hoanganhidi0822/Self-Blancing-Robot/HardwareDesign/65mm-wheel-1.snapshot.1/蓝色轮胎/图片/1660324081173.jpg

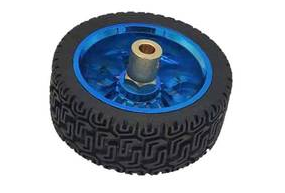
HardwareDesign/65mm-wheel-1.snapshot.1/蓝色轮胎/图片/1660324081173.jpg
