hoanganhidi0822/Self-Blancing-Robot/HardwareDesign/l298-module-1.snapshot.14/L298.PNG

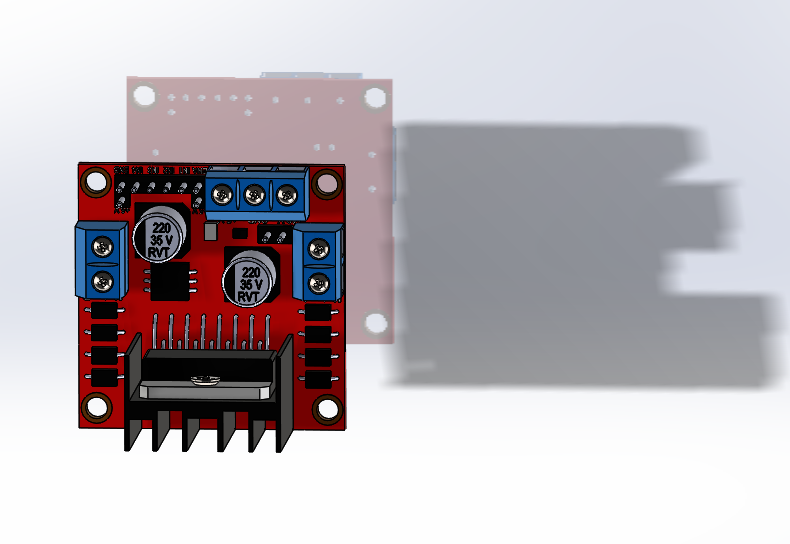
HardwareDesign/l298-module-1.snapshot.14/L298.PNG
