hoanganhidi0822/Self-Blancing-Robot/ThamKhao/Nhom9_SangT4/Nhom9_SangT4/Xe2BanhTuCanBan_PID.docx

BỘ GIÁO DỤC VÀ ĐÀO TẠO

TRƯỜNG ĐẠI HỌC SƯ PHẠM KỸ THUẬT TP.HCM

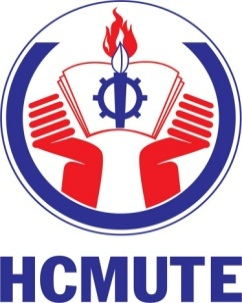
[picture p27: figure]

BÀI BÁO CÁO CUỐI KỲ

THIẾT KẾ, MÔ PHỎNG XE HAI BÁNH TỰ CÂN BẰNG SỬ DỤNG BỘ ĐIỀU KHIỂN PID

TIẾT HỌC: Thứ tư, Tiết 1 - 5

NHÓM THỰC HIỆN : Nhóm 9

GIẢNG VIÊN HƯỚNG DẪN: GV. Nguyễn Văn Đông Hải

Thành viên: Mã số sinh viên:

Bùi Lê Anh 19151099

Nguyễn Ngọc Sơn 19151002

Đào Anh Vũ 19151199

TP.HỒ CHÍ MINH – 11/2021

TRƯỜNG ĐH SƯ PHẠM KỸ THUẬT TPHCM | CỘNG HÒA - XÃ HỘI - CHỦ NGHĨA - VIỆT NAM Độc Lập - Tự Do - Hạnh Phúc
*** | Tp. Hồ Chí Minh, Ngày 21 tháng 11 năm 2021

BÁO CÁO CUỐI KỲ MÔN

THỰC TẬP HỆ THỐNG ĐIỀU KHIỂN TỰ ĐỘNG

Giảng viên hướng dẫn: Thầy Nguyễn Văn Đông Hải

Sinh viên thực hiện: Bùi Lê Anh – 19151099

Nguyễn Ngọc Sơn – 19151002

Đào Anh Vũ – 19151199

Tên đề tài: Thiết kế, mô phỏng xe hai bánh tự cân bằng sử dụng bộ điều khiển PID

Nhận xét của giảng viên:

………………………………………………………………………………………

………………………………………………………………………………………

………………………………………………………………………………………

………………………………………………………………………………………

………………………………………………………………………………………

………………………………………………………………………………………

………………………………………………………………………………………

………………………………………………………………………………………

………………………………………………………………………………………

………………………………………………………………………………………

………………………………………………………………………………………

………………………………………………………………………………………

Ngày 21 tháng 11 năm 2021

Giảng viên chấm điểm

# Chương 1: GIỚI THIỆU

## 1.1 Đặt vấn đề

Tự động hóa đang là xu hướng phát triển của thế giới, dần thay thế nhân công bằng các thiết bị máy móc tự động trong dây chuyển sản xuất. Nghiên cứu về robot đặc biệt là robot di động là một phần quan trọng trong ngành tự động hóa. Xe hai bánh tự cần bằng là một đề tài rất quen thuộc và được rất nhiều kỹ sư trên thế giới chú ý. Ta phải thiết kế bộ điều khiển sao cho xe có thể cân bằng trong mọi địa hình, trong bất cứ thời tiết nào và trong bất kỳ tình huống nào. Từ đó ta có thể ứng dụng vào đời sống giúp giảm thiểu tai nạn khi xe mất tự chủ hay áp dụng vào các nhà máy vận chuyển hàng giảm thiểu tối đa về kinh tế,…. Chúng em nhận thấy được tầm quan trọng trong nghiên cứu về xe hai bánh tự cân bằng nên chúng em đã chọn đề tài: “Thiết kế mô hình xe hai bánh tự cân bằng với bộ điều khiển PID”. Do kiến thức và kinh nghiệm vẫn chưa nhiều nên sẽ có những sai sót trong bài báo cáo, mong thầy và các bạn đọc thông cảm.

## 1.2 Mục tiêu nghiên cứu

+ Nắm cơ bản các khái niệm về robot di động

+ Ứng dụng lý thuyết đã học để thiết kế thành công bộ điều khiển cho xe hai bánh tự cân bằng.

+ Rèn luyện kỹ năng mô phỏng dung MATLAB và SIMULINK

+ Hiểu các quy trình nghiên cứu và thiết kế một hệ thống.

## 1.3 Phương pháp nghiên cứu

+ Đọc sách và tham khảo các nguồn trên mạng mô phỏng xe hai bánh tự cân bằng

+ Tìm kiếm các báo về giải thuật PID cho xe tự cân bằng

+ Tham khảo giảng viên hướng dẫn và bạn bè

+ Thực hiện chứng minh lý thuyết và mô phỏng song song.

## 1.4 Bố cục của đề tài

Chương 1 : Giới thiệu đề tài

Chương 2: Cơ sở lý thuyết về bộ điều khiển PID

Chương 3: Mô phỏng

Chương 4: Kết luận

# Chương 2: CƠ SỞ LÝ THUYẾT

## 2.1 Bộ điều khiển PID

Một hệ thống làm việc tốt là một hệ thống hoạt động tối ưu theo một tiêu chuẩn đạt ra nhất định (đạt cực trị). Trạng thái tối ưu có đạt được và duy trì hay không tùy thuộc vào vào yêu cầu chất lượng đặt ra, các tác động lên đối tượng và điều kiện làm việc của đối tượng. Một trong những bộ điều khiển giúp đối tượng có thể hoạt động tối ưu theo ý muốn của người sử dụng là bộ điều khiển PID

Ta có sơ đồ bộ điều khiển PID như sau:

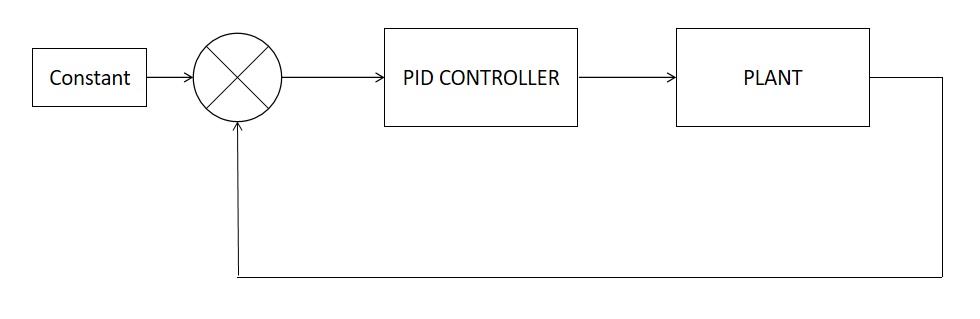
[picture p28: figure]

Hinh 1: Sơ đồ bộ điều khiển PID

Để thiết kế bộ điều khiển PID ta phải thiết bộ điều khiển hồi tiếp âm để được giá trị sai số giữa ngõ ra với giá trị đặt sau đó đưa vào bộ điều khiển PID. Từ bộ PID sẽ cấp điện áp để điều khiển 2 động cơ sao cho hệ thống đạt vị trí cân bằng

## 2.2 Mô hình và các ký hiệu

Ta có mô hình xe hai bánh tự cân bằng như sau:

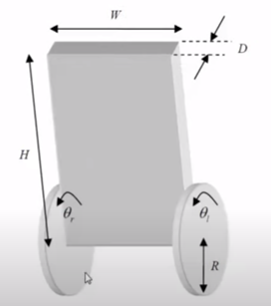
[picture p29: figure]

Mô hình xe hai bánh tự cân bằng

Một số ký hiệu đặc trưng cho xe 2 bánh tự cân bằng:

Kí hiệu | Đơn vị | Ý nghĩa
Mp | Kg | Khối lượng robot
Mw | Kg | Khối lượng bánh xe
R | m | Bán kính bánh xe
θ_P | rad | Góc nghiêng của thân robot
θ_w | rad | Góc xoay của bánh xe
θ_W | Rad/s | Vận tốc góc của bánh xe
r | Ohms | Điện trở của động cơ
L | H | Cuộn cảm của động co
kf | Nms/rad | Hệ số ma sát
km | Nm/A | Hệ số moment
Ke | Vs/rad | Hệ số Back emf của động cơ
α | rad/s^2 | Gia tốc góc của động cơ
Va | V | Điện áp cấp cho động cơ
Ve | V | Điện áp phần ứng
i | A | Dòng điện phần ứng
IR | Kgm2 | Moment quán tính của động cơ
τ_m | Nm | Moment của động cơ
Iw | | Moment quán tính của bánh xe
Ip | | Moment quán tính của thân xe
HL,HRPL,PR | | Lực tác động giữa bánh xe và thân robot
l | | Khoảng cách từ tâm bánh xe đến tâm trọng trường của thân xe
CL,CR | | Moment động cơ tác động lên bánh xe
HfL,HfR | | Lực ma sát giữa bánh xe và mặt phẳng
β | | Hệ số hiệu chỉnh

## 2.3 Mô hình động học của xe động cơ DC

[θω]=[0, 10, (−k_m k_e)/(I_R R)][θω]+[0, 0(k_m)/(I_R R), (−1)/(I_R)][V_a τ_a ] (1)

## 2.4 Mô hình động học cho hệ xe 2 bánh tự cân bằng

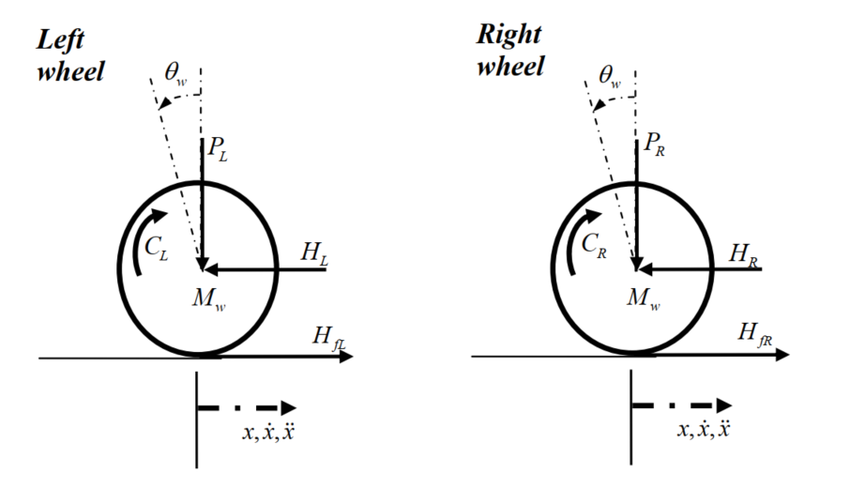
[picture p30: figure]

Phân tích lực tác động lên 2 bánh xe

- Áp dụng định luật Newton tính được tổng lực tác động lên bánh xe theo phương ngang

∑ F_x =Ma (2)

M_w x=H_(fR) −H_R (3)

- Tổng lực tác động vào trục bánh xe

∑ M_o =Iα (4)

I_w θ_w =C_R −H_(fR) r (5)

- Từ phương trình động học của động cơ DC, ta có moment của động cơ

τ_m =I_R (dω)/(dt)+τ_a (6)

- Từ phương trình động học và phương trình vi phân của động cơ DC, ta có moment ngõ ra của động cơ

C=I_R (dω)/(dt)=(−k_m k_e)/Rθ_w +(k_m)/RV_a (7)

- Thay phương trình (7) vào phương trình (5) ta được:

I_w θ_w =(−k_m k_e)/Rθ_w +(k_m)/RV_a −H_(fR) r (8)

- Suy ra:

H_(fR) =(−k_m k_e)/(Rr)θ_w +(k_m)/(Rr)V_a −(I_w)/rθ_w (9)

- Phương trình cho bánh trái

M_w x=(−k_m k_e)/(Rr)θ_w +(k_m)/(Rr)V_a −(I_w)/rθ_w −H_L (10)

- Phương trình cho bánh phải

M_w x=(−k_m k_e)/(Rr)θ_w +(k_m)/(Rr)V_a −(I_w)/rθ_w −H_R (11)

- Vì chuyển động tuyến tính tác dụng lực lên trục động cơ, vận tốc góc có thể chuyển thành vận tốc tuyến tính theo phương trình sau:

θ_w r=x ⟹θ_w =x/r

θ_w r=x ⟹θ_w =x/r

- Từ 2 phương trình trên ta có thể có phương trình của bánh trái và phải như sau:

M_w x=(−k_m k_e)/(Rr)x/r+(k_m)/(Rr)V_a −(I_w)/rx/r−H_L

M_w x=(−k_m k_e)/(Rr)x/r+(k_m)/(Rr)V_a −(I_w)/rx/r−H_R

- Tính tổng 2 phương trình 2 bánh:

2(M_w +(I_w)/(r^2))x=(−2k_m k_e)/(Rr^2)x+(2k_m)/(Rr^2)V_a −(H_L +H_R ) (12)

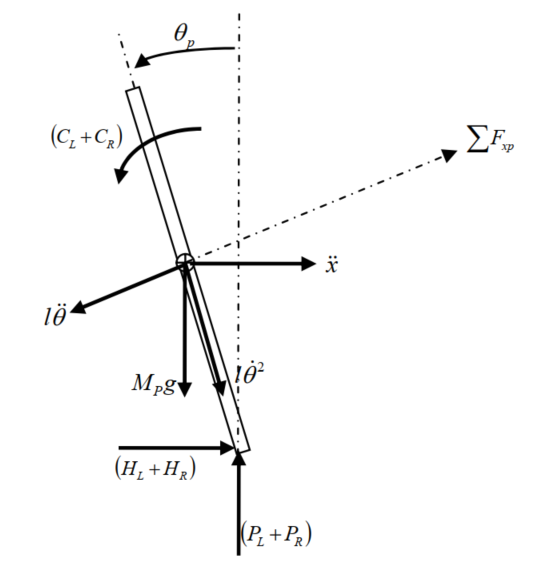
[picture p31: figure]

Phân tích lực tác động lên thân bánh xe

- Áp dụng định luật Newton tính được tổng lực tác động lên bánh xe theo phương ngang

∑ F_x =M_p x

(H_L +H_R )−M_p lθ_p cosθ_p +M_p lθ^2 _p sinθ_p =M_p x

- Ta được:

(H_L +H_R )=M_p x+M_p lθ_p cosθ_p +M_p lθ^2 _p sinθ_p (13)

- Lực vuông góc tác động lên thân xe:

∑ F_(xp) =M_p xcosθ_p

(H_L +H_R )cosθ_p +(P_L +P_R )sinθ_p −M_p gsinθ_p −M_p lθ_p =M_p xcosθ_p (14)

- Tổng moment tác động lên trọng tâm của thân xe:

∑ M_o =Iα

−(H_L +H_R )lcosθ_p −(P_L +P_R )lsinθ_p −(C_L +C_R )=I_p θ_p (15)

- Ta có:

C_L +C_R =(−2k_m k_e)/Rx/r+(2k_m)/RV_a

- Thay vào phương trình 15 ta có:

−(H_L +H_R )lcosθ_p −(P_L +P_R )lsinθ_p −((−2k_m k_e)/Rx/r+(2k_m)/RV_a )=I_p θ_p (16 )

- Nhân -l vào phương trình (14) và thế phương trình 16 vào đó ta có:

I_p θ_p −(2k_m k_e)/(Rr)x+(2k_m)/RV_a +M_p glsinθ_p +M_p l^2 θ_p =−M_p lxcosθ_p (18)

- Thế phương trình 13 vào 12 ta có:

2(M_w +(I_w)/(r^2))x=(−2k_m k_e)/(Rr^2)x+(2k_m)/(Rr^2)V_a −M_p x−M_p lθ_p cosθ_p +M_p lθ^2 _p sinθ_p (19)

- Hai phương trình (18) (19) là hệ phương trình phi tuyến của hệ thống. Để tuyến tính hóa mô hình trên ta cho θ_p =π+ϕ với ϕ là 1 góc nhỏ theo phương thẳng đứng lên trên. Từ đó ta có:

cosθ_p =−1

sinθ_p =−ϕ

((dθ_p)/(dt))^2 =0

- Từ đó ta có mô hình tuyến tính hóa của hệ thống:

(I_p +M_p l^2 )ϕ−(2k_m k_e)/(Rr)x+(2k_m)/RV_a −M_p glϕ=M_p lx (20)

(2k_m)/(Rr)V_a =(2M_w +(2I_w)/(r^2)+M_p )x+(2k_m k_e)/(Rr^2)x−M_p lϕ (21)

- Để có được mô hình biến trạng thái của hệ thống ta rút các biến trạng thái từ phương trình (20) và (21), ta có:

ϕ=(M_p l)/(I_p +M_p l^2)x+(2k_m k_e)/(Rr(I_p +M_p l^2 ))x−(2k_m)/(R(I_p +M_p l^2 ))V_a +(M_p gl)/(R(I_p +M_p l^2 ))ϕ

x=(2k_m)/(Rr(2M_w +(2I_w)/(r^2)+M_p ))V_a −(2k_m k_e)/(Rr^2 (2M_w +(2I_w)/(r^2)+M_p ))x+(M_p l)/((2M_w +(2I_w)/(r^2)+M_p ))ϕ

- Bằng cách thay 2 phương trình trên vào lần lượt các phương trình (20) và (21) ta được hệ không gian trạng thái như sau:

[xϕ]=[0, 1, 0, 0, (2k_m k_e (M_p lr−I_p −M_p l^2 ))/(Rr^2 α), (M_p ^2 gl^2)/α, 000, 0(2k_m k_e (rβ−M_p l))/(Rr^2 α), 0(M_p glβ)/α, 10][xϕ]+[0(2k_m (I_p +M_p l^2 −M_p lr))/(Rr^2 α)0(2k_m (M_p l−rβ))/(Rrα)]V_a

- Với:

β=(2M_w +(2I_w)/(r^2)+M_p )

α=[I_p β+2M_p l^2 (M_w +(I_w)/(r^2))]

Với mô hình trên, chỉ đúng khi xe luôn nằm trên mặt phẳng và bỏ qua ma sát của bánh xe với mặt phẳng, và lực tác động là không đáng kể

# Chương 3: MÔ PHỎNG

## 3.1 Khai báo, khảo sát hệ thống và xây dựng bộ điều khiển

- Đầu tiên để tiến hành xây dựng bộ điều khiển ta cần khai báo giá trị của các biến trong hệ thống cũng như khảo sát hệ thống có điều khiển được hay không và có thể quan sát được các biến trạng thái hay không cũng như tính ổn định của hệ thống.

### 3.1.1 Khai báo thông số hệ thống

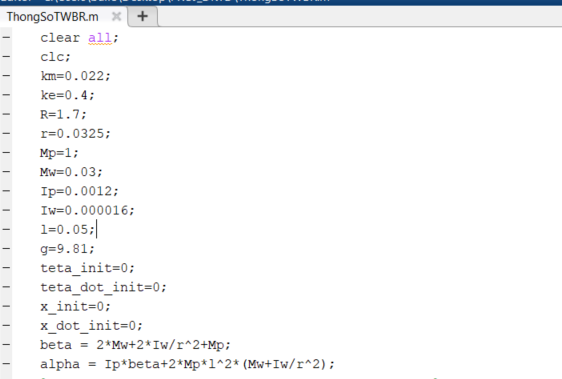
[picture p32: figure]

### 3.1.2 Khảo sát tính ổn định của hệ thống

- Sử dụng MATLAB để tính hàm truyền và nghiệm của hệ thống

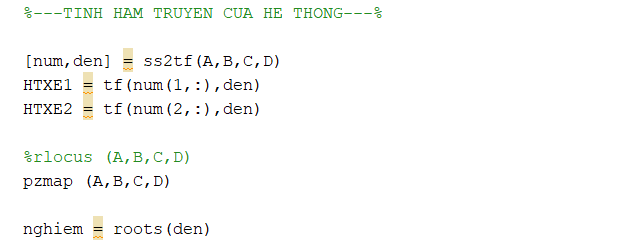
[picture p33: figure]
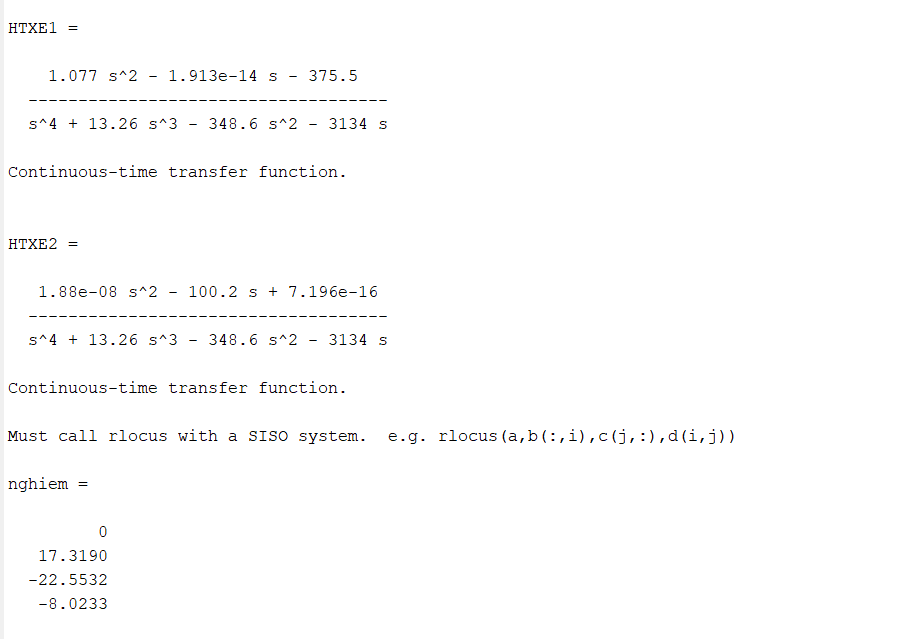
[picture p34: figure]
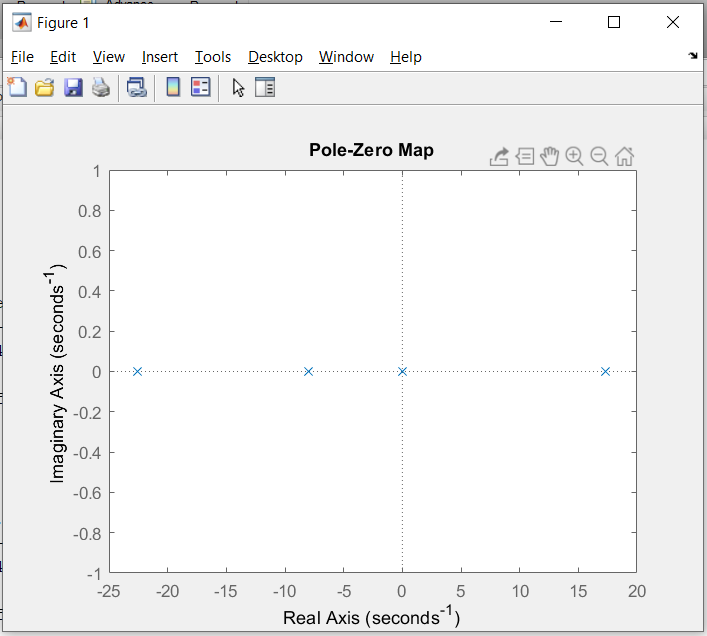
[picture p35: figure]

- Dựa vào nghiệm của hàm truyền và các cực, zero của hệ thống ta có thể kết luận hệ thống không ổn định theo tiêu chuẩn Routh Hurwitz.

### 3.1.3 Khảo sát tính điều khiển được của hệ thống

- Dựa vào lí thuyết điều khiển tự động với 1 hệ tuyến tính có phương trình không gian trạng thái dạng như sau:

x=Ax+Bu

y=Cx+Du

- Với A∈ℝ^(nxn) , B∈ℝ^(nxu) , C∈ℝ^(rxn) , D∈ℝ^(rxm)
- Xây dựng ma trận điều khiển:

P=[B, AB, A^2 B,...,A^(n−1) B]

- Điều kiện cần và đủ để một hệ thống mô tả toán học dưới dạng phương trình trạng thái điều khiển được là rank(P)=n. Với n là số biến trạng thái của hệ thống.
- Ta sử dụng matlab để kiểm chứng hệ thống

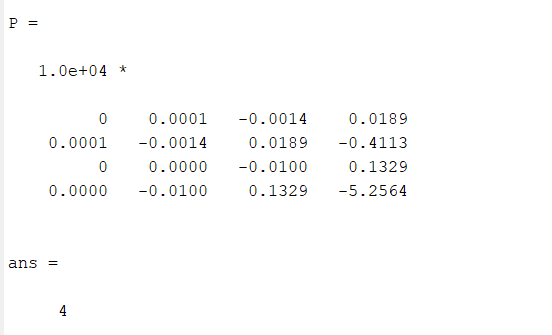
[picture p36: figure]

Bậc của ma trận P bằng với số biến trạng thái của hệ thống

### 3.1.4 Khảo sát tính quan sát được của hệ thống

- Ta lựa chọn ma trận C=[1, 0, 0, 00, 0, 1, 0]
- Ta có C.x(t) = [1, 0, 0, 00, 0, 1, 0][xxϕϕ]=[x, ϕ]
- Xây dựng ma trận quan sát:

L=[C, AC, A^2 C, ..., A^(n−1) C]

- Ta sử dụng matlab để kiểm chứng hệ thống

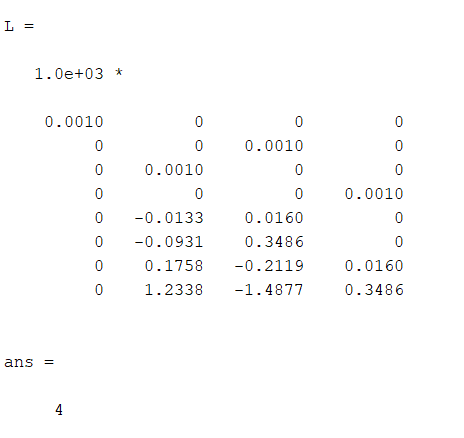
[picture p37: figure]

Bậc của ma trận P bằng với số biến trạng thái của hệ thống

- Nhận xét: Từ 2 kiểm chứng trên ta có thể kết luận hệ thống có thể điều khiển được và ta có thể quan sát được cả 4 biến trạng thái của hệ thống. Và thông qua việc ta đặt ma trận C để có thể quan sát được 2 biến trạng thái là vị trí xe và góc nghiêng của xe thì nếu như 2 biến này ổn định thì có cả hệ thống sẽ ổn định.

### 3.1.5 Xây dựng bộ điều khiển

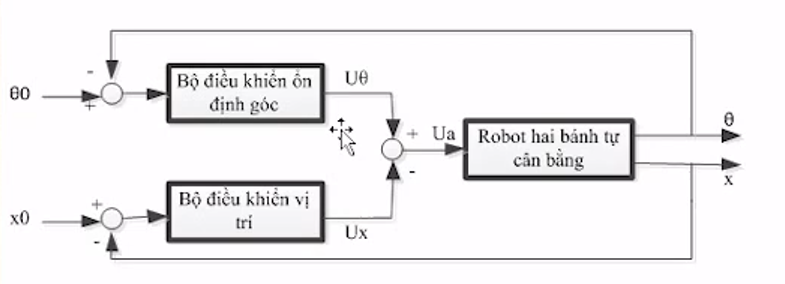
[picture p38: figure]

Mô tả hệ thống với bộ điều khiển

- Ở hệ thống điều khiển xe 2 bánh tự cân bằng, ta phải điều khiển ổn định 2 tham số là góc nghiêng và vị trí của hệ thống nên ta tách ra thành 2 bộ điều khiển song song hoặc lồng nhau và hiệu chỉnh các thông số Kp Ki Kd để điều khiển được điện áp cấp cho động cơ để có được đáp ứng mong muốn.
- Để điều khiển ổn định được xe cân bằng trước tiên ta phải hiệu chỉnh ổn định được góc nghiêng của xe trước sau đó ta hiệu chỉnh để ổn định tiếp bộ điều khiển vị trí cho xe.

## 3.2 Xây dựng mô hình Matlab Simulink

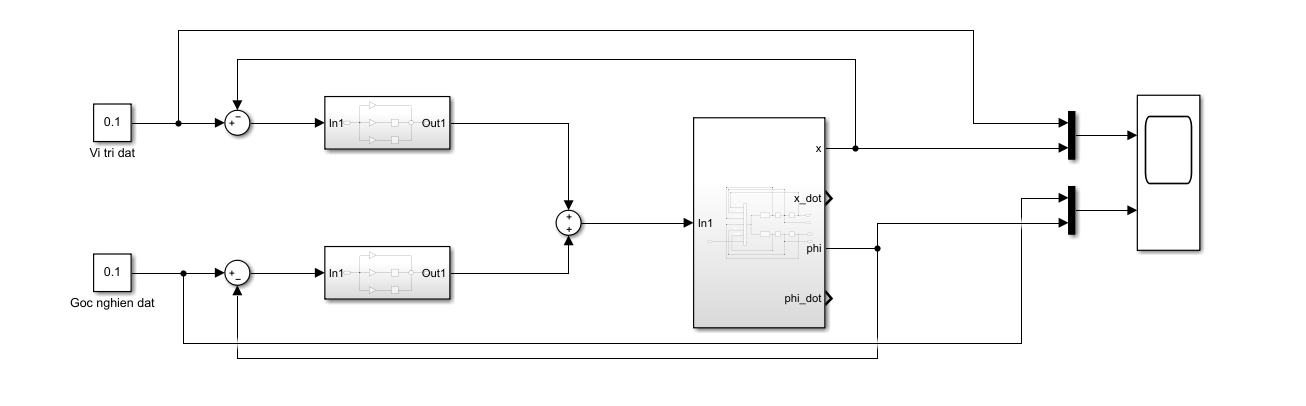
[picture p39: figure]

Toàn bộ hệ thống với bộ điều khiển

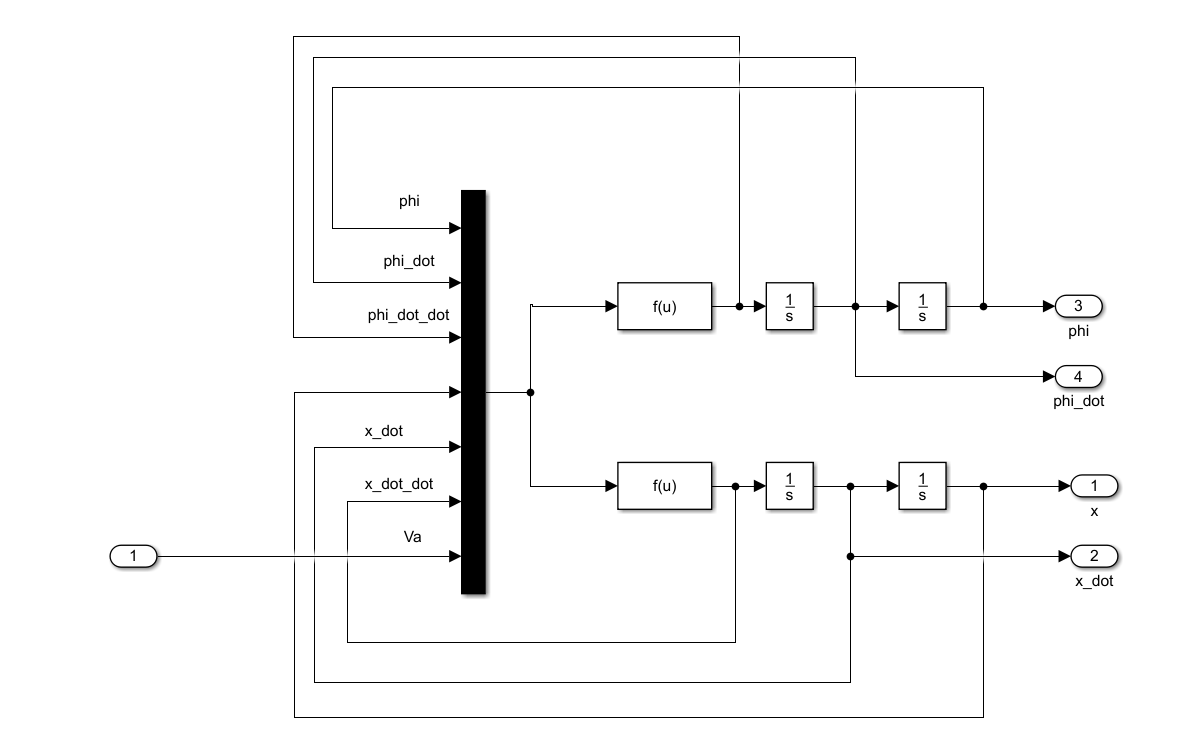
[picture p40: figure]

Khối mô tả phương trình không gian trạng thái của hệ thống

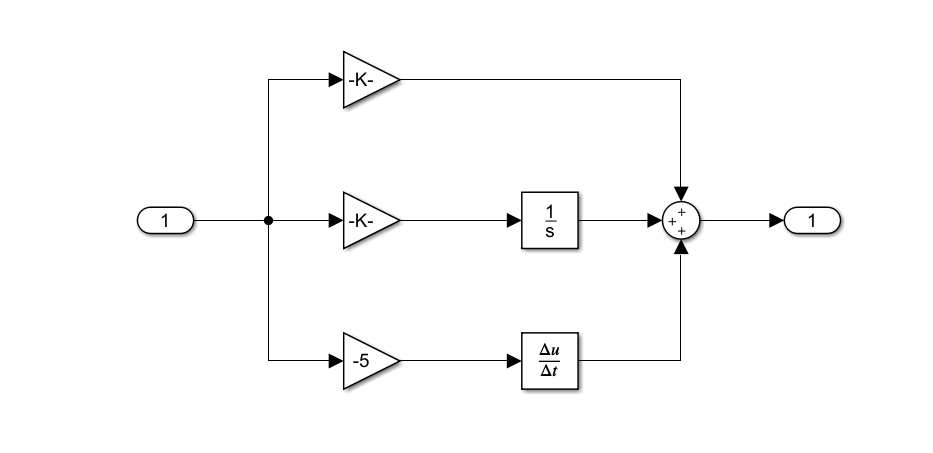
[picture p41: figure]

Bộ điều khiển PID vị trí của hệ thống với Kp = 1143, Ki = 1940.4, Kd = -5

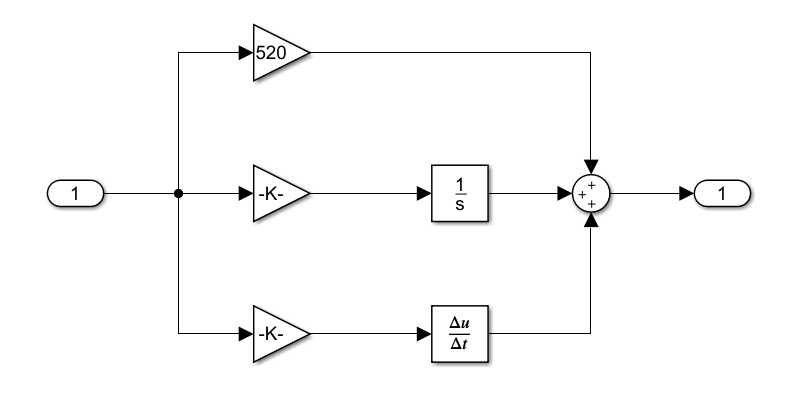
[picture p42: figure]

Bộ điều khiển PID góc nghiêng của hệ thống Kp = 520, Ki = 1550.5, Kd = 23.28

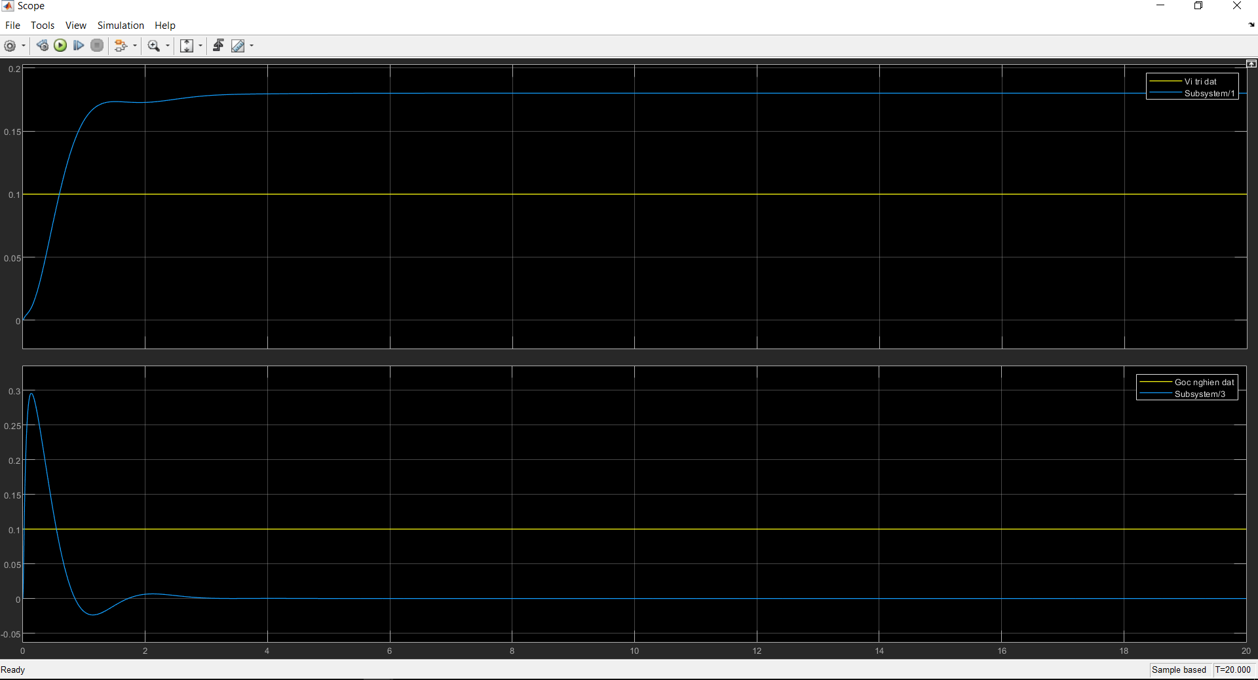
[picture p43: figure]

Đáp ứng của hệ thống

- Nhận xét: Qua quá trình thử sai và có thử qua giải thuật di truyền để tìm được thông số PID phù hợp với hệ thống nhóm đã điều khiển đạt được xe 2 bánh tự cân bằng. Hệ thống ổn định với thời gian trong khoảng 3s cũng như có độ vọt lố chấp nhận được đối với bộ điều khiển vị trí và điều khiển được xe tự cân bằng với góc nghiêng bằng 0 độ. Nhóm thử qua giải thuật pid_GA của thầy Huỳnh Thái Hoàng qua sự hướng dẫn của thầy Nguyễn Văn Đông Hải tuy nhiên nhóm vẫn chưa đạt được kết quả mong muốn, nhóm sẽ tìm hiểu thêm về giải thuật di truyền và hoàn thiện trong tương lai.

# Chương 4: KẾT LUẬN

## 4.1 Kết quả

Theo kết quả đã mô phỏng ở trên, ta nhận thấy khi thay đổi giá trị đặt ban đầu thì hệ thống sẽ đáp ứng lâu hơn, độ vọt lố cũng tăng hơn. Mặc dù vậy nhưng xe vẫn có thể ổn định sau một khoảng thời gian. Vì vậy ta có thể sử dụng bộ điều khiển PID để sử dụng cho xe 2 bánh tự cân bằng nhưng phải chọn các thông số ban đầu sao cho hợp lý.

## 4.2 Hướng phát triển

- Kết hợp xe hai bánh tự cân bằng dùng bộ điều khiển PID kết hợp với LQR
- Khảo sát xe trên một số môi trường không bằng phẳng
- Kết hợp một số phương pháp để điều khiển được xe

## 4.3 Nhận đinh chung

Qua việc “Thiết kế xe hai bánh tự cân bằng sử dụng bộ điều khiển PID” đã giúp cho nhóm hiểu thêm về các bộ điều khiển và các hệ thống ở bộ môn Hệ thống điều khiển tự động. Ngoài ra còn giúp chúng em hiểu rõ hơn các kiến thức, kỹ năng sử dụng phần mềm mô phỏng những hệ thống thực cụ thể ở đây là Matlab.

Sau một thời gian được giao nhiệm vụ thiết kế về bài tập lớn bên trên, dưới sự hướng dẫn tận tình của giảng viên, cùng các bạn trong bộ môn chúng em đã hoàn thành nhiệm vụ của mình. Do thời gian có hạn, chưa có nhiều kinh nghiệm thực tế, bài báo cáo của chúng em không tránh khỏi thiếu sót, rất kính mong thầy thông cảm. Chúng em cảm ơn thầy vì đã hết sức hỗ trợ chúng em trong thời gian thực hiện bài tập lơns, chúng em sẽ cố gắng nâng cao kiến thức cũng như kỹ năng của mình để có thể áp dụng vào đời sống sau này.
