hoanganhidi0822/Self-Blancing-Robot/xecanbang-dieu-khien-xe-hai-banh-tu-can-bang-voi-thuat-toan-pid.pdf

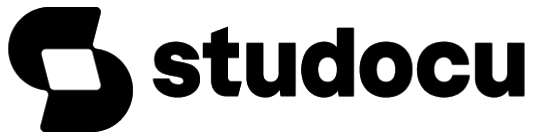
[picture p44: figure]

Studocu is not sponsored or endorsed by any college or university

# Xecanbang - điều khiển xe hai bánh tự cân bằng với thuật

toán PID (https://www.studocu.com/vn/document/truong-dai-hoc-bach-khoa-dai-hoc-da-nang/ky-thuat-do-luong/xecanbang-dieu-khien-xe-hai-banh-tu-can-bang-voi-thuat-toan-pid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)

Kỹ thuật đo lường (Trường Đại học Bách Khoa - Đại học Đà Nẵng) (https://www.studocu.com/vn/course/truong-dai-hoc-bach-khoa-dai-hoc-da-nang/ky-thuat-do-luong/5149461)

Downloaded by Hoàng Anh Phan V?n (hoanganh2282003@gmail.com)

lOMoARcPSD|10675608

BỘ GIÁO DỤC VÀ ĐÀO TẠO

TRƯỜNG ĐẠI HỌC SƯ PHẠM KỸ THUẬT TP. HỒ CHÍ MINH

KHOA ĐIỆN – ĐIỆN TỬ

BỘ MÔN TỰ ĐỘNG ĐIỀU KHIỂN

## ĐỒ ÁN TỐT NGHIỆP

NGÀNH: CÔNG NGHỆ ĐIỆN TỰ ĐỘNG

ĐỀ TÀI:

# MÔ HÌNH ROBOT HAI BÁNH TỰ CÂN BẰNG

GVHD : TS. NGUYỄN MINH TÂM

SVTH: | Cù Minh Phước
| Nguyễn Khắc Mẫn
MSSV: | 09118042
| 09118032

Tp. Hồ Chí Minh 07/2013

Phần A: Giới thiệu

### PHẦN A

# GIỚI THIỆU

Đồ án tốt nghiệp | Trang 1

ĐỒ ÁN ĐƯỢC HOÀN THÀNH TẠI

TRƯỜNG ĐẠI HỌC SƯ PHẠM KỸ THUẬT TP. HỒ CHÍ MINH

Cán bộ hướng dẫn: | TS. Nguyễn Minh Tâm
Sinh viên thực hiện: | Cù Minh Phước
| Nguyễn Khắc Mẫn
Cán bộ chấm phản biện: | |

Đồ án tốt nghiệp được bảo vệ tại HỘI ĐỒNG CHẤM BẢO VỆ ĐỒ ÁN TỐT NGHIỆP TRƯỜNG ĐẠI HỌC SƯ PHẠM KỸ THUẬT TP. HỒ CHÍ MINH.

Ngày ... tháng 07 năm 2013

TRƯỜNG ĐH SƯ PHẠM KỸ THUẬT | CỘNG HÒA XÃ HỘI CHỦ NGHĨA VIỆT NAM
TP. HỒ CHÍ MINH | ĐỘC LẬP - TỰ DO - HẠNH PHÚC

KHOA ĐIỆN - ĐIỆN TỬ

Tp. HCM, ngày … tháng 7 năm 2013

## NHIỆM VỤ ĐỒ ÁN TỐT NGHIỆP

Họ tên sinh viên: | Cù Minh Phước | MSSV: 09118042
Nguyễn Khắc Mẫn | MSSV: 09118032
Chuyên ngành: | Điện tự động | Mã ngành: 18
Hệ đào tạo: | Đại học chính quy | Mã hệ: | 1
Khóa: | 2009 | Lớp: | 091180
I. TÊN ĐỀ TÀI: MÔ HÌNH ROBOT HAI BÁNH TỰ CÂN BẰNG

II. NHIỆM VỤ VÀ NỘI DUNG:
Đồ án tốt nghiệp | Trang 2

III. NGÀY GIAO NHIỆM VỤ: | 10/04/2013

IV. NGÀY HOÀN THÀNH NHIỆM VỤ: 15/7/2013

V. HỌ VÀ TÊN CÁN BỘ HƯỚNG DẪN:TS. Nguyễn Minh Tâm
CÁN BỘ HƯỚNG DẪN | BM. TỰ ĐỘNG ĐIỀU KHIỂN
TS. NGUYỄN MINH TÂM | TS. NGUYỄN MINH TÂM

# LỜI CẢM ƠN

&

Trong suốt quá trình thực hiện đề tài, mặc dù gặp phải nhiều khó khăn nhưng được sự giúp đỡ, hỗ trợ kịp thời từ quý Thầy Cô và các bạn nên Đồ án tốt nghiệp đã hoàn thành đúng tiến độ. Nhóm thực hiện xin chân thành cảm ơn thầy Nguyễn Minh Tâm đã tận tình hướng dẫn, chỉ bảo kinh nghiệm quý báu cũng như hỗ trợ phương tiện thí nghiệm trong suốt quá trình tìm hiểu, nghiên cứu đề tài.

Đồng thời Nhóm thực hiện cũng xin chân thành cảm ơn các Thầy Cô trong Khoa Điện - Điện Tử đã tạo điều kiện, cung cấp cho nhóm những kiến thức cơ bản, cần thiết để chúng em có điều kiện và đủ kiến thức để thực hiện quá trình nghiên cứu.

Bên cạnh đó, nhóm cũng xin cảm ơn các thành viên trong lớp 091180 đã có những ý kiến đóng góp, bổ sung, cũng như động viên khích lệ giúp nhóm hoàn thành tốt đề tài.

Ngoài ra, nhóm cũng đã nhận được sự chỉ bảo của các anh (chị) đi trước. Các anh (chị) cũng đã hướng dẫn và giới thiệu tài liệu tham khảo thêm trong việc thực hiện nghiên cứu.

Mặc dù nhóm thực hiện đề tài đã cố gắng hoàn thiện được quyển đồ án, nhưng trong quá trình soạn thảo cũng như kiến thức còn hạn chế nên có thể còn nhiều

Đồ án tốt nghiệp | Trang 3

thiếu sót. Nhóm thực hiện đề tài mong nhận được sự đóng góp ý kiến của quý thầy cô cùng các bạn sinh viên.

Sau cùng nhóm thực hiện xin chúc Thầy cô sức khoẻ, thành công và tiếp tục đào tạo những sinh viên giỏi đóng góp cho đất nước. Chúc các anh (chị), các bạn sức khỏe, học tập thật tốt để không phụ công lao các Thầy Cô đã giảng dạy. Nhóm thực hiện xin chân thành cảm ơn.

Trân trọng

Nhóm thực hiện đồ án

Cù Minh Phước

Nguyễn Khắc Mẫn

Đồ án tốt nghiệp | Trang 4

## NHẬN XÉT CỦA GIÁO VIÊN PHẢN BIỆN

Tp. HCM, ngày … tháng … năm 2013

## Giáo viên phản biệnNHẬN XÉT CỦA GIÁO VIÊN HƯỚNG DẪN

Đồ án tốt nghiệp | Trang 5

Tp. HCM, ngày … tháng … năm 2013

Giáo viên hướng dẫn

TS. Nguyễn Minh Tâm

Đồ án tốt nghiệp | Trang 6

### PHẦN B

# NỘI DUNG

Danh sách các hình ảnh sử dụng trong đồ án:

Hình 1.1: | Robot dạng 3 bánh xe di chuyển trên địa hình bằng phẳng
Hình 1.2: | Robot dạng 3 bánh xe khi xuống dốc
Hình 1.3: | Robot dạng 3 bánh xe khi lên dốc
Hình 1.4: | Robot 2 bánh di chuyển trên các địa hình khác nhau theo hướng bảo toàn
sự thăng bằng
Hình 1.5: | nBot
Hình 1.6: | JOE
Hình 1.7: | NXTway-GS của LEGO MINDSTORMS
Hình 1.8: | Xe Segway I2, I2 cargo, X2 Adventure
Hình 1.9: | Xe Winglet

Hình 1.10: Xe Iswing

Hình 2.1: | Mô hình robot 2 bánh tự cân bằng trên mặt phẳng
Hình 2.2: | Mô hình phi tuyến của robot hai bánh tự cân bằng trong Matlab Simulink
Hình 2.3: | Bên trong khối “Two Wheeled Balancing Robot (Non-Linear Model)”
Hình 2.4: | Bên trong khối “DeCoupling”
Hình 2.5: | Quy trình thực hiện của bộ lọc Kalman
Hình 2.6: | Tổng quan chu trình thực hiện bộ lọc Kalman hoàn chỉnh
Hình 2.7: | Cấu trúc bộ điều khiển PID cho hệ robot hai bánh tự cân bằng
Hình 2.8: | Cấu trúc bên trong bộ điều khiển PID rời rạcvới thông số cố định.
Hình 2.9: | Robot hai bánh tự cân bằng sử dụng 3 bộ điều khiển PID cố định.

Hình 2.10: Đáp ứng ngõ ra vị trí với tín hiệu đặt vị trí là xung vuông
Đồ án tốt nghiệp | Trang 7

Hình 2.11: Đáp ứng ngõ ra góc nghiêng với tín hiệu đặt góc nghiêng là xung vuông

Hình 2.12: Đáp ứng ngõ ra góc xoay với tín hiệu đặt góc xoay là xung vuông

Hình 2.13: Đáp ứng ngõ ra vị trí với tín hiệu đặt vị trí là sóng sine

Hình 2.14: Đáp ứng ngõ ra góc nghiêng với tín hiệu đặt góc nghiêng là sóng sine

Hình 2.15: Đáp ứng ngõ ra góc xoay với tín hiệu đặt góc xoay là sóng sine

Hình 2.16: đáp ứng ngõ ra vị trí trong trường hợp tín hiệu đặt vị trí là xung vuông

Hình 2.17: đáp ứng ngõ ra góc nghiêng trong trường hợp tín hiệu đặt góc nghiêng là xung vuông

Hình 2.18: đáp ứng ngõ ra vị trí trong trường hợp tín hiệu đặt vị trí là xung vuông

Hình 2.19: đáp ứng ngõ ra góc nghiêng trong trường hợp tín hiệu đặt góc nghiêng là xung vuông

Hình 2.20: Pin Li-Po 11.1V/2200mA

Hình 2.21: DSP TMS320F28335

Hình 2.22: Razor IMU 9DOF

Hình 2.23: Sơ đồ khối cảm biến gia tốc ADXL345

Hình 2.24: Phương và chiều các trục gia tốc tương ứng

Hình 2.25: Đáp ứng giá trị gia tốc ngõ ra tương ứng đối với hướng của trọng lực

Hình 2.26: Sơ đồ chân ngõ ra trên cảm biến gia tốc

Hình 2.27: Sơ đồ khối cảm biến ITG3200

Hình 2.28: Cảm biến HMC5883L

Hình 2.29: Sơ đồ nguyên lý mạch cầu H

Hình 2.30: Mạch cầu H thực tế

Hình 2.31: Encoder

Hình 2.32: Module Bluetooth HC06 slave

Hình 2.33: Động cơ

Hình 3.1: | Bản vẽ 3D mô hình robot 2 bánh tự cân bằng
Đồ án tốt nghiệp | Trang 8

Hình 3.2: | Mô hình robot thực tế
Hình 3.3: | Cấu trúc điều khiển phần cứng của robot 2 bánh tự cân bằng
Hình 3.4: | Sơ đồ kết nối phần cứng
Hình 3.5: | Mô hình bộ lọc Kalman với 3 biến trạng thái.
Hình 3.6: | Mô hình bộ lọc Kalman trong Matlab Simulink
Hình 3.7: | Tín hiệu vào-ra của bộ lọc Kalman
Hình 3.8: | So sánh khi cho tín hiệu góc nghiêng ngõ vào và ra của bộ lọc Kalman
Hình 3.9: | Lưu đồ giải thuật cho mô hình robot 2 bánh tự cân bằng

Hình 3.10: Thư viện Target Support Package cho DSP F28335

Hình 3.11: Sơ đồ tổng quát

Hình 3.12: | Khối đọc các nút nhấn
Hình 3.13: | Bên trong khối calibre
Hình 3.14: | Khối đọc cảm biến IMU
Hình 3.15: | Khối lọc Kalman
Hình 3.16: | Tổng quát Khối điều khiển trung tâm
Hình 3.17: | Bên trong Khối đọc xung encoder Hình 3.18: Bên trong Khối xuất tín hiệu
điều khiển

Hình 3.19: Khối gửi dữ liệu

Hình 3.20: Ngõ ra góc nghiêng và điện áp trên 2 động cơ khi chạy mô hình thực tế

Hình 3.21: Giao diện của chương trình giao tiếp máy tính

Danh sách các bảng sử dụng trong đồ án :

Bảng 2.1: | Ký hiệu và ý nghĩa của các đại lượng
Bảng 3.1: | Bảng giá trị của các đại lượng trong robot 2 bánh tự cân bằng
Bảng 3.2: | Các khối chức năng sử dụng trong chương trình
Đồ án tốt nghiệp | Trang 9

### Mục lục

1.2.2 Một số sản phẩm thực tế dựa trên mô hình robot 2 bánh tự cân bằng......17

### 2.1.2 Mô hình hóa robot hai bánh tự cân bằng trên địa hình phẳng trong

Đồ án tốt nghiệp | Trang 10

Đồ án tốt nghiệp | Trang 11

## Chương 1. Tổng quan về đề tài

### 1.1 Đặt vấn đề

Trong ngành tự động hóa - điều khiển tự động nói chung và điều khiển học nói riêng, mô hình con lắc ngược là một trong những đối tượng nghiên cứu điển hình và đặc thù bởi đặc tính động không ổn định của mô hình nên việc điều khiển được đối tượng này trên thực tế đặt ra như một thử thách.

Kết quả nghiên cứu mô hình con lắc ngược cơ bản, ví dụ như mô hình xe-con lắc, con lắc ngược quay… có thể ứng dụng và kế thừa sang các mô hình tương tự khác nhưng có tính ứng dụng thực tiễn hơn, chẳng hạn như mô hình tên lửa, mô hình xe hai bánh tự cân bằng… do đó khắc phục được những nhược điểm vốn có của các robot hai hoặc ba bánhkinh điển. Các robot hai hoặc ba bánh kinh điển, theo đó có cấu tạo gồm bánh dẫn độngvà bánh tự do (hay bất kì cái gì khác) để đỡ trọng lượng robot. Nếu trọnglượng được đặt nhiều vào bánh lái thì robot sẽ không ổn định và dễ bị ngã, còn nếu đặt vào nhiều bánh đuôi thì hai bánh chính sẽ mất khả năng bám. Nhiều thiết kế robot có thể di chuyển tốt trên địa hình phẳng nhưng không thể di chuyển lên xuống trên địa hình lồi lõm hoặc mặt phẳng nghiêng. Khi di chuyển lên đồi, trọng lượng robot dồn vào đuôi xe làm mất khả năng bám và trượt ngã.

Robot dạng 3 bánh xe di chuyển trên địa hình bằng phẳng trọng lượng được chia đều cho bánh lái và bánh dẫn nhỏ.

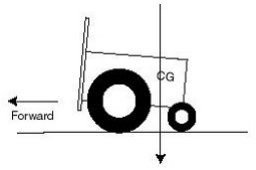
[picture p45: figure]

Hình 1.1 - Robot dạng 3 bánh xe di chuyển trên địa hình bằng phẳng

Robot dạng 3 bánh xe khi xuống dốc, trọng lực dồn vào bánh sau khiến xe có thể bị lật úp.

Đồ án tốt nghiệp | Trang 12

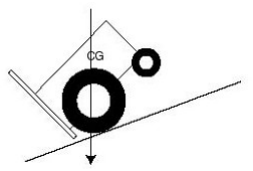
[picture p46: figure]

Hình 1.2 - Robot dạng 3 bánh xe khi xuống dốc

Robot dạng 3 bánh xe khi lên dốc, trọng lượng dồn vào bánh trước khiến lực ma sát giúp xe bám trên mặt đường không được đảm bảo.

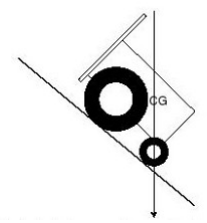
[picture p47: figure]

Hình 1.3 - Robot dạng 3 bánh xe khi lên dốc

Ngược lại, các robot dạng hai bánh đồng trục lại thăng bằng rất linh động khi di chuyển trên địa hình phức tạp, mặc dù bản thân robot là một hệ thống không ổn định. Khi robot di chuyển trên địa hình dốc, nó tự động nghiêng ra trước và giữ cho trọng lượng dồn về hai bánh chính. Tương tự, khi di chuyển xuống dốc, nó nghiêng ra sau và giữ trọng tâm rơi vào bánh chính. Vì vậy, không bao giờ có hiện tượng trọng tâm xe rơi ngoài vùng đỡ bánh xe để có thể gây ra lật úp.

Đồ án tốt nghiệp | Trang 13

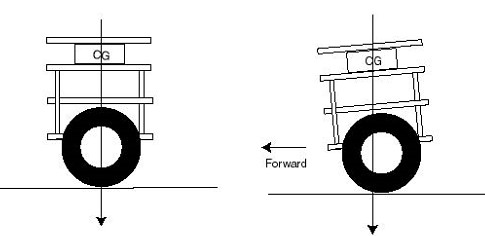
[picture p48: figure]
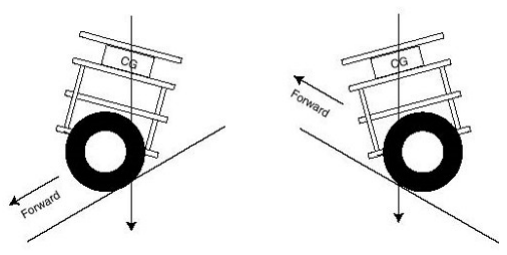
[picture p49: figure]

Hình 1.4 - Robot 2 bánh di chuyển trên các địa hình khác nhau theo hướng bảo toàn sự thăng bằng

### 1.2 Tình hình nghiên cứu robot 2 bánh tự cân bằng hiện nay:

### 1.2.1 Các mô hình robot 2 bánh tự cân bằng

### 1.2.1.1 nBot

Robot nBot do David P.Anderson chế tạo. Nguyên tắc điều khiển nBot như sau: các bánh xe sẽ chạy theo hướng mà phần trên robot sắp ngã, nếu bánh xe có thể được lái theo cách giữ vững trọng tâm robot thì robot sẽ được giữ cân bằng.

Quá trình điều khiển sử dụng tín hiệu từ hai cảm biến: cảm biến góc nghiêng của thân robot so với phương của trọng lực và encoder gắn ở bánh xe để đo vị trí robot. Tín hiệu này hình thành nên 4 biến: góc nghiên thân robot, vận tốc góc nghiêng,

Đồ án tốt nghiệp | Trang 14

vị trí robot và vận tốc robot; 4 biến này được tính toán thành điện áp điều khiển động cơ cho robot.

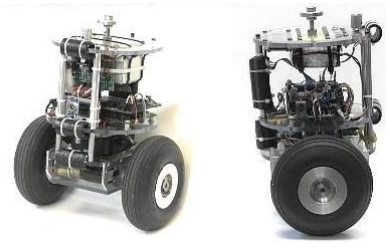
[picture p50: figure]

Hình 1.5: nBot

### 1.2.1.2 JOE

JOE do phòng thí nghiệm điện tử công nghiệp của viện Công nghệ Liên bang Lausanne, Thụy Sĩ tạo ra vào năm 2002. Hình dạng của nó gồm hai bánh xe đồng trục, mỗi bánh gắn với một động cơ DC, robot này có thể chuyển động xoay theo hình chữ
U. Hệ thống điều khiển gồm hai bộ điều khiển “không gian trạng thái” (state space) tách rời nhau, kiểm soátđộng cơ để giữ cân bằng cho hệ thống. Thông tin trạng thái được cung cấp bởi hai encoder quang và hai cảm biến: gia tốc góc và con quay hồi chuyển (gyro). JOE được điều khiển bởi một bộ điều khiển từ xa RC . Bộ điều khiển trung tâm và xử lý tín hiệu là một board xử lý tín hiệu số (DSP) phát triển bởi chính nhóm và của viện Federal, kết hợp với FPGA của XILINC.

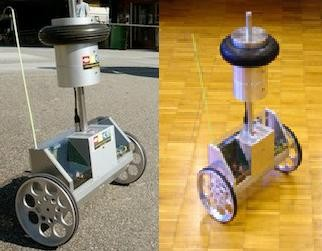
[picture p51: figure]

Hình 1.6: | JOE
Đồ án tốt nghiệp | Trang 15

### 1.2.1.3 NXTway-GS

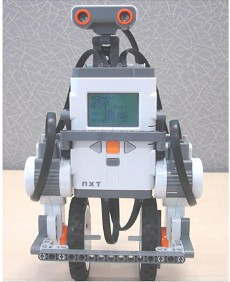
[picture p52: figure]

Hình 1.7: NXTway-GS của LEGO MINDSTORMS

### 1.2.2 Một số sản phẩm thực tế dựa trên mô hình robot 2 bánh tự cân bằng

### 1.2.2.1 Xe Segway

Segway PT (viết tắt của Segway Personal Transporter - Xe cá nhân Segway), thường được gọi tắt là Segway là một phương tiện giao thông cá nhân có hai bánh, hoạt động trên cơ chế tự cân bằng do Dean Kamen phát minh. Loại xe này được sản xuất bởi công ty Segway Inc. ở bangNew Hampshire, Hoa Kỳ. Từ "Segway" phát âm gần giống với "segue" (một từ gốc tiếng Ý có nghĩa "di chuyển nhẹ nhàng").Đặc điểm nổi bật của Segway là cơ chế tự cân bằng nhờ hệ thống máy tính, động cơ và con quay hồi chuyển đặt bên trong xe, nó giúp cho xe dù chỉ có một trục chuyển động với hai bánh nhưng luôn ở trạng thái cân bằng, người sử dụng chỉ việc ngả về đằng trước hoặc đằng sau để điều khiển xe đi tiến hoặc đi lùi.

Đồ án tốt nghiệp | Trang 16

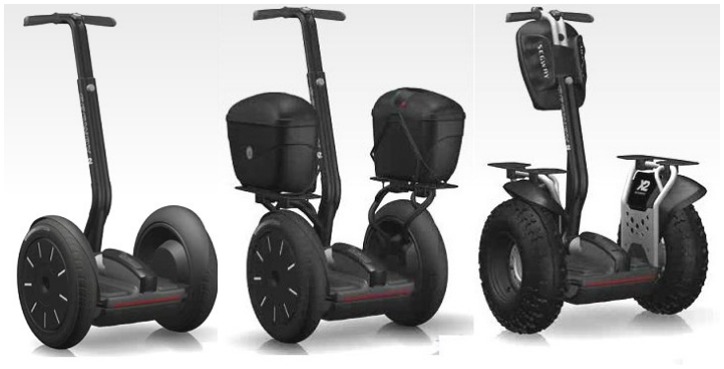
[picture p53: figure]

Hình 1.8: Xe Segway I2, I2 cargo, X2 Adventure

### 1.2.2.2 Xe Winglet

Xe Winglet do hãng Toyota phát triển được giới thiệu năm 2008 có kích thước phần đế chỉ bằng tờ giấy A3. Xe dựa trên mô hình 2 bánh tự cân bằng và có cảm biến để nhận biết cử động của người điều khiển từ đó đưa ra lệnh để xe hoạt động theo ý muốn của người điều khiển.

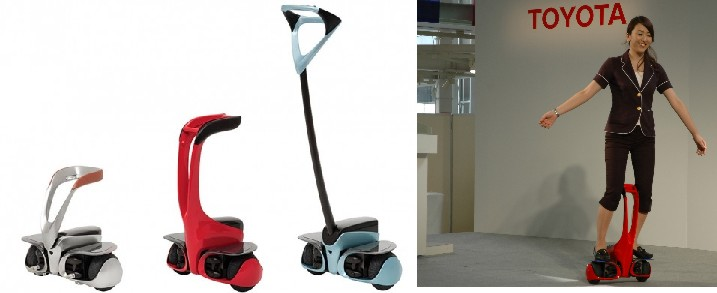
[picture p54: figure]

Hình 1.9: Xe Winglet

### 1.2.2.3 Iswing Toyota:

I-swing được mệnh danh là một trong những ý tưởng táo bạo nhất của ngành công nghiệp ôtô trong thời gian gần đây. Xuất hiện lần đầu tiên tại triển lãm Tokyo 2005, I-swing là biểu tượng cho phương tiện cá nhân trong tương lai bởi nó khác xa so với ôtô thông thường. Sự di chuyển, điều khiển, giao tiếp giữa người và xe đều mang

Đồ án tốt nghiệp | Trang 17

tính nhân bản. Chẳng hạn như khi đặt ghế ở chế độ "thân xe mở tối thiểu", tầm mắt tài xế sẽ ngang với người đang đứng nên rất dễ trò chuyện và tạo cảm giác thân thiện. Iswing được điều khiển thông qua tay nắm và các nút, giống với cách con người sử dụng các thiết bị điện tử hàng ngày.

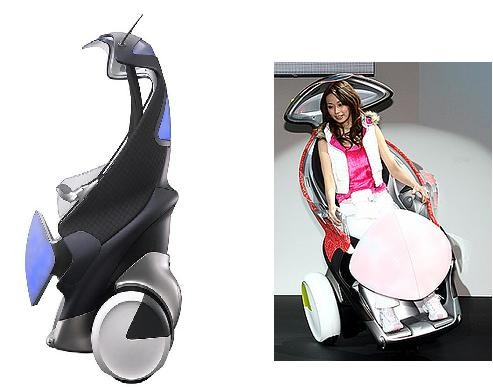
[picture p55: figure]

Hình 1.10: Xe Iswing

### 1.3 Mục tiêu đề tài

Mục tiêu của đề tài là xây dựng mô hình robot 2 bánh tự cân bằng dựa trên nền tảng lý thuyết mô hình con lắc ngược. Trong thời gian làm đề tài, những mục tiêu của đề tài được đặt ra như sau:

− Tìm hiểu các mô hình xe, robot 2 bánh tự cân bằng và các nguyên lý cơ bản về cân bằng.
− Tính toán các thông số động lực học, xây dựng các hàm không gian-trạng thái (state-space) của mô hình.
− Tìm hiểu, lựa chọn các loại cảm biến và bộ điều khiển trung tâm. Trong đề tài này sẽ sử dụng cảm biến IMU 9 DOF và bộ điều khiển DSP F28335.
− Mô phỏng mô hình trên Matlab Simulink.
− Tìm hiểu và áp dụng Bộ lọc Kalman để lọc nhiễu cho cảm biến, xây dựng các thuật toán bù trừ để có giá trị góc chính xác.
− Xây dựng thuật toán điều khiển động cơ, giữ thăng bằng cho robot.
Đồ án tốt nghiệp | Trang 18

### 1.4 Giới hạn đề tài

Trong khuôn khổ của đề tài này, mô hình robot 2 bánh tự cân bằng chỉ đứng hay chạy tiến lùi mà chưa thể xoay vòng hay đi lên dốc được.

Phương pháp điều khiển: chỉ sử dụng phương pháp điều khiển PID với thông số cố định, chưa ứng dụng phương pháp mạng neuron thích nghi, phương pháp mạng toàn phương tuyến tính (LQR)

### 1.5 Phương pháp nghiên cứu

Xây dựng mô hình lý thuyết robot 2 bánh tự cân bằng và mô phỏng mô hình trên Matlab Simulink.

Xây dựng mô hình thực:

− Thiết kế cơ khí: khung sườn của mô hình.
− Ứng dụng các mạch điện tử, mạch công suất, cảm biến, vi xử lý. − Mạch cảm biến và bù trừ giá trị cảm biến.
Đồ án tốt nghiệp | Trang 19

## Chương 2. Các cơ sở lý thuyết

### 2.1 Đặc tính động lực học

### 2.1.1 Mô hình hóa robot 2 bánh tự cân bằng trên địa hình phẳng

Xây dựng hệ phương trình trạng thái mô tả hệ thống robot hai bánh tự cân bằng.

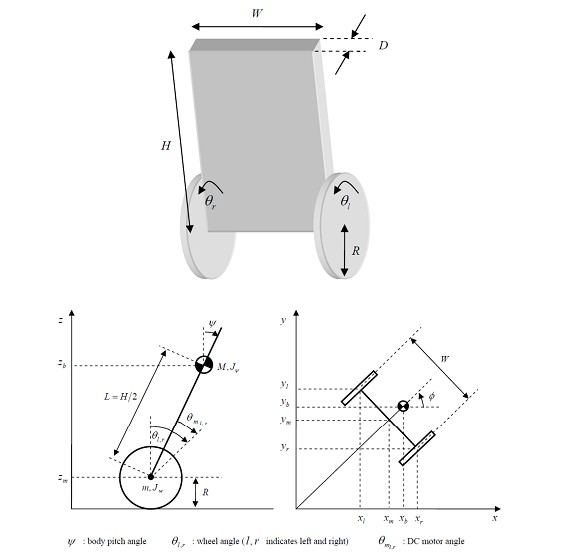
[picture p56: figure]

Hình 2.1: | Mô hình robot 2 bánh tự cân bằng trên mặt phẳng
Đồ án tốt nghiệp | Trang 20

Trong đề tài này sẽ sử dụng các kí hiệu, đơn vị như sau:

Kí hiệu | Đơn vị | Ý nghĩa
M | kg | Khối lượng của bánh xe
M | kg | Khối lượng của robot
R | m | Bán kính bánh xe
W | m | Chiều rộng của robot
D | m | Chiều ngang của robot
H | m | Chiều cao của robot
L | m | Khoảng cách từ trọng tâm robot đến trục bánh xe
f w | | Hệ số ma sát giữa bánh xe và mặt phẳng di chuyển
f m | | Hệ số ma sát giữa robot và động cơ DC
J m | kg.m² | Moment quán tính của động cơ DC
Rm | ohm | Điện trở động cơ DC
Kb | V sec/rad | Hệ số EMF của động cơ DC
Kt | Nm/A | Moment xoắn của động cơ DC
N Tỉ số giảm tốc

G m/s

| 2 | Gia tốc trọng trường
θ | rad | Góc trung bình của bánh trái và phải
θl , r | rad | Góc của bánh trái và phải
ψ | rad | Góc nghiêng của phần thân robot
ϕ | rad | Góc xoay của robot

xl

, yl

, zl | m | Tọa độ bánh trái

xr

, yr

, zr | m | Tọa độ bánh phải

xm

, ym

, zm | m | Tọa độ trung bình

Fθ

, Fψ

, Fϕ | Nm | Moment phát động theo các phương khác nhau
Fl , r | Nm | Moment phát động của động cơ bánh trái, phải

i
l

,

i
r | A | Dòng điện động cơ bánh trái, phải

vl

, vr | V | Điện áp động cơ bánh trái, phải
Bảng 2.1: | Ký hiệu và ý nghĩa của các đại lượng
Đồ án tốt nghiệp | | Trang 21

Sử dụng phương pháp Euler-Lagrange để xây dựng mô hình động học. Giả sử tại thời điểm t = 0, robot di chuyển theo chiều dương trục x, ta có các phương trình sau:
Góc tịnh tiến trung bình của hai bánh xe và góc xoay của robot được xác định như sau:
[
θ

ϕ]=

[
1
2

(θl+θr

)

R
W

(θl−θr

)]

[2.1]

Trong đó tọa độ trung bình của Robot trong hệ qui chiếu:
[
xm
ym
zm

]
=

[
∫x´ m
∫ y´ m
R ] | [2.2]

Và [
x´ m

´ym]

=[
R ´θ cosϕ
R´θ sinϕ] | [2.3]

Tọa độ bánh trái trong hệ qui chiếu :
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
sinϕ

ym+

W
2

cosϕ

zm

)

[2.4]

Tọa độ bánh phải trong hệ qui chiếu :
[
xr
yr

zr ]
=

(
xm+

W
2

sinϕ

ym−

W
2

cosϕ

zm

)

[2.5]

Tọa độ tâm đối xứng giữa hai động cơ trong hệ qui chiếu :
[
xb
yb
zb

]
=

[
xm+Lsinψcosϕ
ym Lsinψsinϕ
zm+Lcosψ ] | [2.6]

Phương trình động năng của chuyển động tịnh tiến:

Đồ án tốt nghiệp | Trang 22

T1=

1
2

m( x´ l
2
+ ´yl

2
+ ´zl

2

)+

1
2

m( x´ r
2
+ ´yr

2
+ ´zr

2

)+

1
2

m( ´xb

2
+ ´yb

2
+ ´zb

2
)
[2.7]

Phương trình động năng của chuyển động quay :

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
J ψ ψ´
2
+

1
2

J ϕ ϕ´
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
´θl−ψ´ )
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
´θr−ψ´ )
2
[2.8]

Với

1
2

n

2
J m

(

´θl−ψ´ )
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
´θr−ψ´ )
2
[2.9]

là động năng quay của phần ứng động cơ trái và phải. Phương trình thế năng:

U=mg zl+mg zr+mg zb
[2.10]

Phương trình Lagrange :

L=T1+T2−U
[2.11]

d

dt(
∂ L
∂

´θ )
−

∂ L
∂θ =Fθ
[2.12]

d

dt(
∂ L

∂ψ´ )⁻
∂ L
∂ ψ=Fψ
[2.13]

d

dt(
∂ L

∂ ϕ´ )
−

∂ L
∂ ϕ

=Fϕ
[2.14]

Lấy đạo hàm L theo các biến ta được:

[(2m+M ) R
2
+2J w+2n

2

Jm]
´θ+( MLRcosψ−2n
2

J m)ψ´ −MLRψ´
2
sinψ=Fθ

[2.15]

(MLRcosψ−2n
2

Jm)

´θ+( M L²
+Jψ +2 n

2

Jm)ψ´ −MgLsinψ−M L²

ϕ´
2
sinψcosψ=Fψ | [2.16]
Đồ án tốt nghiệp | Trang 23

[
1
2

m W²
+J ϕ+

W

2

2R

2

( J w+n
2

Jm)+M L²
sin²

ψ]
ϕ´
2

+2 M L²

ψ´ ϕ´ sinψcosψ=Fϕ | [2.17]

Momen động lực do động cơ DC sinh ra:
[
Fθ
Fψ

Fϕ ]
=

[
Fl+Fr
Fψ
W
2 R

(Fl−Fr

)]

[2.18]

Và:

Fl=n Kt
i

l+f m (ψ´ −´θl)−f w

´θl | [2.19]

Fr=n Kt
i

r+f m (ψ´ −´θr)−f w

´θr | [2.20]

Fψ=−n Kt
i

l−n Kt
i

r−f m(ψ´ −´θl)−f m(ψ´ −´θr) [2.21]

Sử dụng phương pháp PWM để điều khiển động cơ nên chuyển từ dòng điện sang điện áp động cơ:

Lm

´´
i

l , r=vl ,r+Kb (ψ´ −´θl , r)−Rm
i
l , r | [2.22]

Xem điện cảm phần ứng tương đối nhỏ (gần bằng 0), có thể bỏ qua, suy ra:

i

l ,r=

vl ,r+Kb(ψ´ −´θl , r)

Rm

| [2.23]

Từ đó, các moment lực sinh ra:

Fθ=α ( vl+vr)−2( β+f w)

´θ+2 βψ´ | [2.24]

Fψ=−α ( vl+vr )+2β

´θ−2β ψ´
[2.25]

Với α=

nKt
Rm

và β=

n Kt Kb
Rm
+f m | [2.26]

Fϕ=

W
2R

α ( vr−vl)−

W

2

2R

2

(β+f w

)ϕ´
[2.27]
Đồ án tốt nghiệp | Trang 24

Thu được phương trình động lực học mô tả chuyển động của robot như sau:\

[(2m+M ) R
2
+2J w+2n

2

Jm]
´θ+( MLRcosψ−2n
2

J m)ψ´ −MLRψ´
2

sinψ=α ( vl+vr )−2 ( β+f w)

´θ+2β ψ´

[2.28]

(MLRcosψ−2n
2

Jm)

´θ+( M L²
+Jψ +2 n

2

Jm)ψ´ −MgLsinψ−M L²

ϕ´
2

sinψcosψ=−α ( vl+vr)+2β

´θ−2 βψ´

[2.29]
[
1
2

m W²
+J ϕ+

W

2

2R

2

( J w+n
2

Jm)+M L²
sin²

ψ]
ϕ´
2

+2 M L²

ψ´ ϕ´ sinψcosψ=

W
2 R

α ( vr−vl)−

W

2

2 R

2 ( β+f w) ϕ´

[2.30]

### 2.1.2 Mô hình hóa robot hai bánh tự cân bằng trên địa hình phẳng trong

Matlab Simulink

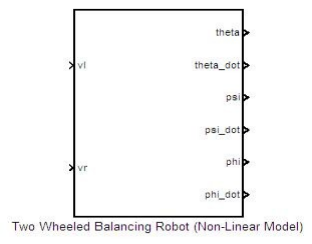
[picture p57: figure]

Hình 2.2 : | Mô hình phi tuyến của robot hai bánh tự cân bằng trong Matlab Simulink
Đồ án tốt nghiệp | Trang 25

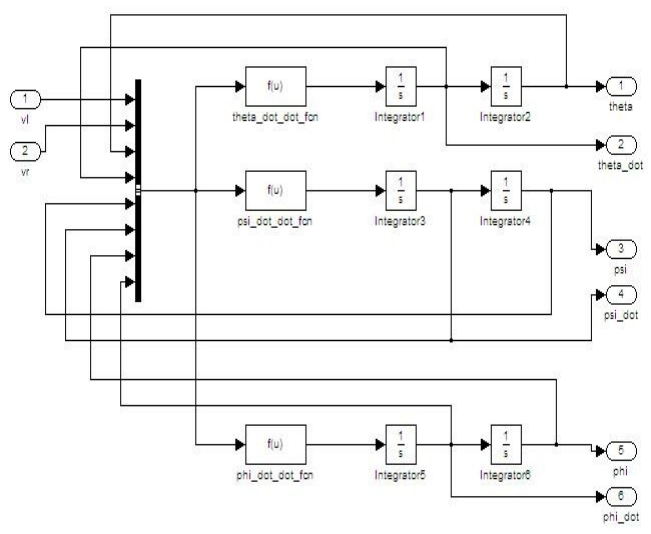
[picture p58: figure]

Hình 2.3: Bên trong khối “Two Wheeled Balancing Robot (Non-Linear Model)”

Phương trình động lực học của robot như trên thể hiện mối quan hệ giữa giá trị điện áp điều khiển hai động cơ;với độ nghiêng, vị trí, vận tốc của hệ robot, giá trị điện

áp hai động cơ vl

, vr

tác động lên các thông số đó dưới dạng tổng vl+vr còn với

góc xoay, giá trị điện áp hai động cơ vl

, vr
tác động lên thông số này dưới dạng hiệu

vr−vl
. Khi đó, tách bài toàn hệ robot thành hai bài toán nhỏ hơn với hai tín hiệu

điều khiển V ψ

, Vϕ

Đồ án tốt nghiệp | Trang 26

{
V ψ=vl+vr
V ϕ=vr−vl

❑

⇒{
vl=

1
2

(V ψ−Vϕ

)

vr=

1
2

(V ψ+V ϕ

)

[2.31]

Khối thực hiện chức năng này gọi là khối phân tách (decoupling)

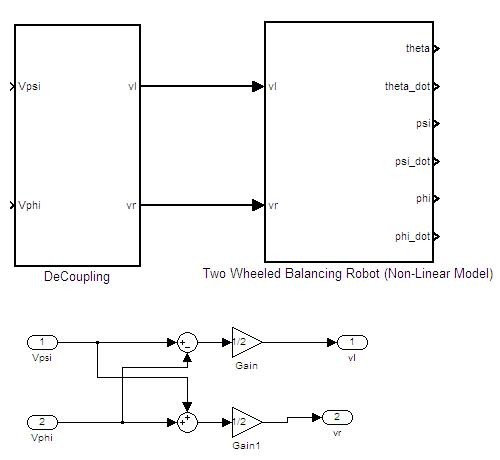
[picture p59: figure]

Hình 2.4: Bên trong khối “DeCoupling”

### 2.2 Bộ lọc Kalman

### 2.2.1 Giới thiệu về bộ lọc Kalman

Vào năm 1960, R.E.Kalman cho xuất bản nghiên cứu của mình, đưa ra giải pháp đệ qui để rời rạc hóa dữ liệu trong bộ lọc tuyến tính. Kể từ đó, việc giải quyết các bài toán kĩ thuật số, một lĩnh vực rất rộng lớn, đã trở nên dễ dàng hơn rất nhiều. Bộ lọc Kalman được mở rộng ra nghiên cứu và ứng dụng, đặc biệt là trong lĩnh vực tự động hay hỗ trợ việc tự định vị.
Bộ lọc Kalman thu thập và kết hợp linh động các tín hiệu từ các cảm biến thành phần. Mỗi khi mẫu thống kê nhiễu trên các cảm biến được xác nhận, bộ lọc Kalman sẽ cho ước lượng giá trị tối ưu (do đã loại được nhiễu), và có độ phân bổ ổn định. Trong đề tài này tín hiệu đưa vào bộ lọc được lấy từ hai cảm biến:cảmbiến gia
Đồ án tốt nghiệp | Trang 27

tốc(accelerometers) sẽ cho ra giá trị góc đo và cảm biến vận tốc góc (rate gyro), và tín hiệu ngõ ra của bộ lọc là tín hiệu đã được xử lí lẫn nhau trong bộ lọc; dựa vào mối quan hệ: vận tốc góc = đạo hàm của góc.
Bộ lọc Kalman là thuật toán xử lí dữ liệu hồi quy tối ưu. Nó tối ưu đối với chi tiết cụ thể trong bất kì tiêu chuẩn có nghĩa nào. Bộ lọc Kalman tập hợp tất cả thông tin được cung cấp tới nó, xử lí các giá trị sẵn có, ước lượng các giá trị quan tâm, sử dụng các hiểu biết động học, thiết bị giá trị và hệ thống, để mô tả số liệu thống kê của hệ thống nhiễu và những thông tin bất kì về điều kiện ban đầu của các giá trị cần ước lượng.
Đối với bộ lọc Kalman, thuật ngữ “lọc” không có ý nghĩa như các bộ lọc khác. Đây là một giải thuật tính toán và ước lượng thống kê tối ưu tất cả các thông tin ngõ vào được cung cấp tới nó để có được một giá trị ra đáng tin cậy nhất cho việc xử lý tiếp theo. Do vậy lọc Kalman có thể sử dụng để loại bỏ các tín hiệu nhiễu mà được mô hình là những tín hiệu nhiễu trắng trên tất cả dải thông mà nó nhận được từ ngõ vào, dựa trên các thống kê trước đó và chuẩn trực lại giá trị ước lượng bằng các giá trị đo hiện tại với độlệch pha gần như không tồn tại và có độ lợi tối thiểu xấp xỉ là 0 đối với những tín hiệu ngõ vào không đáng tin cậy. Mặc dù phải tốn khá nhiều thời gian xử lý lệnh, nhưng với tốc độ hiện tại của các vi điều khiển thời gian thực làm việc tính toán ước lượng tối ưu của bộ lọc này trở nên đơn giản và đáng tin cậy rất nhiều. Nhờ có cơ chế tự cập nhật các giá trị cơ sở (bias) tại mỗi thời điểm tính toán, cũng như xác định sai lệch của kết quả đo trước với kết quả đo sau nên giá trị đo luôn được ổn định, chính xác, gần như không bịsai số về độ lợi và độ lệch pha của các tín hiệu. Hơn thế, được xây dựng bởi hàm trạng thái, do vậy bộ lọc Kalman có thể kết hợp không chỉ hai tín hiệu từ hai cảm biến, mà có thể kết hợp được nhiều cảm biến đo ở những dải tần khác nhau của cùng một giá trị đại lượng vật lý. Chính vì điều này, làm bộ lọc Kalman trở nên phổ dụng hơn tất cả những bộlọc khác trong viêc xử lý tín hiệu chính xác của các cảm biến tọa độ, như cảm biến la bàn, GPS, góc, gyro…

### 2.2.2 Quá trình ước lượng:

Vấn đề chung của bộ lọc Kalman nhằm ước lượng biến trạng thái x∈R

n
của

quá trình điều khiển rời rạc được điều chỉnh bởi các phương trình tuyến tính ngẫu nhiên khác nhau. Phương trình không gian trạng thái của bộ lọc:

Đồ án tốt nghiệp | Trang 28

xk=A xk−1+B uk−1+wk−1
[2.32]

Với giá trị z∈R

m
là:

zk=H xk+vk
[2.33]

Biến ngẫu nhiên wk

, vk
đặc trưng cho nhiễu quá trình và nhiễu đo của hệ. Chúng

độc lập với nhau, tần suất phân bố thông thường:

p (w) N(0,Q)
[2.34]

p ( v ) N(0,R)
[2.35]

Trên thực tế, ma trận tương quan nhiễu quá trình Q và ma trận tương quan nhiễu đo R có thể thay đổi sau mỗi bước thời gian hay giá trị, tuy nhiên để đơn giản, trong hầu hết các trường hợp Q và R được xem là hằng số.
Ma trận vuông A trong phương trình [2.32] thể hiện mối quan hệ của các biến trạng thái ở thời điểm k-1 với thời điểm hiện tại k. Thực ra trên thực tế ma trận A thay đổi sau mỗi bước thời gian, nhưng ở đây ma trận A xem như hằng số. Ma trận B thể

hiện mối liên hệ tín hiệu điều khiển u∈R

L
đối với biến trạng thái x. Ma trận H trong

phương trình [2.33] thể hiện mới liên hệ giữa biến trạng thái với tín hiệu ra z, H cũng được xem là hằng số.
Những tính toán căn bản của bộ lọc:
Định nghĩa:
−¿=E{xk∨ y1
, y2… y k−1

}
x^
k

¿

là giá trị ước lượng của xk trước khi ta xử lý giá trị đo

tại thời điểm k.
+¿=E{xk∨y1
, y2… yk

}
x^
k

¿

là giá trị ước lượng của xk sau khi ta xử lý giá trị đo tại

thời điểm k.

x^
k∈R

n
là giá trị ước lượng trạng thái sau tại bước k có được sau khi so sánh với giá

trị đo zk
.Và chúng ta có sai số ước lượng trạng thái trước và sau:
Đồ án tốt nghiệp | Trang 29

−¿
¿
ek

−¿≡ xk−x^ k

¿
ek≡ xk−x^ k
¿

[2.36]

Tương quan sai số ước lượng trước “priori”:

−¿ ek

−T
}
−¿=E{ek

¿

Pk

¿

[2.37]

Tương quan sai số ước lượng sau “posteriori”:

Pk=E{ek ek

T
}
[2.38]

Khi lấy đạo hàm phương trình bộ lọc Kalman, với mục đích tìm một phương

trình để tính toán trạng thái ước lượng posteriori x^
k

thể hiện sự tương quan giữa giá

trị ước lượng priori

−¿
x^
k

¿

và độ sai lệch giữa giá trị đo thực zk và giá trị đo ước lượng

−¿
H x^
k

¿
:

z
¿
¿ k−H x^
¿
−¿+K ¿
x^
k

¿ x^
k

¿
¿
¿

[2.39]

Ma trận K trong [3.8] là ma trận độ lợi hay hệ số trộn để tối thiểu hóa phương trình tương quan sai số posteriori. Biểu thức tính K để tối thiểu hóa phương trình [3.8] như sau:

−¿ H

T
+ R
H Pk

¿
¿
H Pk

−¿ H

T
+R

Pk

−¿H

T
¿
¿
−¿ H

T
¿
Kk=Pk

¿

[2.40]

Đồ án tốt nghiệp | Trang 30

Từ đó thấy rằng tương quan sai số giá trị đo lường R tiến tới 0, khi đó:

lim

Rk→0

Kk=H

−1
[2.41]

Mặt khác, tương quan sai số ước lượng priori của

−¿
Pk

¿
tiến đến 0, khi đó:

Pk

−¿→0Kk=0

lim
¿
¿ | [3.42]

Một cách nghĩ khác về giá trị hiệu chỉnh bù bởi K là nếu ma trận tương quan sai

số giá trị đo lường R tiến tới 0 thì giá trị đo được

zk
| sẽ có độ tin cậy càng cao, trong

khi giá trị ước lượng

−¿
H xk

¿
| sẽ có độ tin cậy càng thấp. Mặt khác, nếu tương quan sai

số ước lượng priori

−¿
Pk

¿

tiến tối 0 thì zk
sẽ không đáng tin mà giá trị ước lượng

−¿
H xk

¿
sẽ càng đáng tin.

### 2.2.3 Bản chất xác suất của bộ lọc

Sự điều chỉnh cho xk
trong [3.8] đã xác định bản chất ước lượng priori

−¿
x^
k

¿

với điều kiện tất cả các giá trị đo zk
đều có nghĩa (Luật phân bố Bayer). Điều đó

cho thấy bộ lọc Kalman duy trì hai thời điểm đầu tiên của sự phân bố trạng thái:

E[ xk ]=x^
k

[2.43]

E[( xk−x^
k ) ( xk−x^

k )

T

]=Pk | [2.44]

Phương trình ước lượng trạng thái posteriori phản ánh giá trị trung bình của phân
bố trạng thái. Tương quan sai số ước lượng trạng thái posteriori phản ánh sự thay đổi của phân bố trạng thái. Ngoài ra ta còn có:

p( xk|zk ) N (E[ xk ] , E[ ( xk−x^
k ) ( xk−x^

k )

T

])=N(x^

k

, Pk

)
| [2.45]
Đồ án tốt nghiệp | Trang 31

### 2.2.4 Thuật toán Kalman rời rạc

Bộ lọc Kalman ước lượng tiến trình bằng cách sử dụng dạng điều khiển hồi tiếp: bộ lọc ước lượng các trạng thái của quá trình tại một vài thời điểm và sau đó chứa tín hiệu hồi tiếp trong các dạng của giá trị đolường. Do đó, phương trình bộ lọc Kalman chia làm hai nhóm: phương trình cập nhật thời gian và phương trình

cập nhật giá trị đo lường. Phương trình cập nhật thời gian chịu trách nhiệm cho việc dự báo trước (về mặt thời gian) của trạng thái hiện tại và ước lượng sai số tương quan để chứa vào bộ ước lượng trước priori cho bước thời gian tiếp theo. Phương trình cập nhật giá trị đo lường chịu trách nhiệm cập nhật cho tín hiệu hồi tiếp, nghĩa là cập nhật giá trị mới vào giá trị ước lượng tước priori để tạo tín hiệu ước lượng sau posteriori tốt hơn.
Phương trình cập nhật thời gian cũng có thể được coi là phương trình

dự đoán. Trong khi đó phương trình cập nhật giá trị đo lường thì được xem như là phương trình hiệu chỉnh.Vì vậy, thuật toán ước lượng cuốicùng đều giống nhau ở thuật toán dự đoán và hiệu chỉnh để giải quyết vấn đề số học như hình vẽ dưới đây:

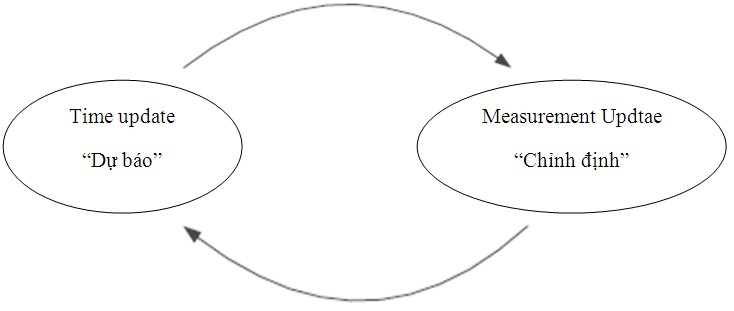
[picture p60: figure]

Hình 2.5: Quy trình thực hiện của bộ lọc Kalman Phương trình cập nhật thời gian cho bộ lọc Kalman rời rạc: −¿+B uk−1
−¿=A x^
k−1

¿
x^
k

¿

[2.46]

−¿=A Pk−1 A

T
+Q
Pk

¿

[2.47]

Đồ án tốt nghiệp | Trang 32

Phương trình cập nhật giá trị đo lường cho bộ lọc Kalman rời rạc:

−¿ H

T
+ R
HPk

¿
¿
¿
−¿ H

T
¿
Kk=Pk

¿

[2.48]

−¿
zk−H x^
k

¿
−¿ K ¿
x^

k=x^
k

¿

[2.49]

−¿
Pk=(1−Kk H )Pk

¿
[2.50]

Nhiệm vụ đầu tiên trong suốt quá trình cập nhật giá trị đo lường là tính toán độ

lợi Kalman Kk

Bước tiếp theo là xử lí giá trị đo thực được chứa trong zk . Sau

đó, tính trạng thái ước lượng sau posteriori bằng cách kết hợp giá trị đo được theo

công thức x^
k ở trên. Bước cuối cùng là tính giá trị sai số ước lượng tương quan

posteriori vào Pk

Sau mỗi chu trình tính toán của bộ lọc Kalman, các giá trị được cập nhật theo cặp, tiến trình được lặp lại với ước lượng posteri ori của trạng thái trước dùng để dự đoán ước lượng priori mới. Trạng thái đệ quy tự nhiên là một trong những điểm đặc trưng của bộ lọc Kalman, nó thay thế điều kiện đệ quy ước lượng hiện tại cho giá trị đã qua.
Trong điều kiện thực hiện thực tế của bộ lọc, giá trị nhiễu tương quan R thường được dùng làm giá trị ưu tiên để tính toán cho bộ lọc. Trên thựctế, việc đo các giá trị ma trận R là rất phổ biến bởi vì chúng ta có thể đo quy trình theo nhiều cách vì vậy mà thường lấy mẫu giá trị để đưa ra khuynh hướng thay đổi của giá trị nhiễu.
Sự xác định rõ tương quan nhiễu quá trình Q thường rất khó bởi vì điều điển hình là chúng ta không có khả năng quan sát trực tiếp tiến trình mà chúng ta đang ước lượng. Đôi khi sự liên hệ tới những quy trình mẫu đơn giản có thể đưa ra những giá trị chấp nhận được nếu một mẫu xen vào không chắc chắn đủ với tiến trình thông qua sự lựa chọn Q . Chắc chắn trong trường hợp này,mẫu đó sẽ hi vọng rằng giá trị tiến trình là đáng tincậy.
Đồ án tốt nghiệp | Trang 33

Trong những trườnghợp khác, dù muốn hay không chúng ta đều có cái chuẩnhợp lí cho việclựa các thôngsố, thường thìchấtlượngbộlọcsẽtốt hơn nhiều lần khi có chứasự hiệu chỉnh các thamsố Q và R.Sự hiệu chỉnh thường được thực hiệngián tiếp, thường thìvớisự giúp đỡcủamộtbộ lọc Kalman khác trong quy trình chung, liênhệ nhưmộthệ thống đồng nhất.
Với điều kiện Q và R là cáchằngsố thực,cả hai cho phép ước lượng saisố tương

quan

Pk và độlợi Kalman Kk
sẽ ổn định nhanh chóng và sau đó trở thànhhằngsố.

Trong điều kiện luận văn, thông số Q và R được hiệu chỉnh dựa vào quá trình thử sai để dựđoán khuynh hướng hiệu chỉnh của hệ thống và tìm ra bộ thông số phù hợp nhất.

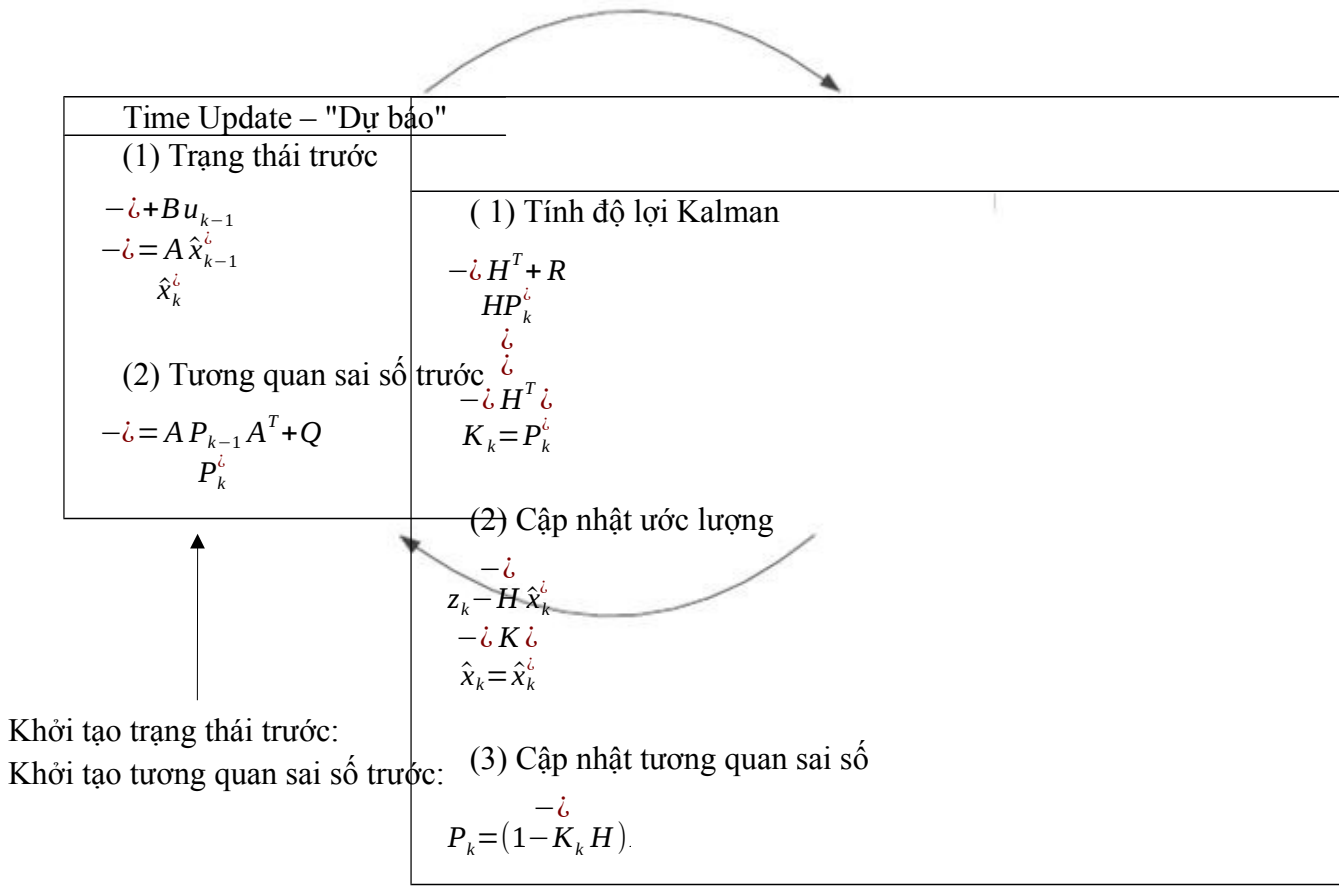
[picture p61: figure]
Khởi tạo trạng thái trước: Khởi tạo tương quan sai số trước:; Time Update – "Dự báo" (1) Trạng thái trước; (2) Tương quan sai số trước; ( 1) Tính độ lợi Kalman; + R HPk; (2) Cập nhật ước lượng; (3) Cập nhật tương quan sai số

Hình 2.6: | Tổng quan chu trình thực hiện bộ lọc Kalman hoàn chỉnh
Đồ án tốt nghiệp | Trang 34

### 2.3 Giải thuật điều khiển

### 2.3.1 Cấu trúcbộ điều khiển PID cho robot hai bánh tự cân bằng

Ba bộ PID được sử dụng để điều khiển robot hai bánh tự cân bằng, bao gồm: -Bộ PID điều khiển góc nghiêng (ψ)

-Bộ PID điều khiển vị trí (θ)

-Bộ PID điều khiển góc xoay (ϕ)

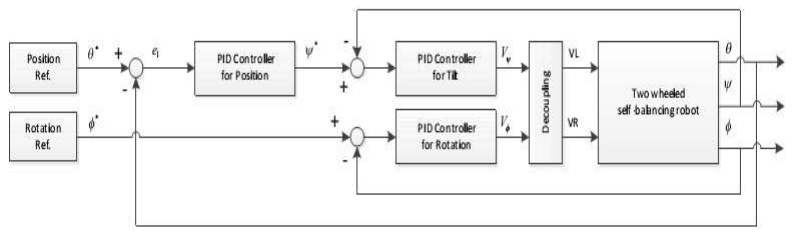
[picture p62: figure]

Hình 2.7: Cấu trúc bộ điều khiển PID cho hệ robot hai bánh tự cân bằng

Hàm truyền đạt bộ điều khiển PID liên tục:

GPID (s)=

U (s)
E(s)

=KP+

KI
s

+KD (
s
1+τS ) | [2.51]

Rời rạc hóa đạo hàm theo thời gian:

y (k )≈

f (k )−f (k−1)
Ts

[2.52]

Rời rạc hóa tích phân theo thời gian:

∫

0

k .T s
y (t )dt=y (k )≈ y (k−1 )+

f ( k )−f (k−1)

2

.Ts | [2.53]

Phép biến đổi rời rạc (z-Transform)

X [ z]=Z { x [ k ]}=∑ k=0

∞
x [k ]z
−k | [2.54]
Đồ án tốt nghiệp | Trang 35

z=A e jθ=A(cosθ+ jsinθ)
[2.55]

Ta có Z { x [k−n ]}=z
−n
X [ z]

và Z { x [k ]}=X [ z]
[2.56]

Do đó

y (k )=

f (k )−f (k−1)
Ts

Z

→

Y [ z]=

F [z]−z

−1
F [z]
Ts

❑⇒

Y [z]
F[z]

=

z−1
z T s

[2.57]

Và

1−z
(¿¿−1)=Ts
2

F[z](1+z

−1
)

y (k )=y (k−1)+

f (k )−f (k−1)

2

.Ts Z

→

Y [z]¿

❑⇒

Y [z]
F[z]

=

Ts

2

z+1
z−1 | [2.58]

U [z]
E[z]

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
z Ts

[2.59]

❑

⇔ U [z]
E[z]

=

Kp

(z

2−z)+Ki

Ts

2

(z

2

+z)+ Kd
T s

(z

2−2 z+1)

z

2−z

❑

⇔ U [z]
E[z]

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
+(−K p
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
⇔ U [z]
E[z]

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
+(−Kp
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
Đồ án tốt nghiệp | Trang 36

❑

⇔
U [ z]=z

−1U [z] +aE[ z]+b z⁻¹
E[z] +c z

−2
E[z] | [2.60]

❑

⇔
u[ k ]=u [ k−1]+ae [ k ]+be [k−1] +ce [ k−2] | [2.61]

Trong đó: a=Kp

+Ki

Ts

2

+

Kd
Ts

; b=−K p

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
[2.62]

### 2.3.2 Bộ điều khiển PID với thông số cố định

Bộ điều khiển PID với thông số KP, KI, KD cố định như trên, hệ thống chỉ làm việc tốt trong điều kiện hệ số KP, KI, KD đã được chỉnh định tối ưu và trong quá trình làm việc, các thông số trong mô hình không đổi.

Cấu trúc bộ điều khiển PID rời rạc với hệ số cố định sử dụng để điều khiển góc nghiêng, vị trí và góc xoay là như nhau và được hiện thực như sau trong Matlab Simulink.

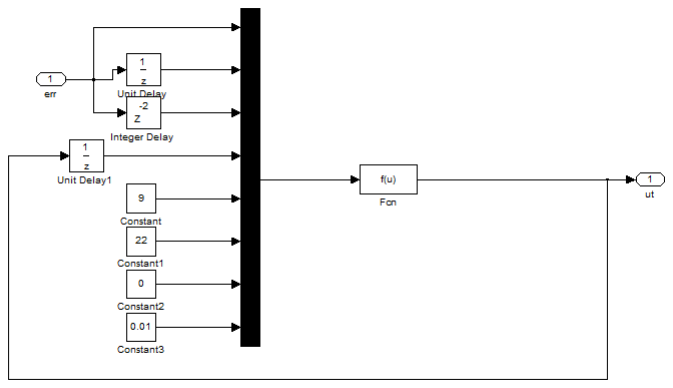
[picture p63: figure]

Hình 2.8: Cấu trúc bên trong bộ điều khiển PID rời rạcvới thông số cố định.

Hệ thống điều khiển robot hai bánh tự cân bằng sử dụng bộ PID rời rạc với thông số cố định hiện thực như sau:

Đồ án tốt nghiệp | Trang 37

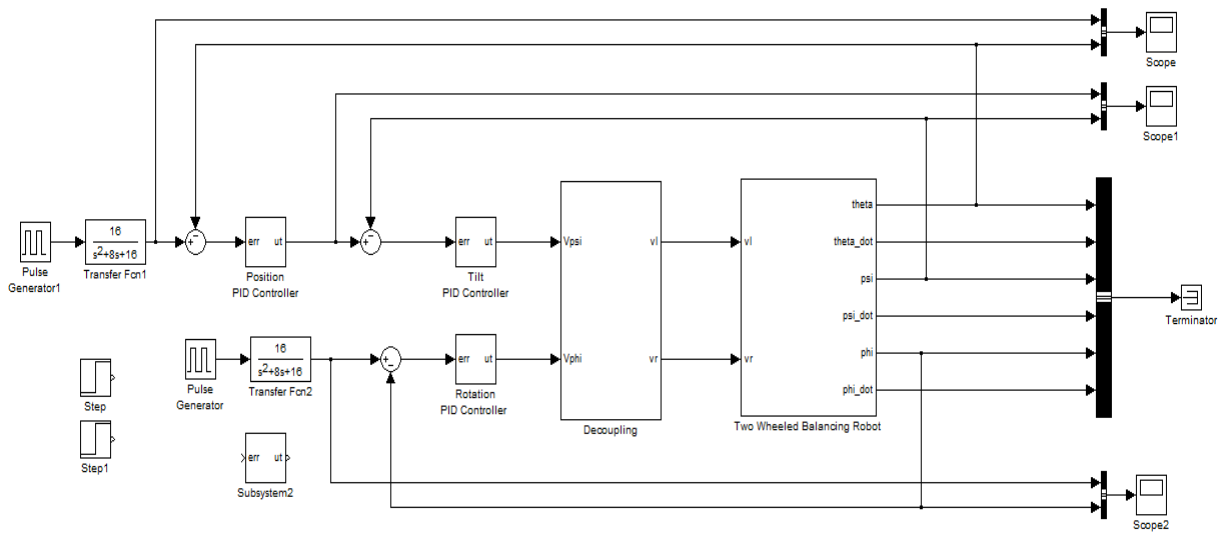
[picture p64: figure]

Hình 2.9: Robot hai bánh tự cân bằng sử dụng 3 bộ điều khiển PID cố định.

Trong đó, mô hình Robot 2 bánh tự cân bằng trong trường hợp này sẽ được thay đổi các thông số như khối lượng thân Robot(M) và hệ số ma sát giữa bánh xe với bề mặt di chuyển(fw) thông qua file “Two_wheelRobot.m”

### 2.3.2.1 Trường hợp thông số mô hình được chọn cố định

Với M=8,2 kg, fw=0,001, thông số của các bộ điều khiển lần lượt là:

-Position PID controller [Kp=12 Ki=16 Kd=0]

-Tilt PID controller [Kp=120 Ki=110 Kd=90]

-Rotation PID Controller [Kp=334 Ki=229 Kd=432]

Bộ PID cố định sẽ điều khiển hệ thống hoạt động tốt ứng với các tín hiệu đầu vào là xung vuông hoặc sóng sine như sau:

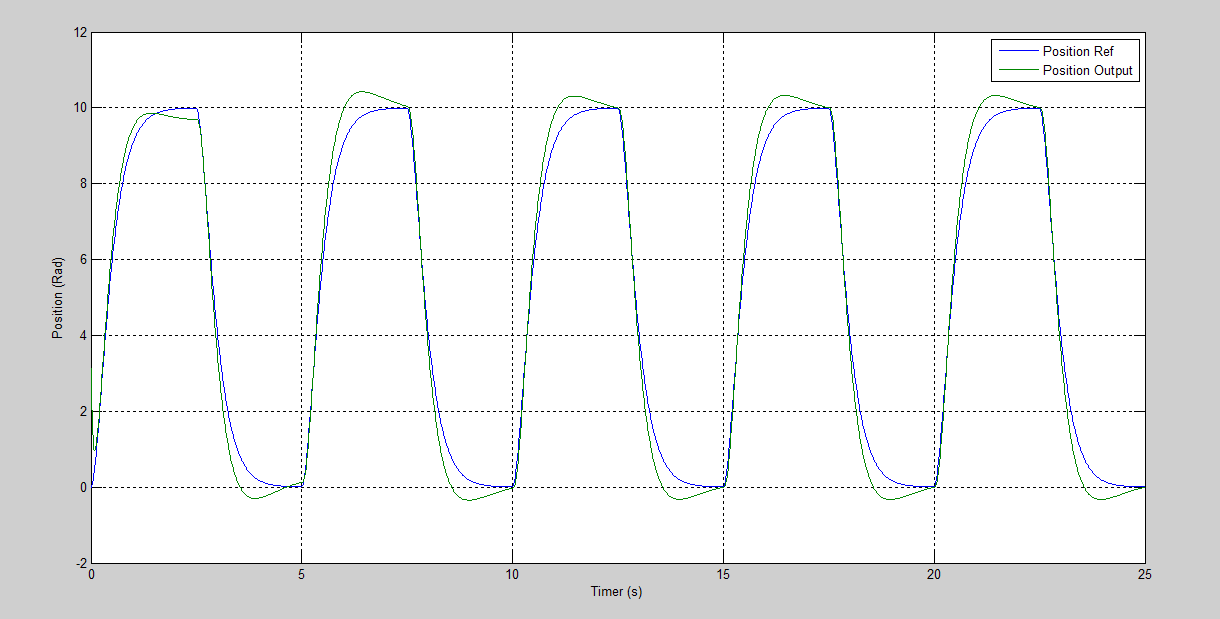
[picture p65: figure]

Đồ án tốt nghiệp | Trang 38

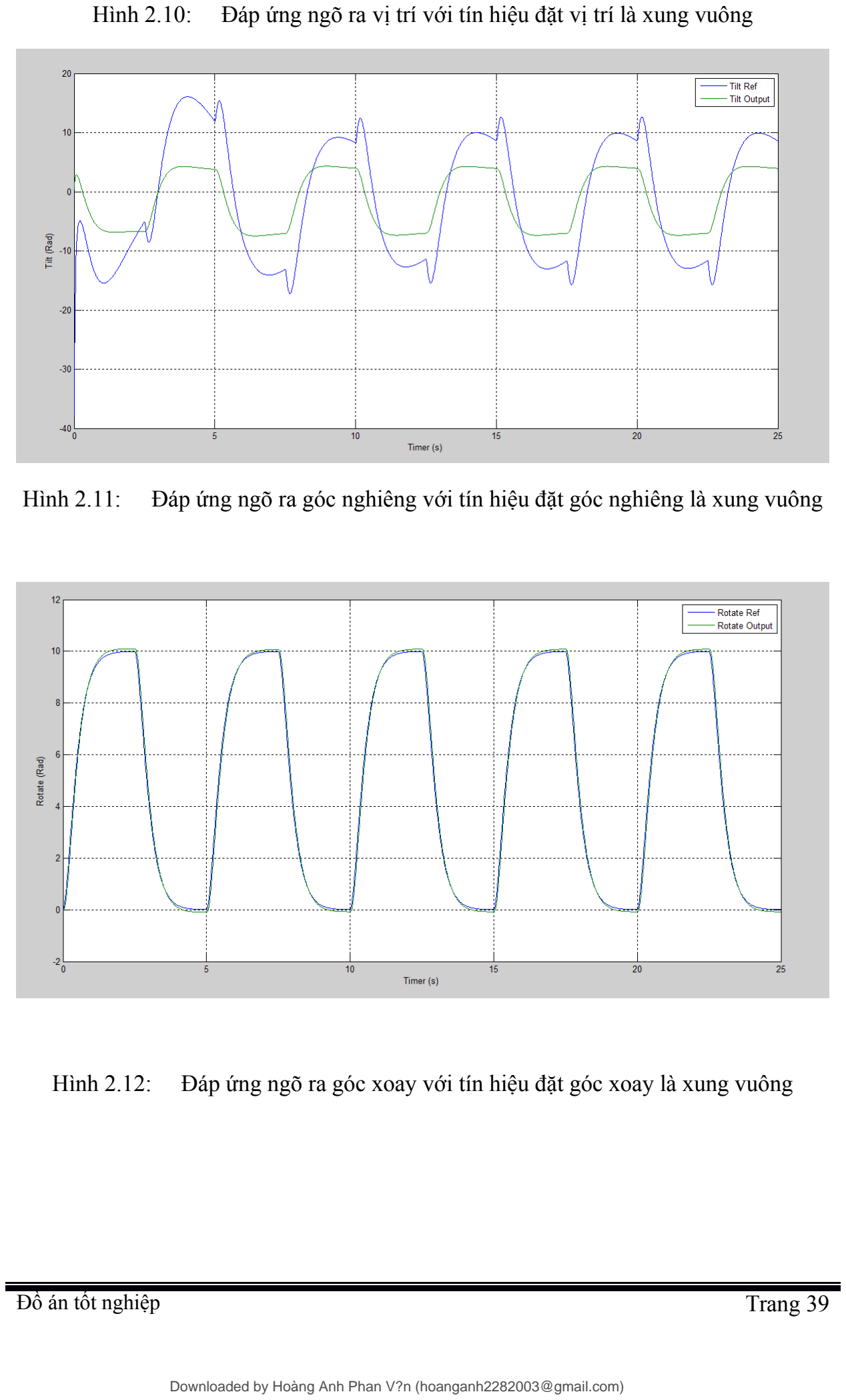
[picture p66: page 41]

Hình 2.10: Đáp ứng ngõ ra vị trí với tín hiệu đặt vị trí là xung vuông

Hình 2.11: Đáp ứng ngõ ra góc nghiêng với tín hiệu đặt góc nghiêng là xung vuông

Hình 2.12: Đáp ứng ngõ ra góc xoay với tín hiệu đặt góc xoay là xung vuông

Đồ án tốt nghiệp | Trang 39

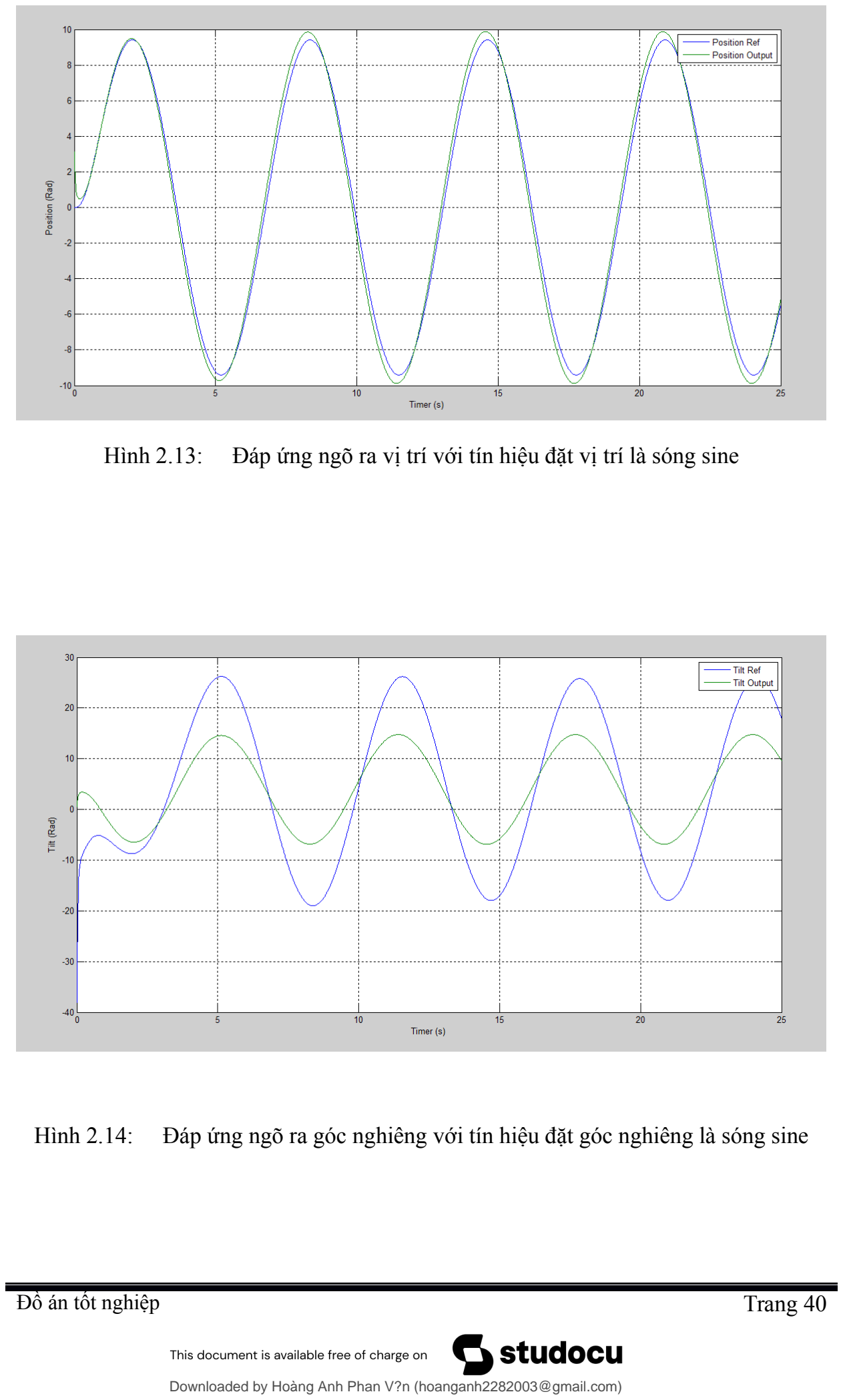
[picture p67: page 42]

Hình 2.13: Đáp ứng ngõ ra vị trí với tín hiệu đặt vị trí là sóng sine

Hình 2.14: Đáp ứng ngõ ra góc nghiêng với tín hiệu đặt góc nghiêng là sóng sine

Đồ án tốt nghiệp | Trang 40

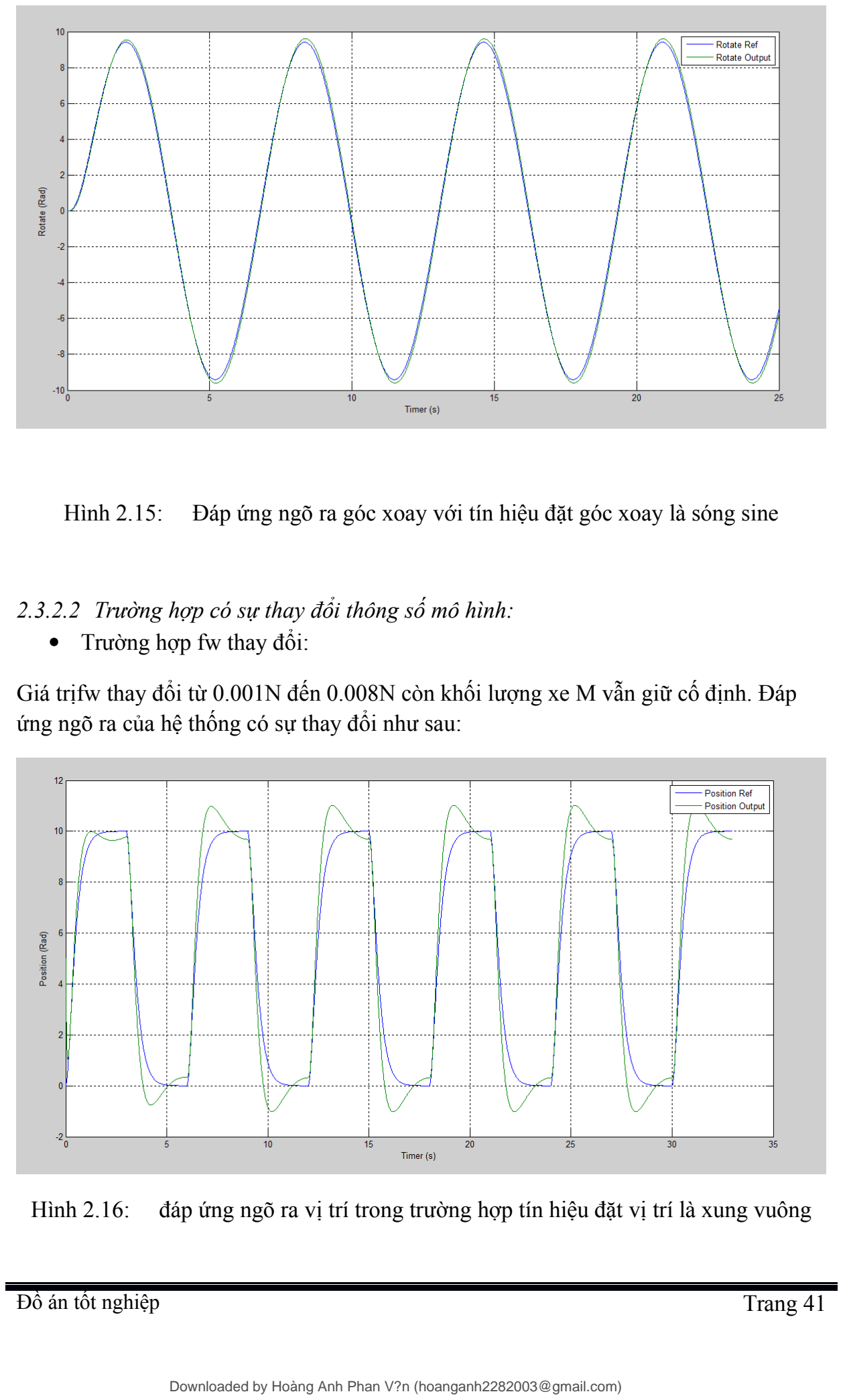
[picture p68: page 43]

Hình 2.15: Đáp ứng ngõ ra góc xoay với tín hiệu đặt góc xoay là sóng sine

### 2.3.2.2 Trường hợp có sự thay đổi thông số mô hình:

- Trường hợp fw thay đổi:

Giá trịfw thay đổi từ 0.001N đến 0.008N còn khối lượng xe M vẫn giữ cố định. Đáp ứng ngõ ra của hệ thống có sự thay đổi như sau:

Hình 2.16: đáp ứng ngõ ra vị trí trong trường hợp tín hiệu đặt vị trí là xung vuông

Đồ án tốt nghiệp | Trang 41

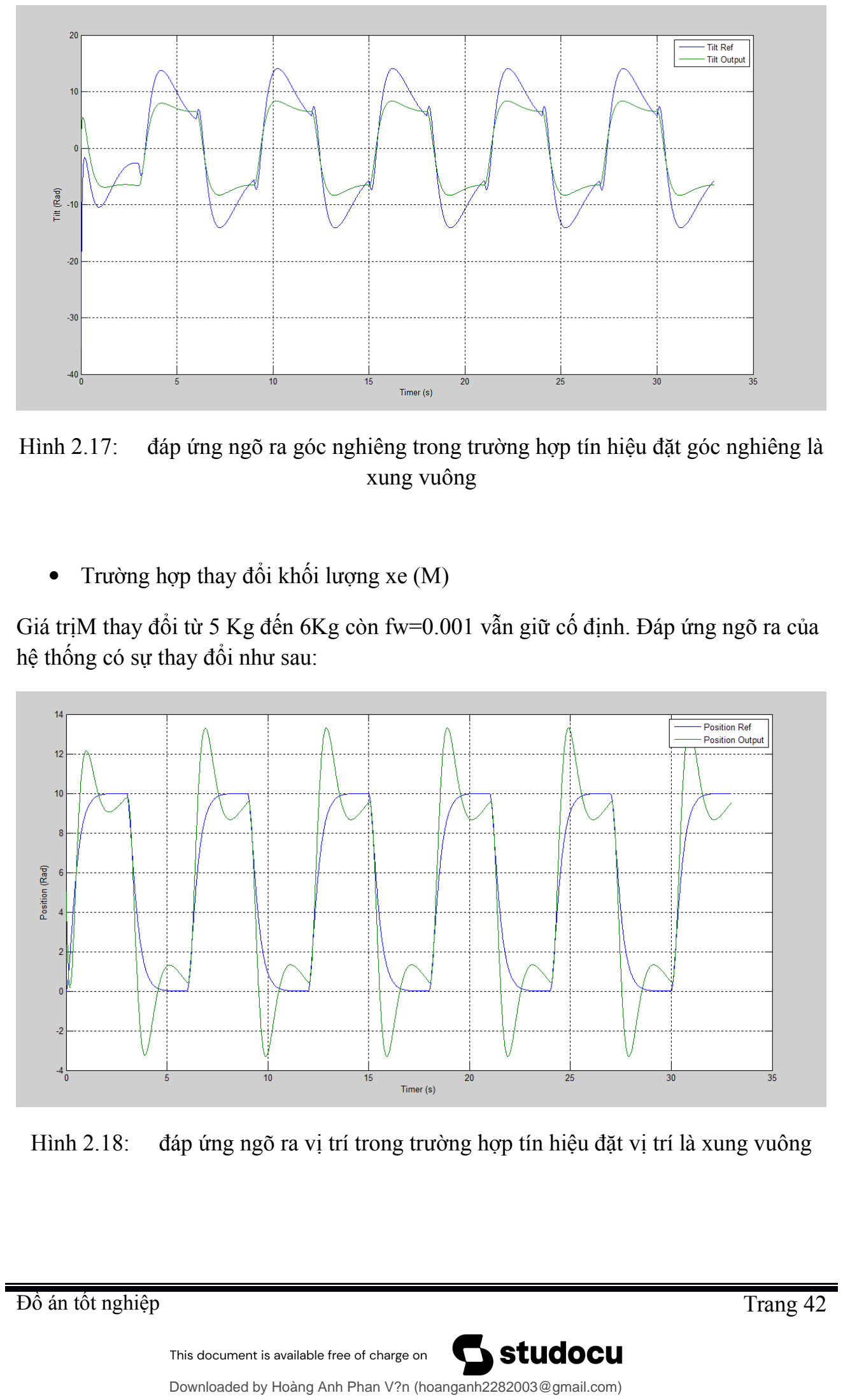
[picture p69: page 44]

Hình 2.17: đáp ứng ngõ ra góc nghiêng trong trường hợp tín hiệu đặt góc nghiêng là xung vuông

- Trường hợp thay đổi khối lượng xe (M)

Giá trịM thay đổi từ 5 Kg đến 6Kg còn fw=0.001 vẫn giữ cố định. Đáp ứng ngõ ra của hệ thống có sự thay đổi như sau:

Hình 2.18: đáp ứng ngõ ra vị trí trong trường hợp tín hiệu đặt vị trí là xung vuông

Đồ án tốt nghiệp | Trang 42

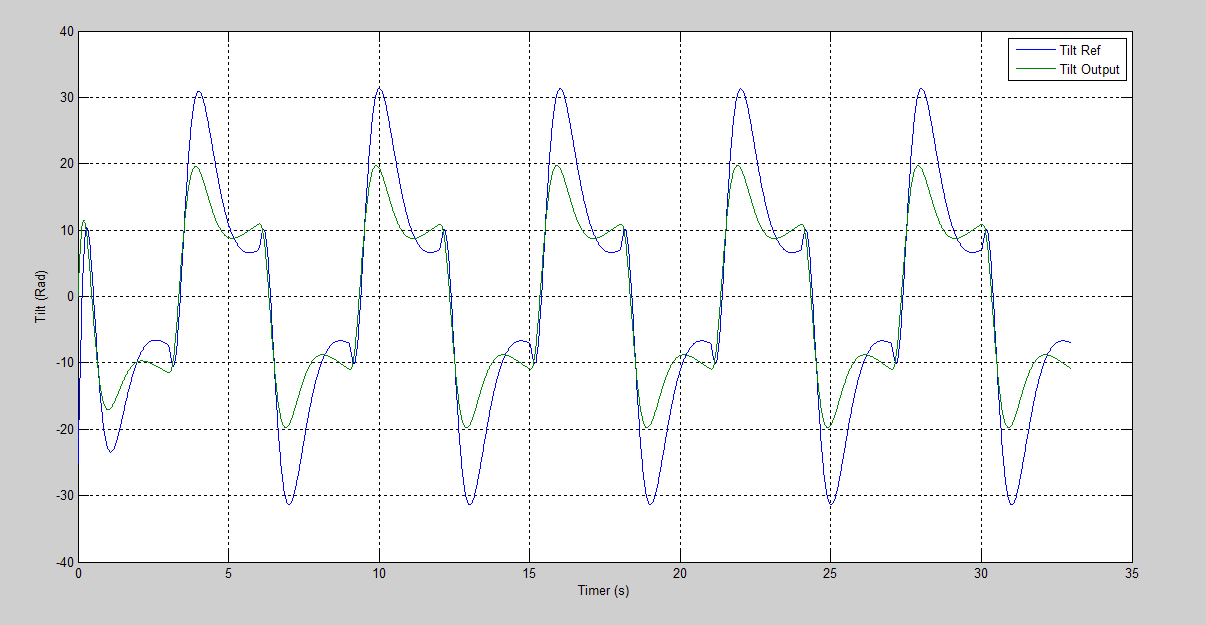
[picture p70: figure]

Hình 2.19: đáp ứng ngõ ra góc nghiêng trong trường hợp tín hiệu đặt góc nghiêng là xung vuông

### 2.3.2.3 Kết luận

Có thể thấy, đáp ứng ngõ ra vị trí của hệ thống bị ảnh hưởng một cách rõ rệt, ngõ ra vị trí của hệ thống không thể tiếptục đáp ứng theo tín hiệu đặt như ban đầu khi hệ số fw thay đổi. Còn các bộ PID điều khiển góc nghiêng thì vẫn đảm bảo ngõ ra hệ thống bám tốt theo tín hiệu đặt.

Đặc biệt khi có sự thay đổi về khối lượng Robot (M), ngõ ra vi trí của hệ thống bị vọt lố khá lớn. Tuy nhiên khả năng điểu khiển góc nghiêng của bộ PID vẫn duy trì và bám khá tốt với tín hiệu đặt.

Như vậy trong trường hợp có sự thay đổi hệ số ma sát fw và khối lượng Robot M trong mô hình thì bộ PID cố định điều khiển vị trí không thể đảm bảo được chất lượng điều khiển. Tuy nhiên khâu góc nghiêng và góc xoay đáp ứng khá tốt.

### 2.3.3 Các thành phần chính của mô hình:

### 2.3.3.1 Nguồn

Nguồn cung cấp cho robot sử dụng pin Lithium-polimer 11.1V/2200mA (x2)

Đồ án tốt nghiệp | Trang 43

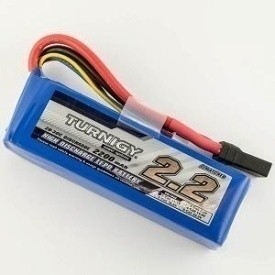
[picture p71: figure]

Hình 2.20: Pin Li-Po 11.1V/2200mA

### 2.3.3.2 Vi xử lý

Robot sử dụng DSP (Digital signal processing) TMS320F28335 của hãng Texas Instrument dưới dạng KIT thí nghiệm Delfino C28335 làm trung tâm thu thập dữ liệu và điềukhiển mọi hoạt động của robot.

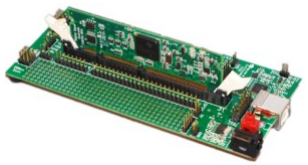
[picture p72: figure]

Hình 2.21: DSP TMS320F28335
− | Hoạt động ở tần số 150Mhz ( 6.67ns/chu kỳ máy).
− | Hỗ trợ hoạt động tính toán số thực single precision 32bit FPU.
− | 16 x 16 Dual MAC, 16 x 16 và 32 x 32 MAC.
− | Bus có kiến trúc Harvard.
− | Kênh điều khiển DMA cho: ADC, McBSP, ePWM, XINTF và SARAM.
− | Bộ nhớ: 256 x 16KB Fl ash, 34KB x 16 SARAM.
− | Boot ROM 8K x 16.
− | 18 kênh PWM trong đó có 6 kênh PWM có độ phân giải cao 150ps.
− | 8 Timer 32 bits.
− | Hỗ trợ các chuẩn giao tiếp: 2xCAN, 3xSCI(UART), 2xMcBSP, 1xSPI, 1xI2C.
− | 2 bộ giao tiếp ENCODER 32 bit.

### 2.3.3.3 Cảm biến IMU

Robot sử dụng cảm biến IMU (Inertial Measurement Unit-cảm biến đo lường quán tính) để tính toán, ước lượng giá trị góc nghiêng và vận tốc góc nghiêng

Đồ án tốt nghiệp | Trang 44

thânrobot, tên đầy đủ là Razor IMU 9 Degrees Of Freedom, là sự tích hợp của cảm biến gia tốc ADXL 345 (triple-axis accelerometer), cảm biến con quay hồi chuyển ITG3200 (MEMS triple-axis gyro) và cảm biến từ trường HMC5883L (triple-axis magnetometer) trên cùng 1 bo mạch.

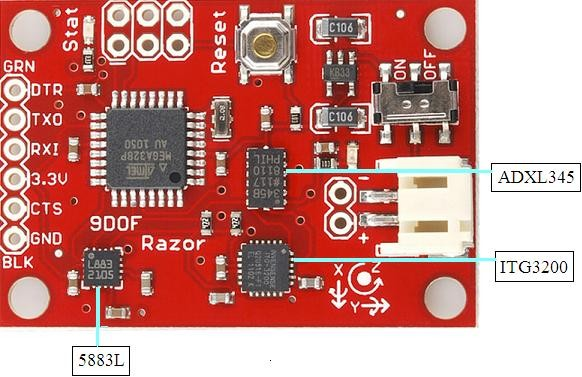
[picture p73: figure]

Hình 2.22: Razor IMU 9DOF
Cảm biến gia tốc ADXL 345 (triple-axis accelerometer)
ADXL345 là cảm biến gia tốc 3 trục công suất thấp của hãng Analog Devices

thích hợp cho các ứng dụng di động, độ phân giải cao (13bit), với tầm đo ±16 g và

có ngõ ra theo chuẩn truyền dữ liệu I2C hay SPI tùy chỉnh

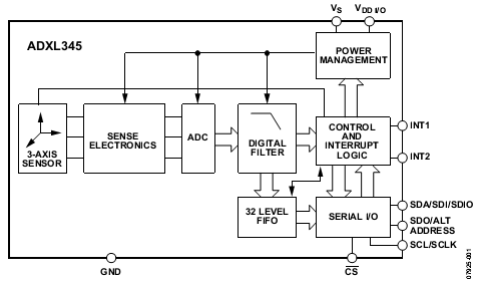
[picture p74: figure]

Đồ án tốt nghiệp | Trang 45

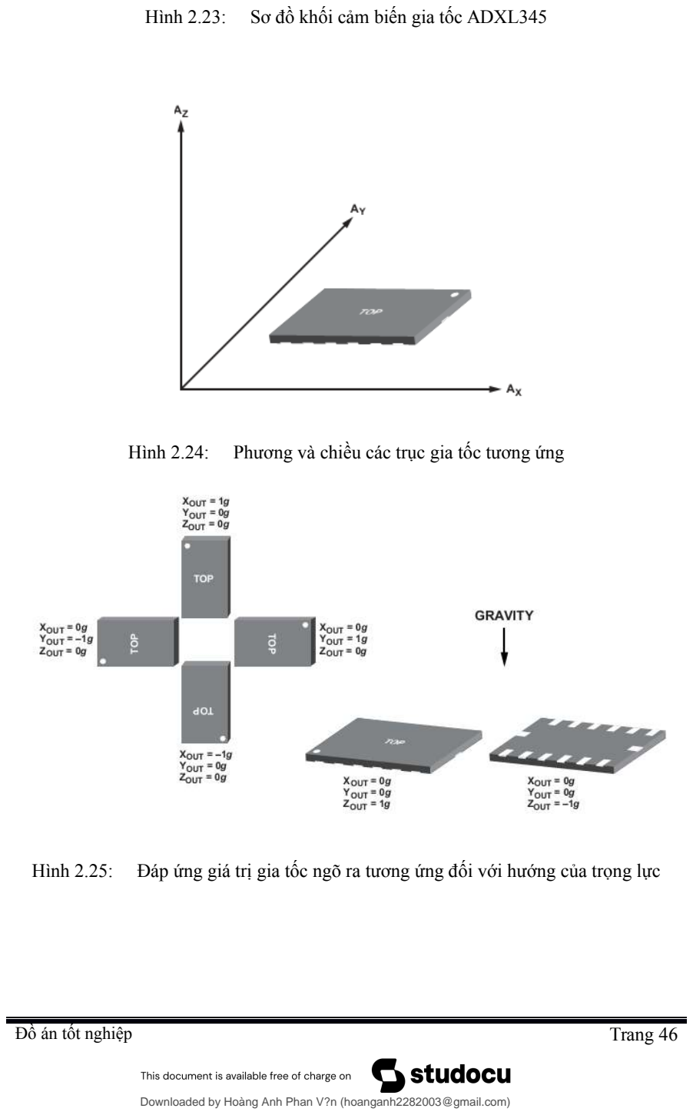
[picture p75: page 48]

Hình 2.23: Sơ đồ khối cảm biến gia tốc ADXL345

Hình 2.24: Phương và chiều các trục gia tốc tương ứng

Hình 2.25: Đáp ứng giá trị gia tốc ngõ ra tương ứng đối với hướng của trọng lực

Đồ án tốt nghiệp | Trang 46

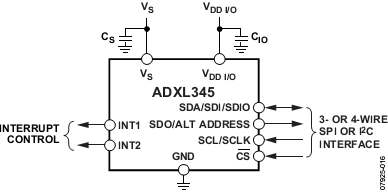
[picture p76: figure]

Hình 2.26: Sơ đồ chân ngõ ra trên cảm biến gia tốc Dựa vào cảm biến gia tốc ADXL345, có thể đo được gia tốc của robot theo 3 phương Ax, Ay , Az và dựa vào gia tốc có thể xác định được độ nghiêng theo công thức sau:

ψ=

Ax
Ay | [2.63]

Cảm biến con quay hồi chuyển ITG3200 (MEMS triple-axis gyro)
ITG3200 là cảm biến con quay hồi chuyển của hãng InvenSense tích hợp 3 bộ ADC 16bit để chuyển đỗi ngõ ra analog, tích hợp sẵn bộ khuếch đại và bộ lọc thông

thấp, có độ phân giải ±2000o
/s
. Cảm biến được tích hợp chuẩn truyền dữ liệu I2C.

Con quay hồi chuyển được sử dụng để đo vận tốc góc nghiêng của robot. Sự kết hợp 2 cảm biến: gia tốc và con quay hồi chuyển để đo 2 thông số: góc nghiêng tĩnh và vận tốc góc nghiêng của robot.

Đồ án tốt nghiệp | Trang 47

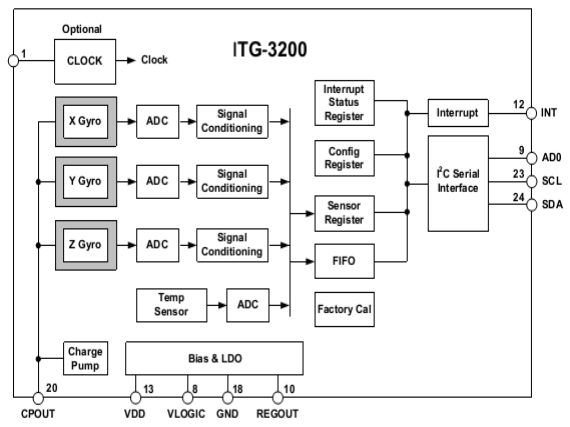
[picture p77: figure]

Hình 2.27: Sơ đồ khối cảm biến ITG3200

Cảm biến từ trường HMC5883L (triple-axis magnetometer)
HMC5883L là cảm biến từ trường có độ phân giải ± 8Oe tích hợp truyền dữ liệu I2C.

Hình 2.28: Cảm biến HMC5883L

### 2.3.3.4 Mạch cầu H

Gồm 4 Mosfet có tác dụng đảo chiều động cơ

Đồ án tốt nghiệp | Trang 48

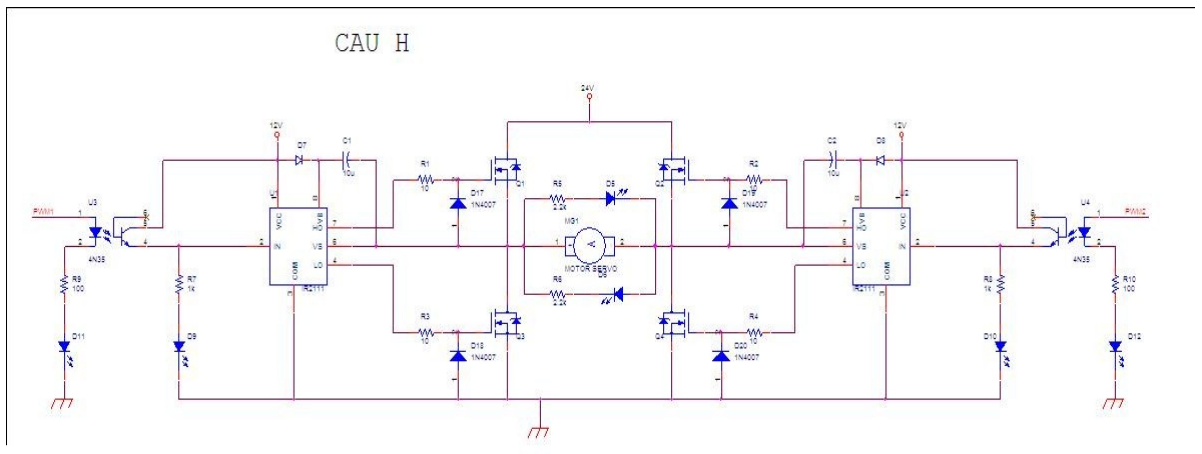
[picture p78: figure]

Hình 2.29: Sơ đồ nguyên lý mạch cầu H

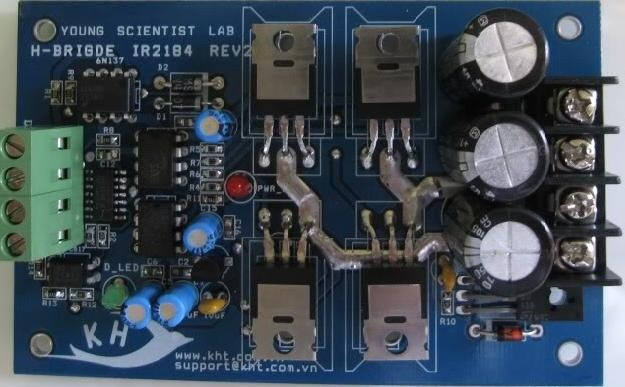
[picture p79: figure]

Hình 2.30: Mạch cầu H thực tế

### 2.3.3.5 Encoder

Encoder hiệu sharp100 xung/vònggắn trên thân robot, tiếp xúc không trượt với bánh xe robot, tỉ lệ số vòng bánh xe encoder và số vòng bánh xerobot là 2:1 để đovị trí vàvận tốc di chuyểncủa robot.

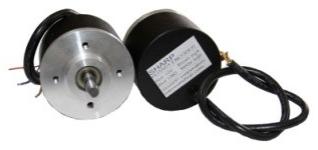
[picture p80: figure]

Hình 2.31: Encoder

### 2.3.3.6 Module thu phát, truyền nhận dữ liệu 1 module RF để điều khiển từ xa mọi hoạt động của robot, 1 module bluetooth

truyền tín hiệu uart về máy tính để theo dõi và giám sát robot.

Đồ án tốt nghiệp | Trang 49

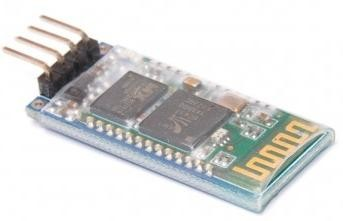
[picture p81: figure]

Hình 2.32: Module Bluetooth HC06 slave

### 2.3.3.7 Động cơ

Mô hình sử dụng 2 động cơ có hộp số, 12VDC, tỉ số truyền 30, moment xoắn 2Nm

Hình 2.33: Động cơ

Đồ án tốt nghiệp | Trang 50

## Chương 3. Thiết kế hệ thống

### 3.1 Thiết kế phần cứng mô hình Robot 2 bánh tự cân bằng

### 3.1.1 Thiết kế cơ khí

Khung sườn sử dụng chất liệu.mica trong và mica màu 4,5mm, được cố định theo cơ cấu ghép rãnh . Cơ cấu chuyền động encorder áp bánh và bố trí mạch theo chiều dựng đứng.

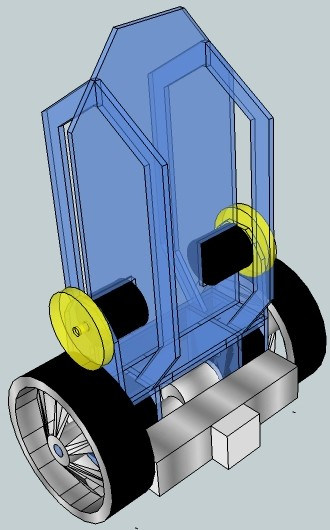
[picture p82: figure]

Hình 3.1: | Bản vẽ 3D mô hình robot 2 bánh tự cân bằng
Đồ án tốt nghiệp | Trang 51

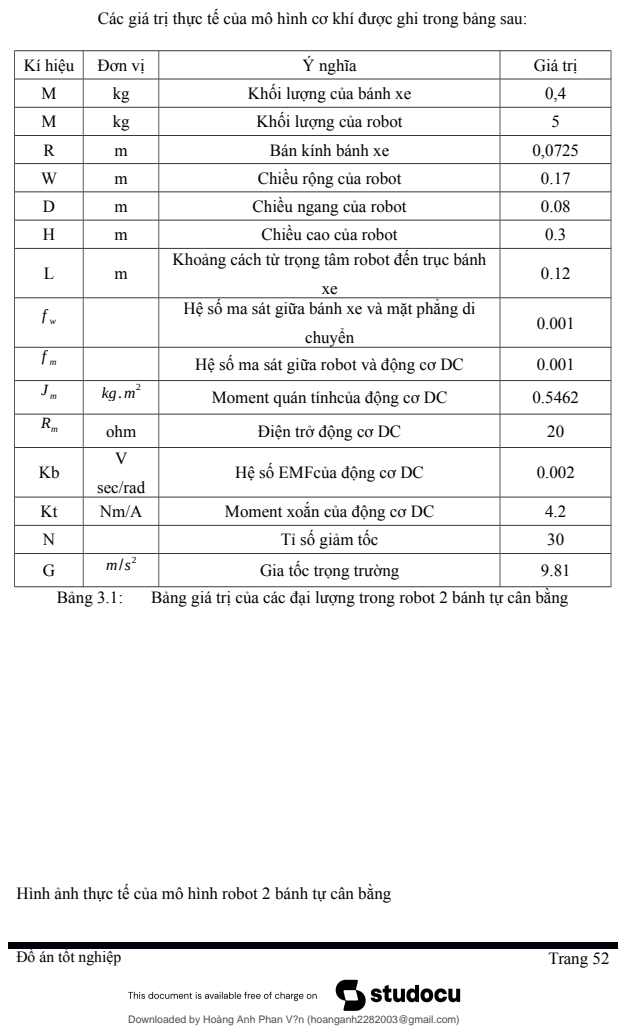
[picture p83: page 54]
Kí hiệu; Đơn vị; Ý nghĩa; Giá trị; Khối lượng của bánh xe; Khối lượng của robot; Bán kính bánh xe; Chiều rộng của robot; Chiều ngang của robot; Chiều cao của robot; chuyển; Hệ số ma sát giữa robot và động cơ DC; Moment quán tínhcủa động cơ DC; ohm; Điện trở động cơ DC; sec/rad; Hệ số EMFcủa động cơ DC; Moment xoắn của động cơ DC; Tỉ số giảm tốc; Gia tốc trọng trường; Bảng 3.1:; Bảng giá trị của các đại lượng trong robot 2 bánh tự cân bằng; Đồ án tốt nghiệp; Trang 52

Các giá trị thực tế của mô hình cơ khí được ghi trong bảng sau:

Khoảng cách từ trọng tâm robot đến trục bánh

Hệ số ma sát giữa bánh xe và mặt phẳng di

Hình ảnh thực tế của mô hình robot 2 bánh tự cân bằng

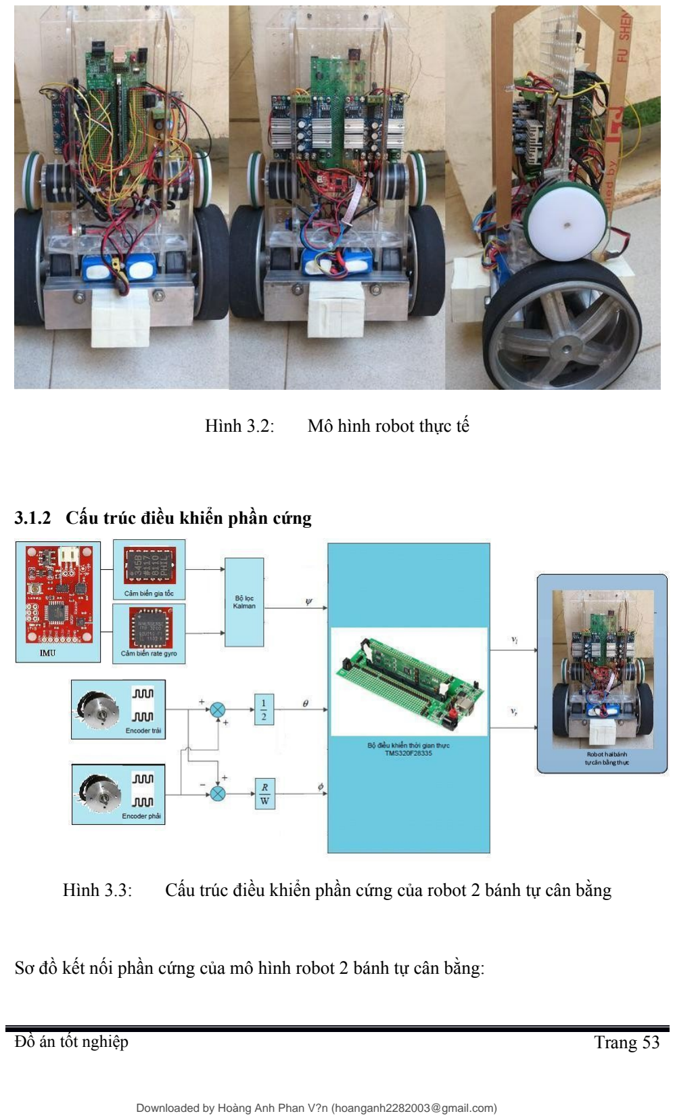
[picture p84: page 55]

Hình 3.2: Mô hình robot thực tế

### 3.1.2 Cấu trúc điều khiển phần cứng

Hình 3.3: Cấu trúc điều khiển phần cứng của robot 2 bánh tự cân bằng

Sơ đồ kết nối phần cứng của mô hình robot 2 bánh tự cân bằng:

Đồ án tốt nghiệp | Trang 53

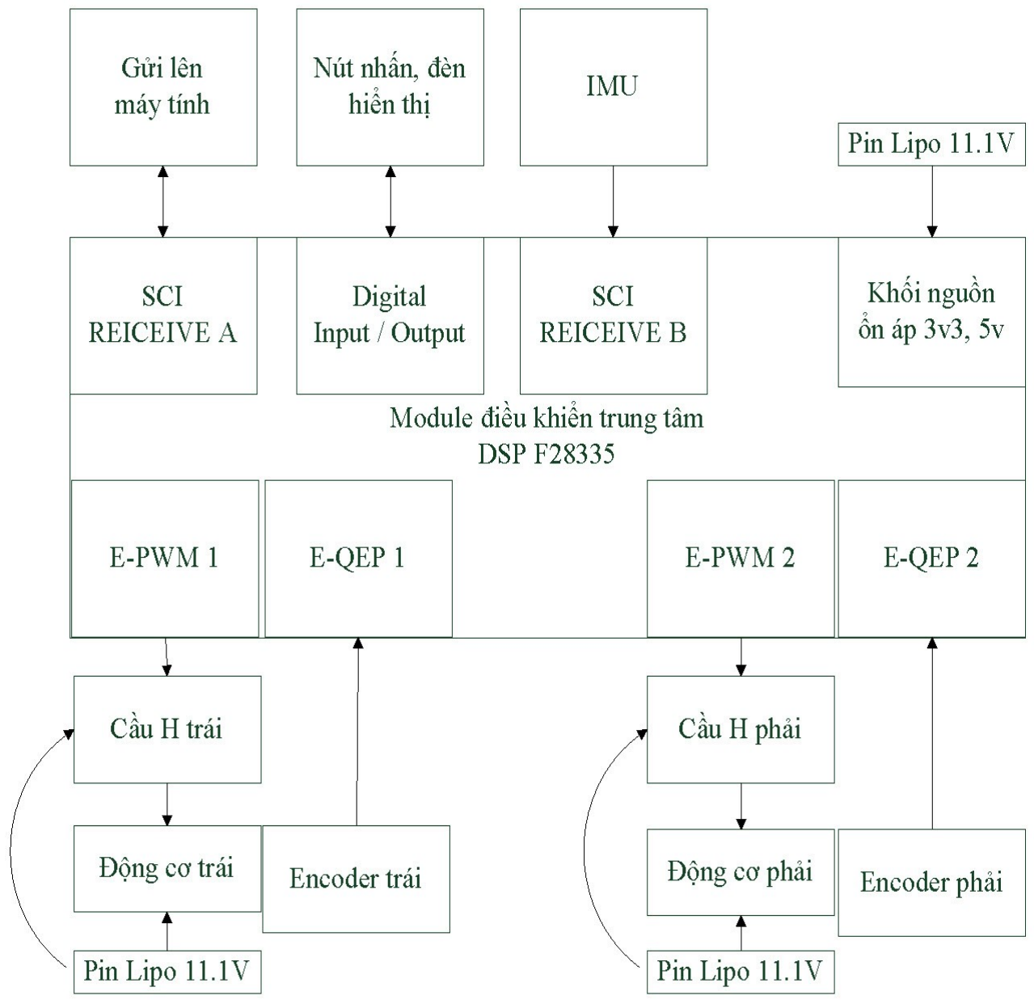
[picture p85: figure]

Hình 3.4: Sơ đồ kết nối phần cứng

### 3.2 Thiết kế phần mềm

### 3.2.1 Bộ lọc Kalman cho thành phần IMU

Robot sử dụng hai cảm biến: cảm biến gia tốc (accelecrometer) và cảm biến con quayhồi chuyển(gyroscope) để đo góc nghiêng và vận tốc góc nghiêng.Tuy nhiên, vấn đề đặt ra là cần phải kết hợp thông tin từ hai cảm biến để xác định chính xác góc nghiêng thực của hệ robot loại bỏ được ảnh hưởng của nhiễu đo và nhiễu quá trình. Để giải quyết vấn đề này, giải thuật lọc Kalman được sử dụng, với mục đích ước lượng giá trị góc nghiêng của hệ robot từ hai loại cảm biến trên và loại bỏ được ảnh hưởng của nhiễu. Bộ lọc Kalman được khảo sát với mô hình 3 biến trạng thái như sau:

Đồ án tốt nghiệp | Trang 54

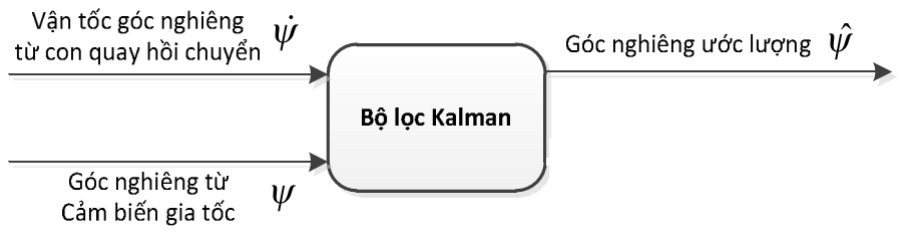
[picture p86: figure]

Hình 3.5: Mô hình bộ lọc Kalman với 3 biến trạng thái.

Với mô hình này, bộ lọc sử dụng 2 biến ngõ vào là vận tốc góc nghiêng từ cảm biến con quay hồi chuyển và góc nghiêng từ cảm biến gia tốc; 1 biến ngõ ra là góc nghiêng ước lượng

### 3.2.1.1 Lập trình bộ lọc Kalman

Ma trận Pkhoitao đặc trưng cho tương quan sai số:

Với Pkhoitao=[
1 0
0 1 ] | [3.1]

angle, q_bias lần lượt là góc, vận tốc sử dụng trong tính toán của bộ lọc.

R tượng trưng cho giá trị nhiễu coveriance. Trong trường hợp này, nó là ma trận 1x1 được mong đợi có giá trị 0.08 rad ≈
4,5 độ từ cảm biến gia tốc:
R_angle=0.08 | [3.2]

Q là ma trận 2x2 tượng trưng cho tiến trình nhiễu coveriance. Trong trường hợp này, nó chỉ mức độ tin cậy của cảm biến gia tốc quan hệ với cảm biến gyro:

Q=

[
qangle | 0
0 | qgyro ]
=[
0.001 | 0
0 | 0.003] | [3.3]
- “Giai đoạn dự báo”

Trong mỗi khoảng chu kỳ quét dt với giá trị cơ sở gyro được canh chỉnh tùy theo nhu cầu sử dụng và cách lắp cơ khí bởi người dùng module IMU. Giai đoạn sẽ cập nhật góc hiện thời và vận tốc ước lượng.
Vecto giá trị: X=[
angle
gyrobias] | [3.4]
Đồ án tốt nghiệp | Trang 55

Nó chạy trên sự ước lượng giá trị qua hàm giá trị:

X´ =[
angle ´
gyro´

bias]
=[
gyro−gyrobias
0 | ] | [3.5]

Và cập nhật ma trận covariance qua hàm :

P´ =AP+P A'
+Q | [3.6]

P´ =A . P+P . A'
+Q lý thuy t ế là(P=A . P . AT
+Q)
| [3.7]

A là Jacobian của X´
với giá trị mong đợi :

A=

[
d(angle ´ )

d(angle)

d(angle ´ )

d(gyrobias)
d( ´ gyrobias)
d(angle)

d( ´ gyrobias)

d(gyrobias)]

=[
0 −1
0 | 0 ] | [3.8]

Để dễ dàng trong việc lập trình, ma trận P sẽ được khai triển đến mức tối thiểu :

P´ =

[
Qangle−P[ 0 ] [ 1]−P[1] [0] −P[ 1] [1]
−P[ 1] [1] | Qgyro | ] | [3.9]

¿[
0 −1

0 0 ][
P[ 0] [0] P[ 0][1]

P[ 1] [0] P[1] [1]]
+

[
P[ 0][0] P[0] [1]

P[1] [0] P[1][1]][
0 0

−1 0]
+

[
Qangle | 0
0 | Qgyro]

¿[
−P[1] [0] −P[ 1] [ 1]
0 | 0 | ]
+

[
−P[0] [ 1] 0

−P[1] [1] 0]
+

[
Qangle | 0
0 | Qgyro ] | [3.10]

Lưu trữ giá trị ước lượng chưa bias của gyro :

rate=q=qm−qbias | [3.11]

(Với rate là sai số góc tiên đoán)

Cập nhật ước lượng góc :

Đồ án tốt nghiệp | Trang 56

angle=angle+ ´ angle dt=angle+rate dt | [3.12]

Cập nhật ma trận covariance :

P=P+P dt ´

¿[
P[ 0] [0] P[ 0] [1]

P[ 1] [0] P[ 1] [1]]
+

[
Qangle−P[0][1]−P[1][0] −P[ 1] [1]
−P[ 1] [1] | Qgyro | ]
dt | [3.13]
- “Giai đoạn cập nhật giá trị bộ lọc Kalman“

Ma trận C là ma trận 1x2 (giá trị x trạng thái), đó là ma trận Jacobian của giá trị đo lường với giá trị mong đợi. Trong trường hợp này C là :

C=[
d(anglem

)
d(angle)

d(anglem

)

d(gyrobias)]
=[1 0]
(C chính là H) | [3.14]

Vì giá trị góc đáp ứng trực tiếp với góc ước lượng và giá trị góc không quan hệ với giá trị gyro bias nên C_0 cho thấy giá trị trạng thái quan hệ trực tiếp với trạng thái ước lượng như thế nào, C_1 cho thấy giá trị trạng thái không quan hệ với giá trị cơ sở gyro ước lượng

Error là giá trị khác nhau trong giá trị đo lường và giá trị ước lượng. Trong trường hợp này, nó khác nhau giữa hai gia tốc kế đo góc và góc ước lượng.

angl eerror=anglem−angle | [3.15]

Tính sai số ước lượng. Từ bộ lọc Kalman :

E=CP CT

+R=[1 0] [
P[0 ] [ 0] P[ 0] [1]

P[1 ] [ 0] P[ 1] [ 1] ][
1

0]
+R=P[ 0] [ 0]+R
[3.16]

PCt0=C[ 0 ] x P[0][0 ]
[3.17]

PCt1=C[ 0] x P[1][0]
[3.18]

Ước tính bộ lọc Kalman đạt được. từ lý thuyết bộ lọc Kalman :
[
K 0

K1 ]=

[
PCt 0

/ E
PCt 1
/ E] | [3.19]
Đồ án tốt nghiệp | Trang 57

P=(1−KH) P=P−KHP=P−KCP | [3.20]

Ta có phép nhân điểm trôi (floating point)

CP=[ 1 0] [
P[ 0] [0] P[ 0][1]

P[ 1] [0] P[1] [1]]=[ P[0] [0] P[ 0] [1]]=[t

0

t

1]
[3.21]

P=

[
P[ 0 ][0] P[0 ][1]

P[1] [0] P[1 ][1]]⁻[
K 0

K 1]
[t

0

t

1 ]=P−

[
K 0.t

0 K 0.t
1
K1.t
0 | K 1.t
1 ] | [3.22]

Cập nhật giá trị ước lượng. Lần nữa, từ Kalman :

X=

[
angle

gyrobias]=X+K (Zmeasure−H Xestimate )=X+K

[
angleerr
angleerr] | [3.23]

err
angleerr=q¿

[3.24]

### 3.2.1.2 Mô phỏng bộ lọc Kalman đã lập trình

Sử dụng Matlab Simulink để kiểm tra tính đúng đắn của bộ lọc Kalman đã lập trình ở phần 3.2.1.1

Mô hình bộ lọc Kalman trong Matlab Simulink được xây dựng như sau :

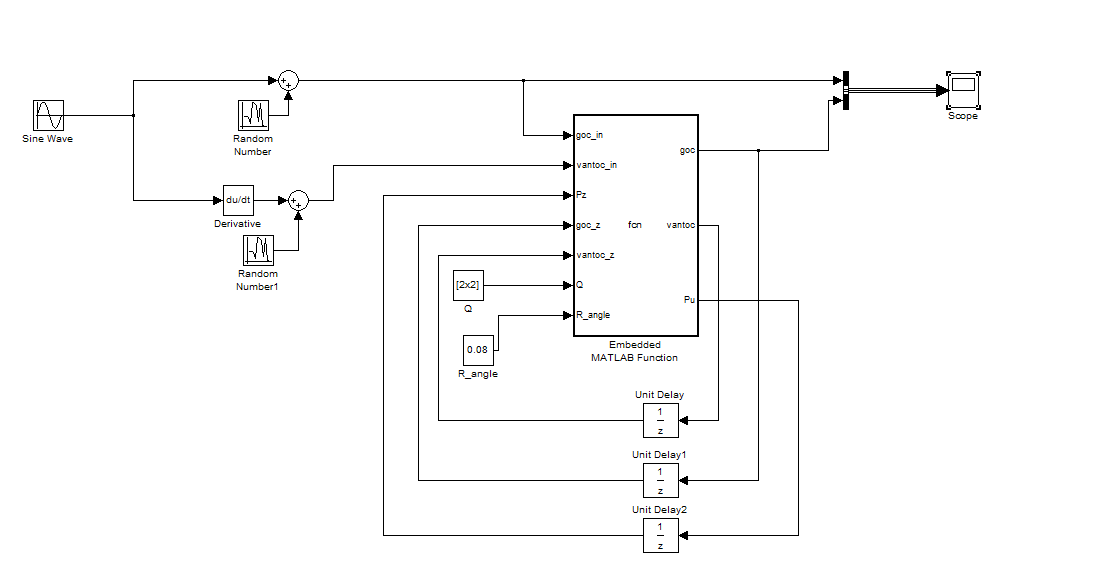
[picture p87: figure]

Hình 3.6: Mô hình bộ lọc Kalman trong Matlab Simulink

Khi cho nhiễu tác động, ngõ ra của bộ lọc Kalman đã lọc nhiễu tốt:

Đồ án tốt nghiệp | Trang 58

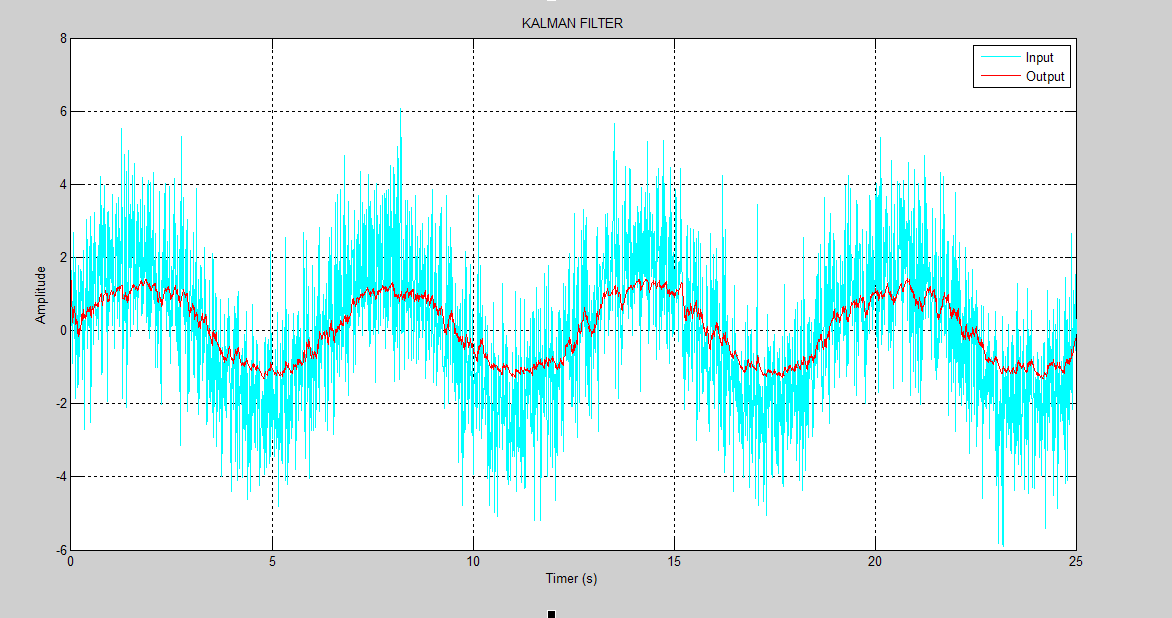
[picture p88: figure]

Hình 3.7: Tín hiệu vào-ra của bộ lọc Kalman

### 3.2.1.3 Ứng dụng bộ lọc Kalman vào mô hình thật

Áp dụng bộ lọc Kalman để ước lượng góc nghiêng so với điểm 0 của mô hình robot 2 bánh tự cân bằng trong thực tế, chu kì lấy mẫu 1ms, ma trận các trọng số được chọn thử sai trong quá trình thực nghiệm để cho kết quả tốt nhất như sau:

Q= [0.001 0; 0 0.003];

R=0.08

dt=0.064 s

Đồ án tốt nghiệp | Trang 59

Kết quả quan sát hệ thống thực của giá trị góc nghiêng đo được từ cảm biến IMU sử dụng trong mô hình

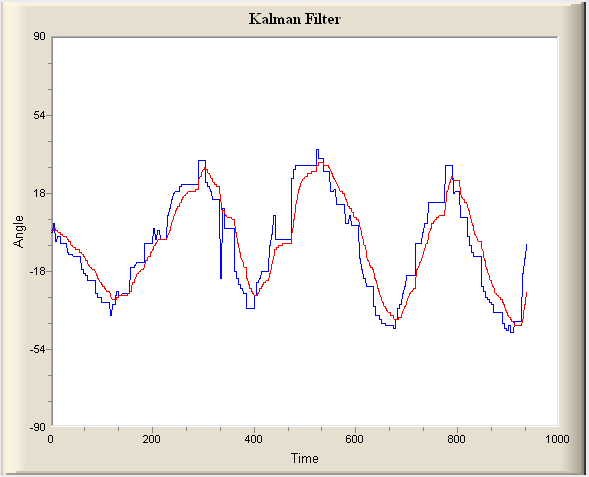
[picture p89: figure]

Hình 3.8: So sánh khi cho tín hiệu góc nghiêng ngõ vào và ra của bộ lọc Kalman

( đường màu xanh là góc nghiêng chưa qua bộ lọc, đường màu đỏ là tín hiệu góc
| nghiêng sau khi qua bộ lọc)
Đồ án tốt nghiệp | Trang 60

### 3.2.2 Lưu đồ giải thuật

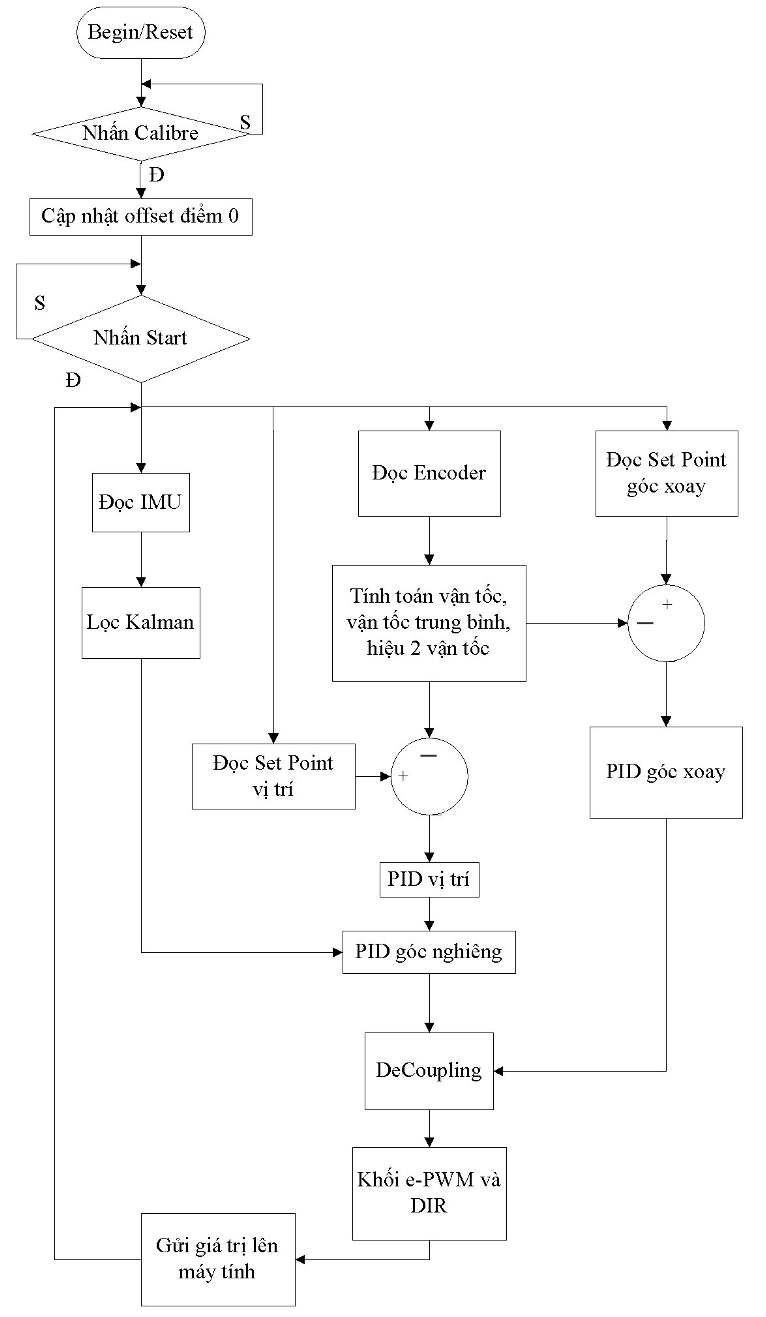
[picture p90: figure]

Hình 3.9: | Lưu đồ giải thuật cho mô hình robot 2 bánh tự cân bằng
Đồ án tốt nghiệp | Trang 61

### 3.2.3 Bộ điều khiển nhúng cho robot 2 bánh tự cân bằng

### 3.2.3.1 Giới thiệu

Quá trình điều khiển robot được thực hiện trên vi điều khiển DSP TMS320F28335 với sự hỗ trợ của thưviện Target Support Package của Matlab –hỗ trợ cho các vi điều khiển họ TI C2000. Bộ điều khiển được thiết kế trên Simulink trong miền rời rạc,sau đó các ứng dụng được Embedded IDE Link biên dịch sang mã ngôn ngữ C tương thích với thư viện hỗ trợ bởi Code Composer, sau đó tiếp tục được Code Composer biên dịch thành mã máy nhúng vào DSP TMS320F28335.

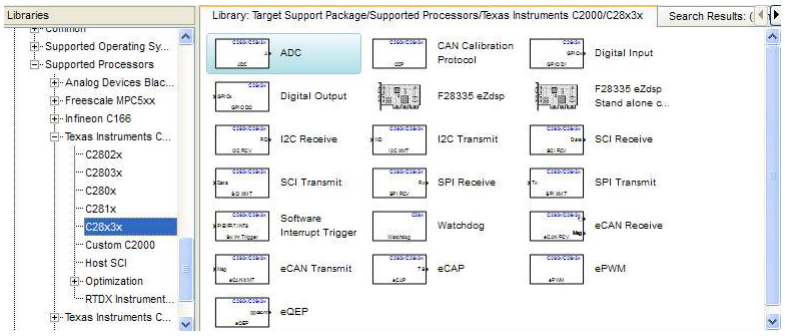
[picture p91: figure]

Hình 3.10 : Thư viện Target Support Package cho DSP F28335

### 3.2.3.2 Các khối chức năng sử dụng trong chương trình

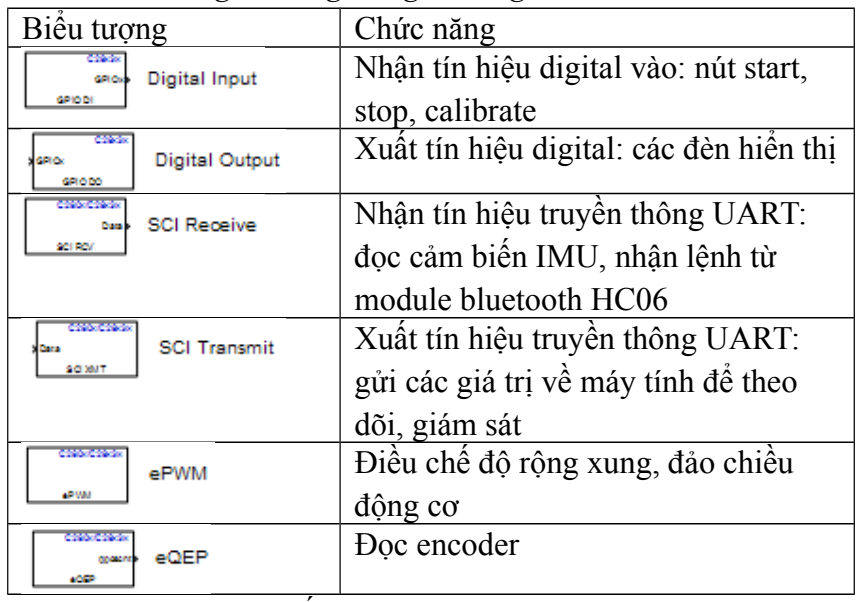
[picture p92: figure]
Biểu tượng; Chức năng; Nhận tín hiệu digital vào: nút start, stop, calibrate Xuất tín hiệu digital: các đèn hiển thị; Nhận tín hiệu truyền thông UART: đọc cảm biến IMU, nhận lệnh từ module bluetooth HC06 Xuất tín hiệu truyền thông UART: gửi các giá trị về máy tính để theo dõi, giám sát Điều chế độ rộng xung, đảo chiều động cơ Đọc encoder

Bảng 3.2: | Các khối chức năng sử dụng trong chương trình
Đồ án tốt nghiệp | Trang 62

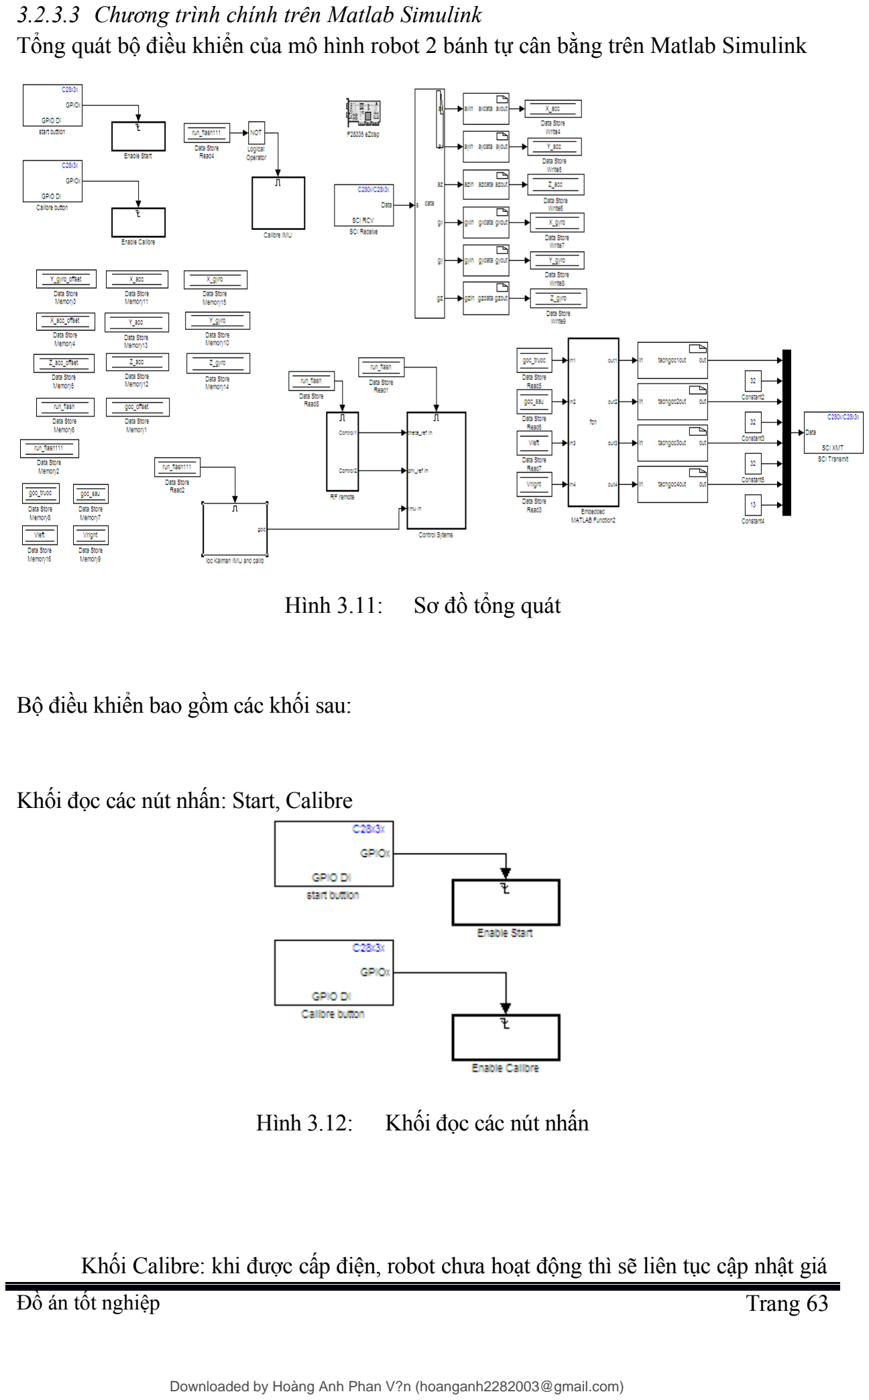
[picture p93: page 65]

### 3.2.3.3 Chương trình chính trên Matlab Simulink

Tổng quát bộ điều khiển của mô hình robot 2 bánh tự cân bằng trên Matlab Simulink

Hình 3.11: Sơ đồ tổng quát

Bộ điều khiển bao gồm các khối sau:

Khối đọc các nút nhấn: Start, Calibre

Hình 3.12: Khối đọc các nút nhấn

Khối Calibre: khi được cấp điện, robot chưa hoạt động thì sẽ liên tục cập nhật giá
Đồ án tốt nghiệp | Trang 63

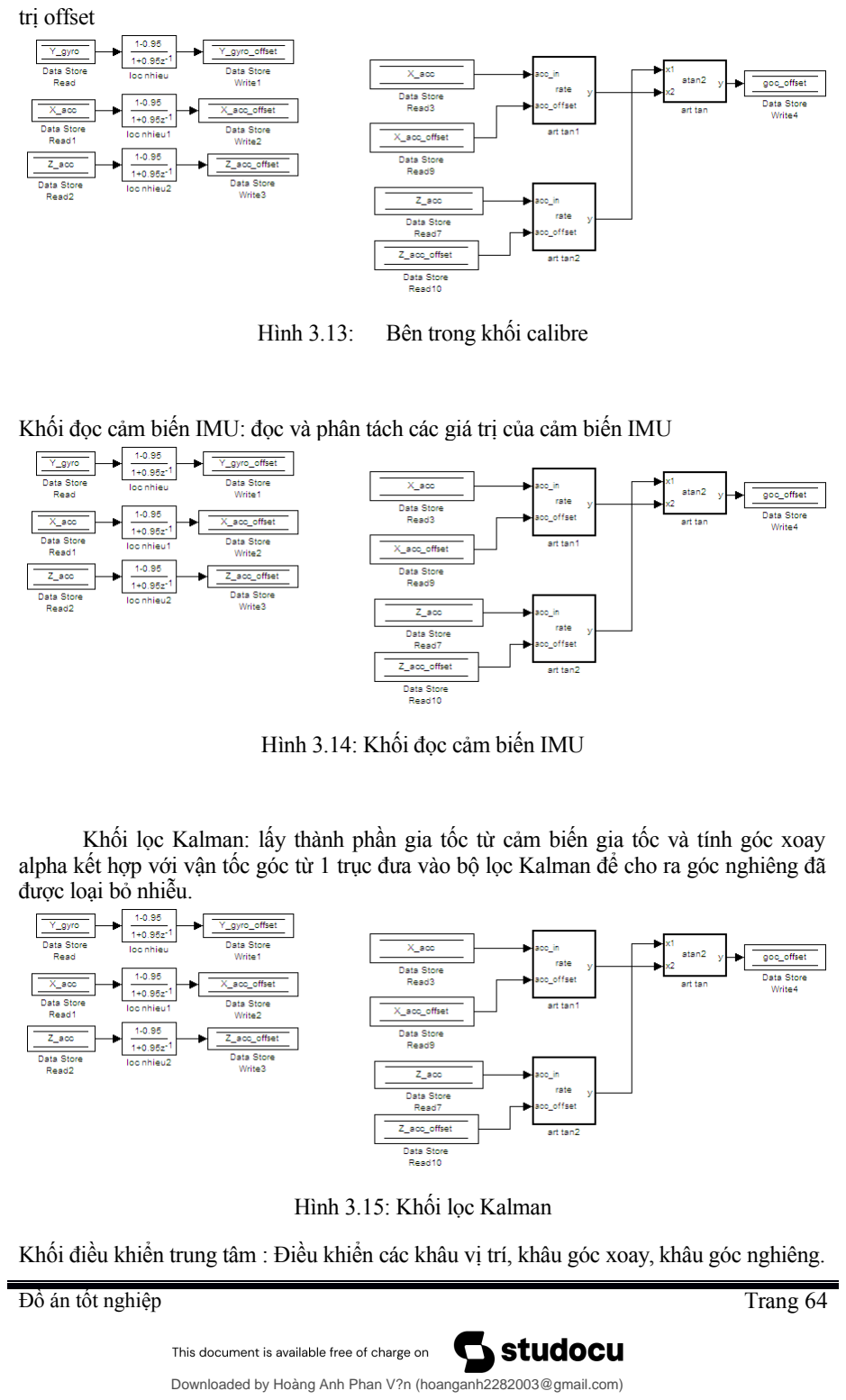
[picture p94: page 66]

trị offset

Hình 3.13: Bên trong khối calibre

Khối đọc cảm biến IMU: đọc và phân tách các giá trị của cảm biến IMU

Hình 3.14: Khối đọc cảm biến IMU

Khối lọc Kalman: lấy thành phần gia tốc từ cảm biến gia tốc và tính góc xoay alpha kết hợp với vận tốc góc từ 1 trục đưa vào bộ lọc Kalman để cho ra góc nghiêng đã được loại bỏ nhiễu.

Hình 3.15: Khối lọc Kalman

Khối điều khiển trung tâm : Điều khiển các khâu vị trí, khâu góc xoay, khâu góc nghiêng.

Đồ án tốt nghiệp | Trang 64

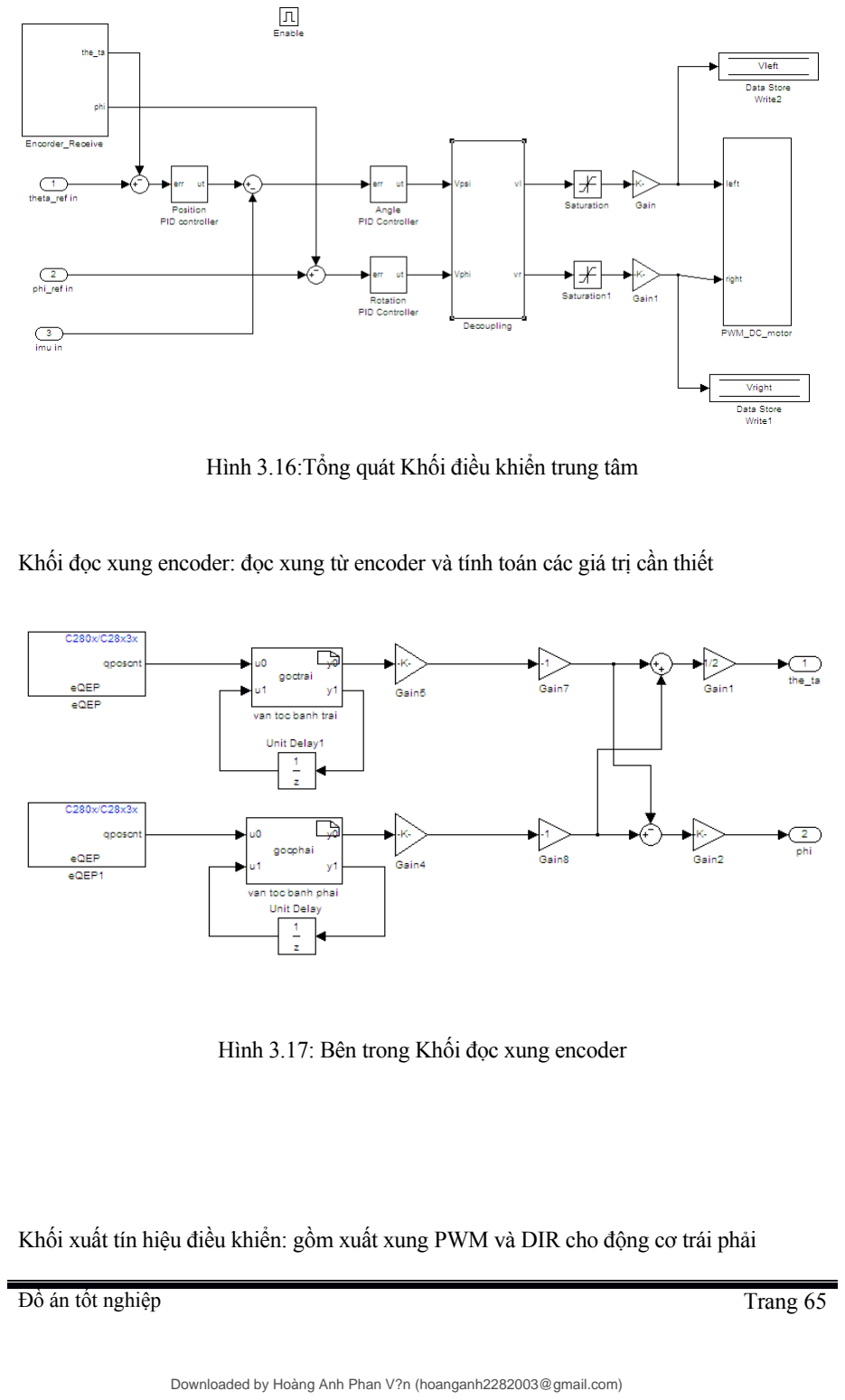
[picture p95: page 67]

Hình 3.16:Tổng quát Khối điều khiển trung tâm

Khối đọc xung encoder: đọc xung từ encoder và tính toán các giá trị cần thiết

Hình 3.17: Bên trong Khối đọc xung encoder

Khối xuất tín hiệu điều khiển: gồm xuất xung PWM và DIR cho động cơ trái phải

Đồ án tốt nghiệp | Trang 65

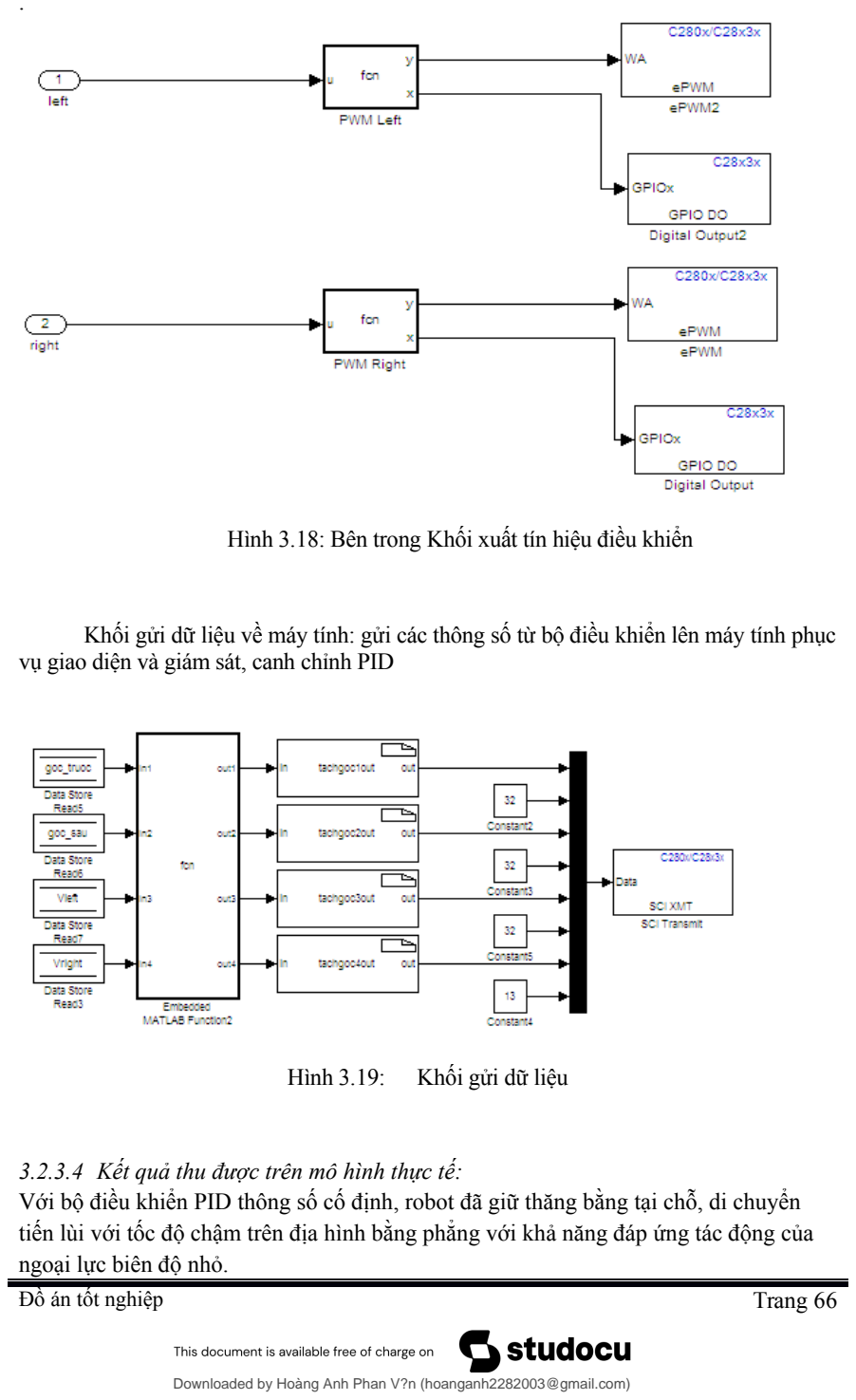
[picture p96: page 68]

Hình 3.18: Bên trong Khối xuất tín hiệu điều khiển

Khối gửi dữ liệu về máy tính: gửi các thông số từ bộ điều khiển lên máy tính phục vụ giao diện và giám sát, canh chỉnh PID

Hình 3.19: Khối gửi dữ liệu

### 3.2.3.4 Kết quả thu được trên mô hình thực tế:

Với bộ điều khiển PID thông số cố định, robot đã giữ thăng bằng tại chỗ, di chuyển tiến lùi với tốc độ chậm trên địa hình bằng phẳng với khả năng đáp ứng tác động của ngoại lực biên độ nhỏ.
Đồ án tốt nghiệp | Trang 66

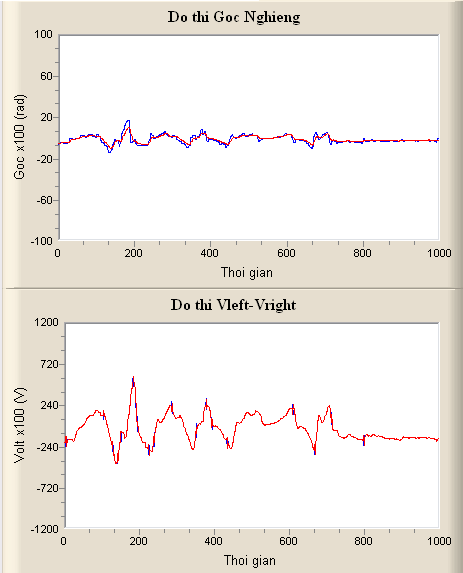
[picture p97: figure]

Hình 3.20: Ngõ ra góc nghiêng và điện áp trên 2 động cơ khi chạy mô hình thực tế

### 3.2.4 Giao diện trên máy tính

Trên mô hình có sử dụng module bluetooth để truyền dữ liệu không dây các giá trị gửi về từ robot, từ đó vẽ biểu đồ so sánh nhằm đối chiếu, đánh giá kết quả thực hiện.

Giao diện trên máy tính được xây dựng bằng phần mềm Visual Basic 6.0, có sử dụng thêm thư viện MSCOMM32.OCX để giao tiếp với cổng COM và thư viện NTGRAPH.OCX để vẽ biểu đồ.

Phần mềm giao diện đơn giản dễ sử dụng, có 2 nút để điều khiển phần mềm:

− | Connect: Thiết lập kết nối đến cổng com, sẵn sàng để nhận giá trị từ robot gửi về
− | Draw: Vẽ biểu đồ theo thời gian
Đồ án tốt nghiệp | Trang 67

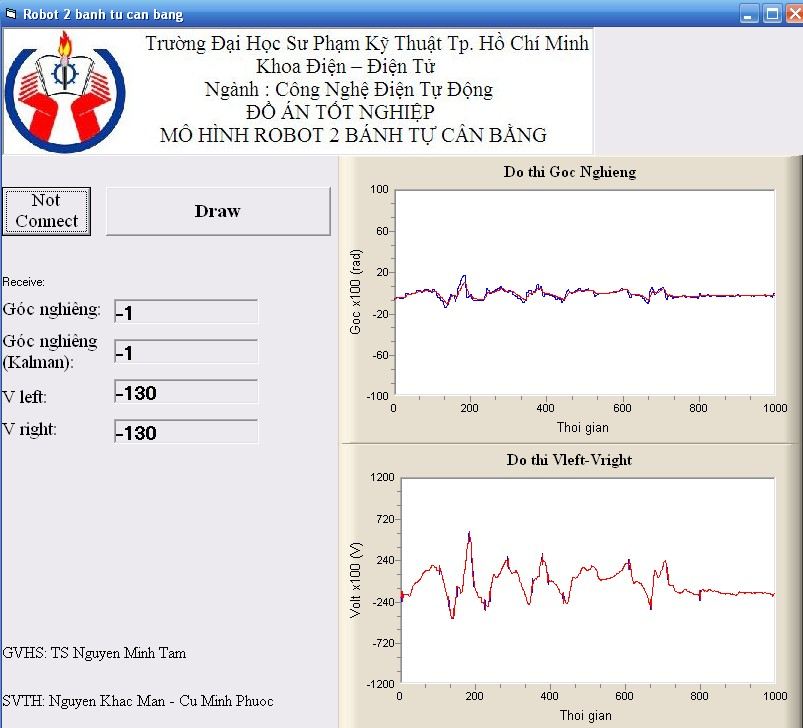
[picture p98: figure]

Hình 3.21: Giao diện của chương trình giao tiếp máy tính

Đồ án tốt nghiệp | Trang 68

## Chương 4. Kết luận và hướng phát triển của đề tài

### 4.1 Những kết quả đã đạt được

- Thiết kế hoàn chỉnh, hoàn thiện mô hình robot 2 bánh tự cân bằng
- Thiết lập mô hình toán học, hàm trạng thái của mô hình và mô phỏng thành công mô hình trên Matlab Simulink.
- Các thành phần mạch điện và vi điều khiển hoạt động tốt:
− Giá trị cảm biến đọc về chính xác, không bị trễ , sai sót, mất frame truyền.
− | Mạch cầu H hoạt động ổn định không bị quá tải, quá nhiệt.
− | Đọc encoder chính xác, không bị sai lệch
− | Vi điều khiển hoạt động ổn định, không tự reset hoặc ngắt kết nối
- Giao tiếp với máy tính bằng UART và vẽ biểu đồ hoạt động của robot
- Mô hình có thể giữ thăng bằng tại chỗ.

### 4.2 Hạn chế của đề tài

Giữ cân bằng chưa tốt, dễ bị vọt lố.

Chịu tác động của ngoại lực còn yếu.

Hệ thống chưa đáp ứng đựợc khi hệ số ma sát và khối lượng M của robot thay đổi.

Chỉ có thể giữ thăng bằng tại chỗ mà chưa di chuyển được.

### 4.3 Kết luận

Mô hình robot 2 bánh tự cân bằng là một đề tài không mới nhưng đặt ra nhiều thách thức trong nghiên cứu và chế tạo. Để có thể thiết kế một mô hình robot 2 bánh tự cân bằng hoàn chỉnh, linh hoạt hơn và làm cơ sở để chế tạo xe 2 bánh tự cân bằng chở được người thì cần phải tính toán thật chính xác về kết cấu cơ khí, cũng như phải có được các thông số thật chính xác về động cơ, encoder, cảm biến và 1 bộ điều khiển có thể thích nghi được như mạng neuron…

### 4.4 Hướng phát triển

Trong tương lai mô hình robot 2 bánh tự cân bằng sẽ được phát triển như sau:

- Mô hình sẽ được điều khiển thông qua máy tính nhờ kết nối bluetooth và giao diện trên máy tính sẽ thân thiện trực quan hơn.
- Tối ưu hóa khối lượng, thuật toán để mô hình có thể hoạt động trơn tru, linh hoạt, dễ điều khiển, tiết kiệm năng lượng.
- Có thể gắn thêm camera và gps để robot có thể định vị, ghi hình, xử lý ảnh và tự hoạt động trong không gian lớn.
- Mô hình robot 2 bánh tự cân bằng là tiền đề để phát triển thành xe 2 bánh tự cân bằng có thể chở được người và di chuyển linh hoạt hơn.
Đồ án tốt nghiệp | Trang 69

### PHỤ LỤC

### TÀI LIỆU THAM KHẢO

- Tài liệu trong nuớc:

Huỳnh Thái Hoàng, Lý thuyết điều khiển tự động, Nhà xuất bản Đại học Quốc Gia,2005

Huỳnh Thái Hoàng; “ Mô Hình Hóa Và Nhận Dạng Hệ Thống”; Đại học bách khoa Tp. HCM.

Nguy ễn Phùng Quang; “ Matlab và Simulink”; NXB khoa học và kỹ thuật.

Dương Hoài Nghĩa; “Điều khiển hệ thống đa biến”; Nhà xuất bản Đại học Quốc Gia

TP.HCM, 2007.

Huỳnh Thái Hoàng; “ Mô Hình Hóa Và Nhận Dạng Hệ Thống”; Đại học bách khoa Tp. HCM.

- Tài liệu nước ngoài:

Greg WELCH and Gary BISHOP , An Introduction to the Kalman Filter, University of North Carolina at Chapel Hill, 2004

- Tài liệu website:

http://www.segway.com

http://sourceforge.net

http://www.ti.com

http://www.mathworks.com/matlabcentral/answers/

Đồ án tốt nghiệp | Trang 67
