hoanganhidi0822/Self-Blancing-Robot/HardwareDesign/37-mm-dc-geared-motor-mounting-bracket-1.snapshot.11/37 mm DC GEARED MOTOR MOUNTING BRACKET.JPG

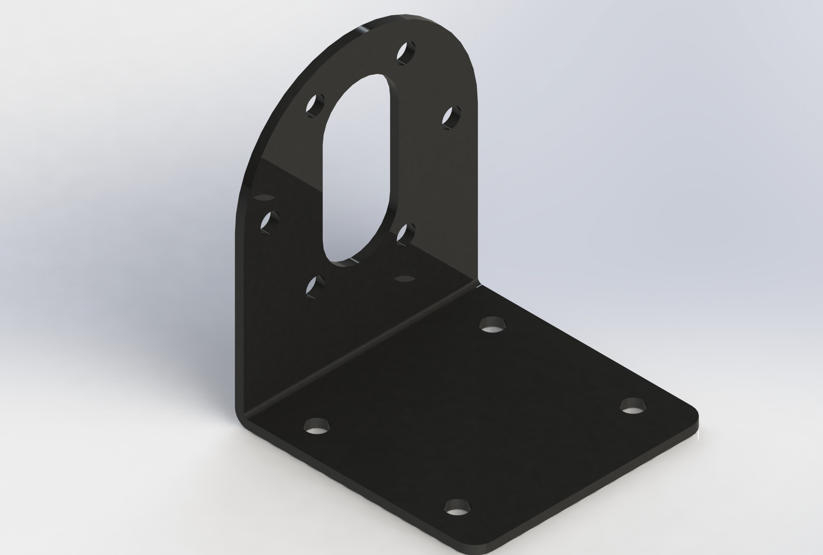
HardwareDesign/37-mm-dc-geared-motor-mounting-bracket-1.snapshot.11/37 mm DC GEARED MOTOR MOUNTING BRACKET.JPG
