hoanganhidi0822/Self-Blancing-Robot/ThamKhao/393143745_371910758610649_6651634608461503883_n.jpg

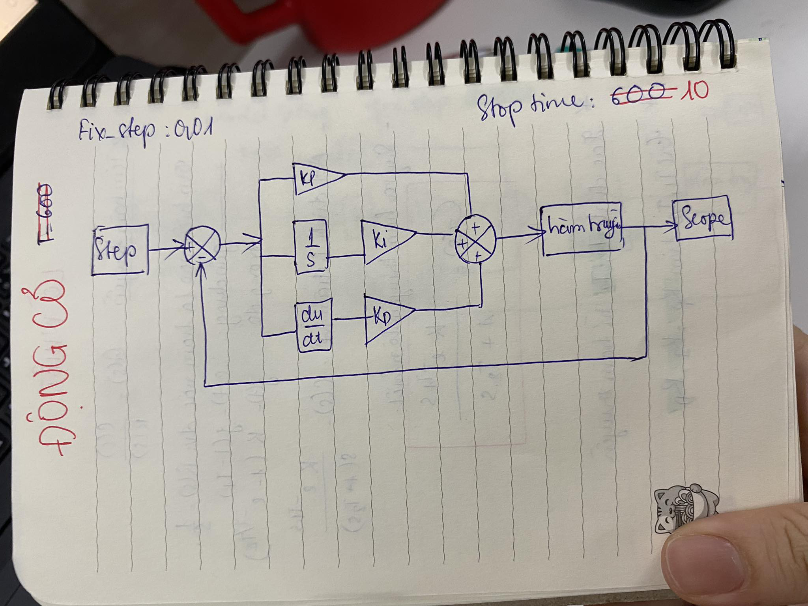
ThamKhao/393143745_371910758610649_6651634608461503883_n.jpg
