hoanganhidi0822/Self-Blancing-Robot/ThamKhao/393825267_7058815097518322_7724429285252872658_n.jpg

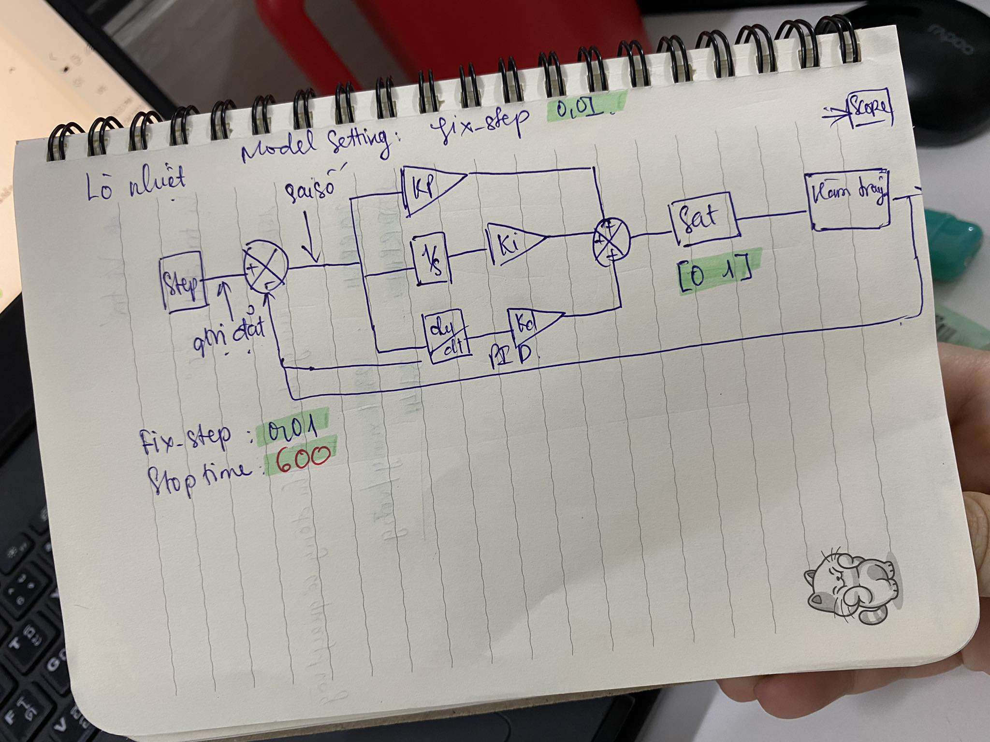
ThamKhao/393825267_7058815097518322_7724429285252872658_n.jpg
