hoanganhidi0822/Self-Blancing-Robot/HardwareDesign/65mm-wheel-1.snapshot.1/蓝色轮胎/65mm蓝色轮胎总装-实际外径68mm.SLDASM

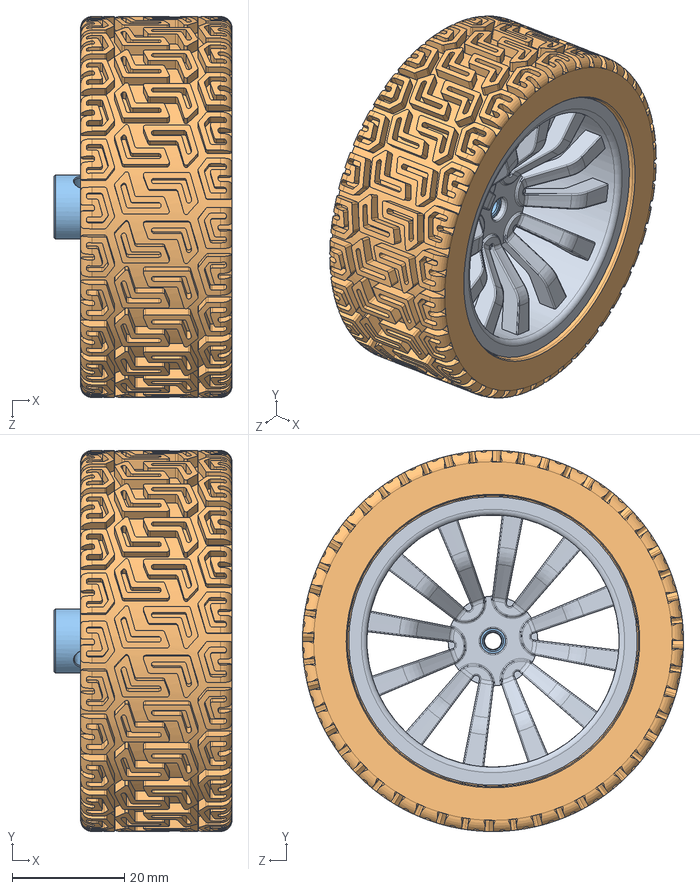
[picture p104: CAD file, 2024-08-01]
HardwareDesign/65mm-wheel-1.snapshot.1/蓝色轮胎/65mm蓝色轮胎总装-实际外径68mm.SLDASM
31.8 x 68.0 x 68.0 mm
蓝色轮毂
轮胎
3MM联轴器
