hoanganhidi0822/Self-Blancing-Robot/HardwareDesign/37-mm-dc-geared-motor-mounting-bracket-1.snapshot.11/37 mm DC Geared Motor Mounting Bracket.STEP

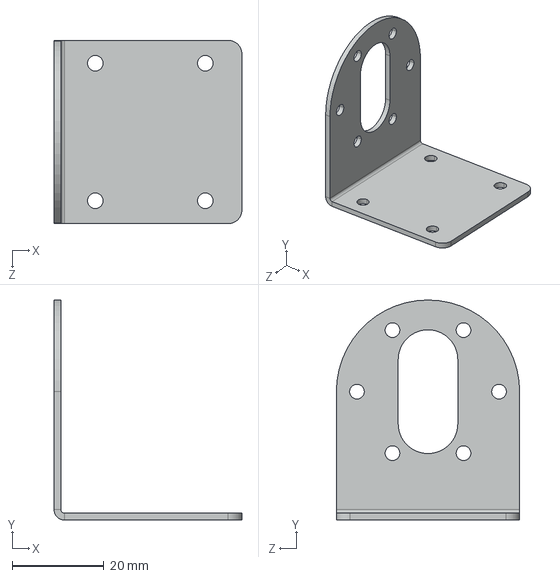
[picture p105: CAD file, 2024-08-01]
HardwareDesign/37-mm-dc-geared-motor-mounting-bracket-1.snapshot.11/37 mm DC Geared Motor Mounting Bracket.STEP
41.0 x 48.0 x 40.0 mm
