hoanganhidi0822/Self-Blancing-Robot/HardwareDesign/65mm-wheel-1.snapshot.1/蓝色轮胎/3MM联轴器.SLDPRT

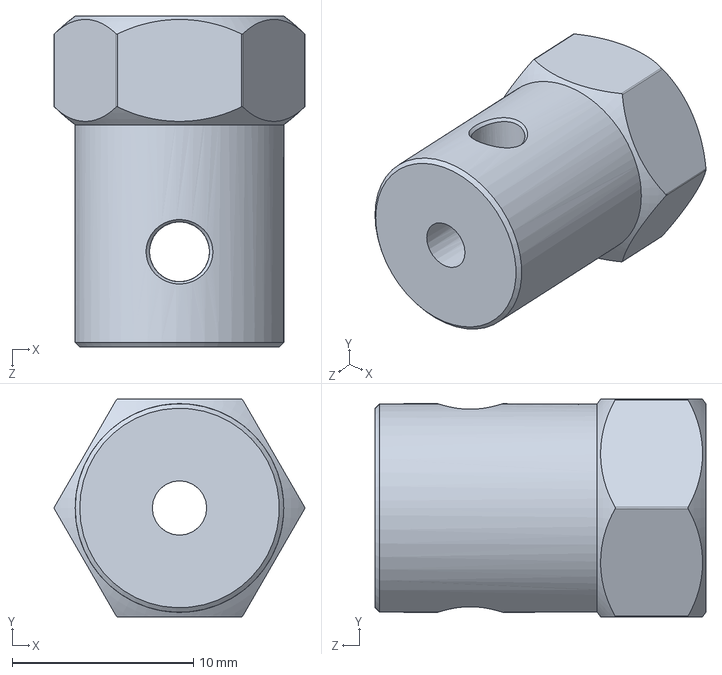
[picture p106: CAD file, 2024-08-01]
HardwareDesign/65mm-wheel-1.snapshot.1/蓝色轮胎/3MM联轴器.SLDPRT
13.8 x 12.0 x 18.2 mm
