hoanganhidi0822/Self-Blancing-Robot/HardwareDesign/jgb37-520-1.snapshot.2/COUPLING BRACKET, GEARED BODY TO DC MOTOR, JGB37-520.SLDPRT

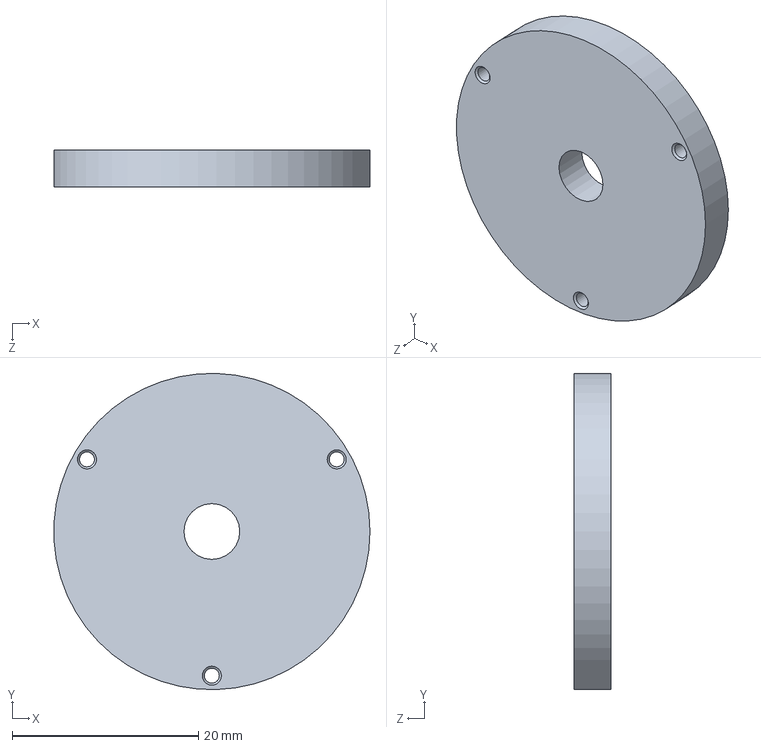
[picture p107: CAD file, 2024-08-01]
HardwareDesign/jgb37-520-1.snapshot.2/COUPLING BRACKET, GEARED BODY TO DC MOTOR, JGB37-520.SLDPRT
34.0 x 34.0 x 4.00 mm
