hoanganhidi0822/Self-Blancing-Robot/HardwareDesign/l298-module-1.snapshot.14/L298N Stepper Motor Driver (Red).SLDPRT

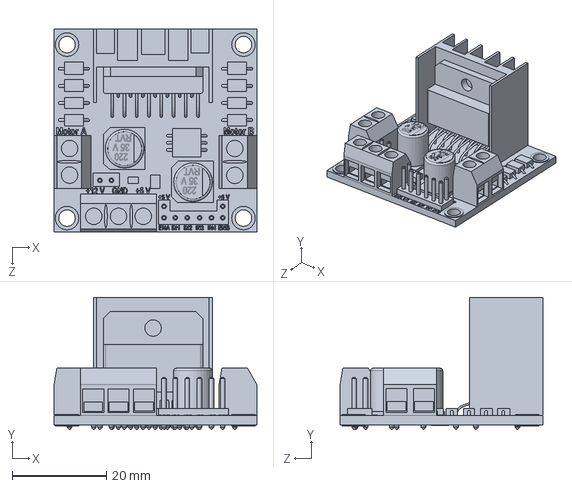
[picture p108: CAD file, 2024-08-01]
HardwareDesign/l298-module-1.snapshot.14/L298N Stepper Motor Driver (Red).SLDPRT
43.0 x 28.0 x 43.0 mm
