hoanganhidi0822/Self-Blancing-Robot/HardwareDesign/mattrenFinal.dxf

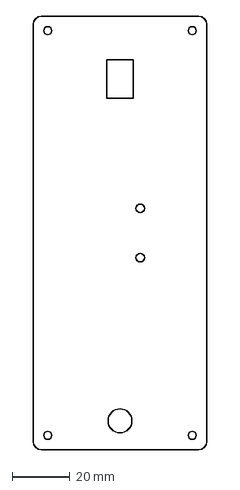
[picture p109: CAD file, 2024-08-01]
HardwareDesign/mattrenFinal.dxf
60.0 x 150.0 mm
