hoanganhidi0822/Self-Blancing-Robot/HardwareDesign/65mm-wheel-1.snapshot.1/蓝色轮胎/蓝色轮毂.SLDPRT

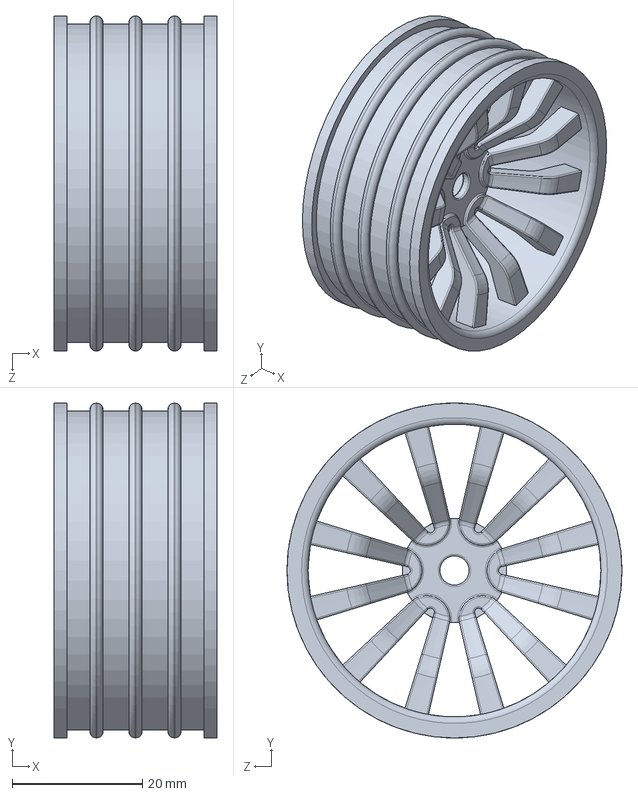
[picture p110: CAD file, 2024-08-01]
HardwareDesign/65mm-wheel-1.snapshot.1/蓝色轮胎/蓝色轮毂.SLDPRT
25.0 x 51.5 x 51.5 mm
