hoanganhidi0822/Self-Blancing-Robot/HardwareDesign/deduoi.dxf

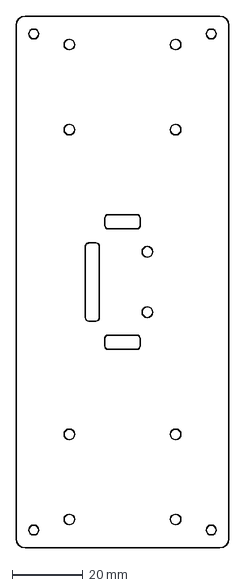
[picture p111: CAD file, 2024-08-01]
HardwareDesign/deduoi.dxf
60.0 x 150.0 mm
