hoanganhidi0822/Self-Blancing-Robot/HardwareDesign/jgb37-520-1.snapshot.2/GEARED BODY, MOTOR, JGB37-520.SLDPRT

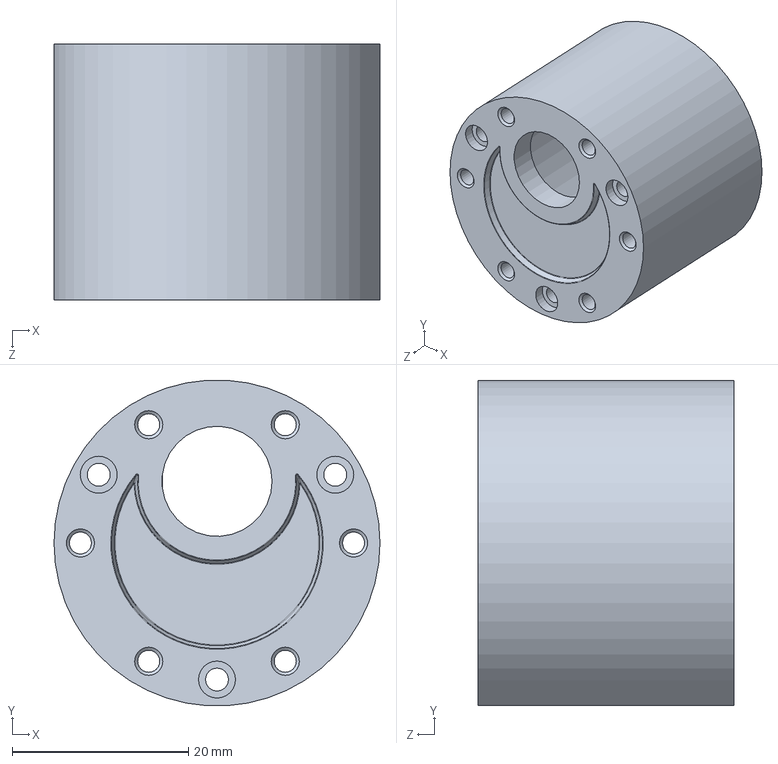
[picture p112: CAD file, 2024-08-01]
HardwareDesign/jgb37-520-1.snapshot.2/GEARED BODY, MOTOR, JGB37-520.SLDPRT
37.0 x 36.9 x 29.0 mm
