hoanganhidi0822/Self-Blancing-Robot/HardwareDesign/jgb37-520-1.snapshot.2/CONNECTION, DC MOTOR, JGB37-520.SLDPRT

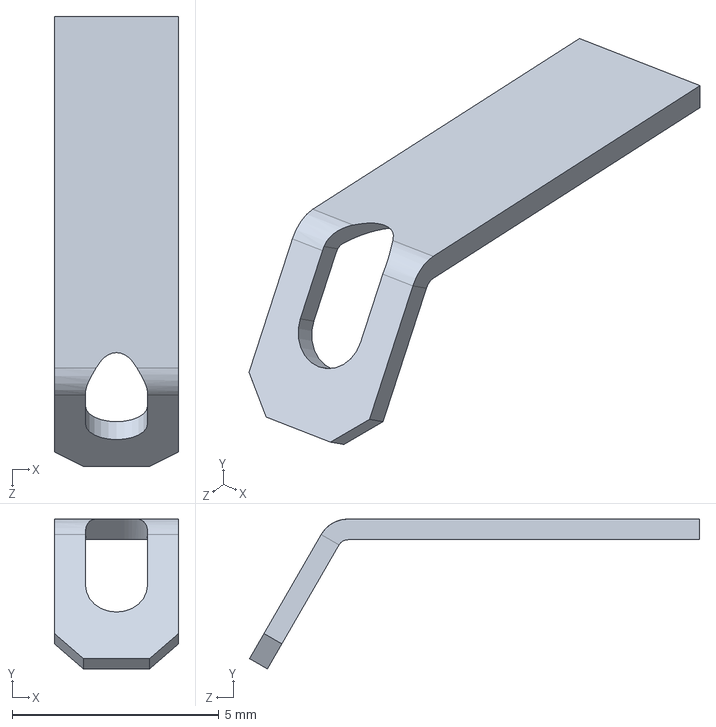
[picture p113: CAD file, 2024-08-01]
HardwareDesign/jgb37-520-1.snapshot.2/CONNECTION, DC MOTOR, JGB37-520.SLDPRT
3.00 x 3.62 x 10.9 mm
