hoanganhidi0822/Self-Blancing-Robot/HardwareDesign/mattren.dxf

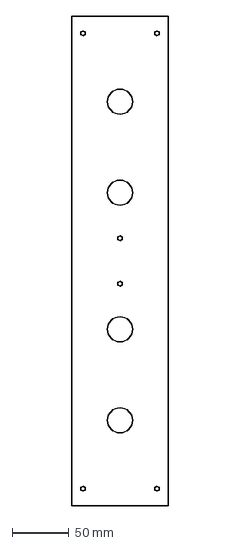
[picture p114: CAD file, 2024-08-01]
HardwareDesign/mattren.dxf
85.0 x 430.0 mm
