hoanganhidi0822/Self-Blancing-Robot/HardwareDesign/degiua.dxf

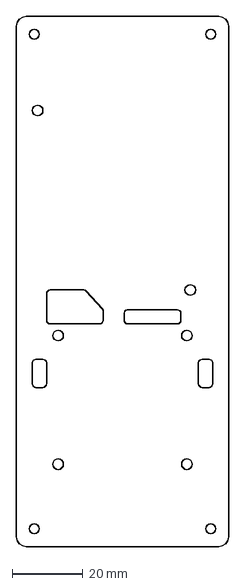
[picture p115: CAD file, 2024-08-01]
HardwareDesign/degiua.dxf
60.0 x 150.0 mm
