hoanganhidi0822/Self-Blancing-Robot/HardwareDesign/jgb37-520-1.snapshot.2/MOTOR SHAFT, JGB37-520.SLDPRT

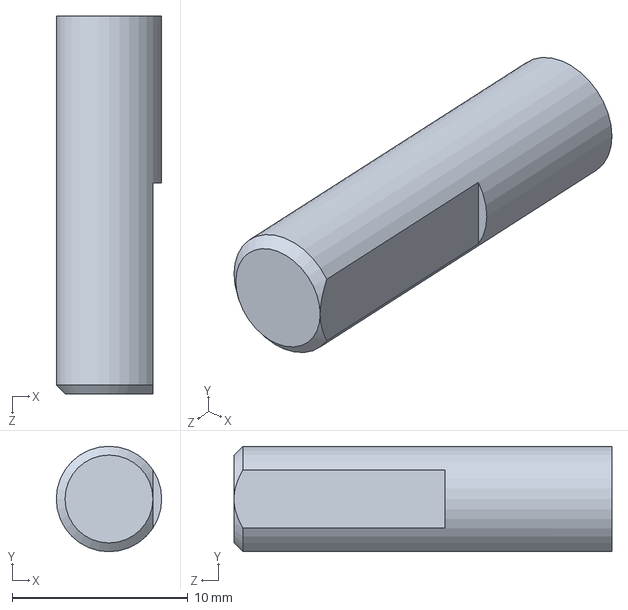
[picture p116: CAD file, 2024-08-01]
HardwareDesign/jgb37-520-1.snapshot.2/MOTOR SHAFT, JGB37-520.SLDPRT
6.00 x 6.00 x 21.5 mm
