hoanganhidi0822/Self-Blancing-Robot/HardwareDesign/jgb37-520-1.snapshot.2/DC MOTOR, JGB37-520.SLDPRT

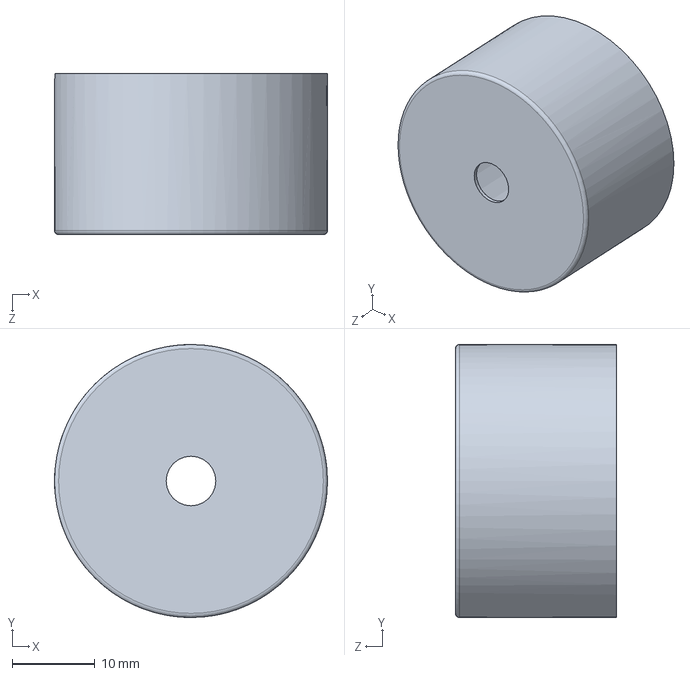
[picture p118: CAD file, 2024-08-01]
HardwareDesign/jgb37-520-1.snapshot.2/DC MOTOR, JGB37-520.SLDPRT
33.0 x 33.0 x 19.5 mm
