hoanganhidi0822/Self-Blancing-Robot/HardwareDesign/jgb37-520-1.snapshot.2/SHAFT COUPLER, JGB37-520.SLDPRT

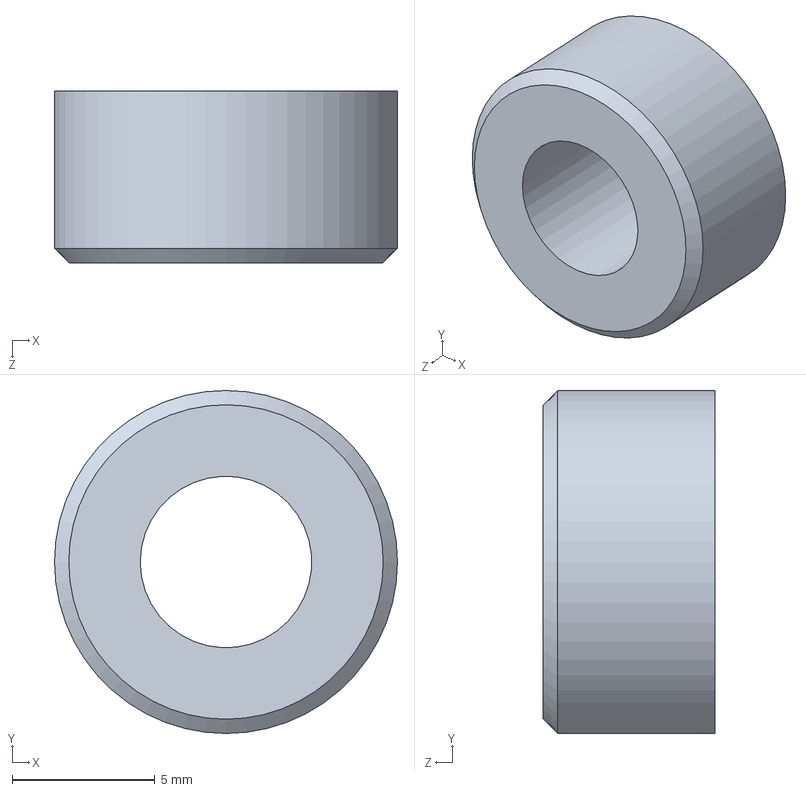
[picture p120: CAD file, 2024-08-01]
HardwareDesign/jgb37-520-1.snapshot.2/SHAFT COUPLER, JGB37-520.SLDPRT
12.0 x 12.0 x 6.00 mm
