hoanganhidi0822/Self-Blancing-Robot/(list of files, cad)

Other CAD files:
DeDuoi.ipt
DeDuoi_MIR.ipt
DeGiua.ipt
DeGiua_MIR.ipt
HardwareDesign/37-mm-dc-geared-motor-mounting-bracket-1.snapshot.11/37 mm DC Geared Motor Mounting Bracket.SLDPRT
HardwareDesign/37-mm-dc-geared-motor-mounting-bracket-1.snapshot.11/37 mm DC Geared Motor Mounting Bracket.ipt
HardwareDesign/37-mm-dc-geared-motor-mounting-bracket-1.snapshot.11/37 mm DC Geared Motor Mounting Bracket.x_b
HardwareDesign/37-mm-dc-geared-motor-mounting-bracket-1.snapshot.11/37 mm DC Geared Motor Mounting Bracket_MIR.ipt
HardwareDesign/37-mm-dc-geared-motor-mounting-bracket-1.snapshot.11/OldVersions/37 mm DC Geared Motor Mounting Bracket.0001.ipt
HardwareDesign/Battery.ipt
HardwareDesign/MatTren.ipt
HardwareDesign/MatTren_MIR.ipt
HardwareDesign/Mohinh3D.iam
HardwareDesign/OldVersions/MatTren.0004.ipt
HardwareDesign/OldVersions/MatTren_MIR.0002.ipt
HardwareDesign/OldVersions/Mohinh3D.0015.iam
HardwareDesign/OldVersions/Trudong30.0002.ipt
HardwareDesign/OldVersions/Trudong35.0002.ipt
HardwareDesign/Trudong30.ipt
HardwareDesign/Trudong30_MIR.ipt
HardwareDesign/Trudong35.ipt
HardwareDesign/Trudong35_MIR.ipt
HardwareDesign/jgb37-520-1.snapshot.2/JGB37-520.SLDASM
HardwareDesign/jgb37-520-1.snapshot.2/JGB37-520.ipt
HardwareDesign/jgb37-520-1.snapshot.2/JGB37-520.x_b
HardwareDesign/jgb37-520-1.snapshot.2/JGB37-520_MIR.ipt
HardwareDesign/jgb37-520-1.snapshot.2/OldVersions/JGB37-520.0001.ipt
HardwareDesign/l298-module-1.snapshot.14/L298N Stepper Motor Driver (Red).ipt
HardwareDesign/l298-module-1.snapshot.14/L298N Stepper Motor Driver (Red)_MIR.ipt
HardwareDesign/l298-module-1.snapshot.14/OldVersions/L298N Stepper Motor Driver (Red).0001.ipt
OldVersions/DeDuoi.0008.ipt
OldVersions/DeGiua.0007.ipt
OldVersions/MatTren.0003.ipt
OldVersions/Mohinh3D.0007.iam
OldVersions/Trudong30.0001.ipt
OldVersions/Trudong35.0001.ipt
