hoanganhidi0822/Self-Blancing-Robot/Mohinh3D-1.pdf

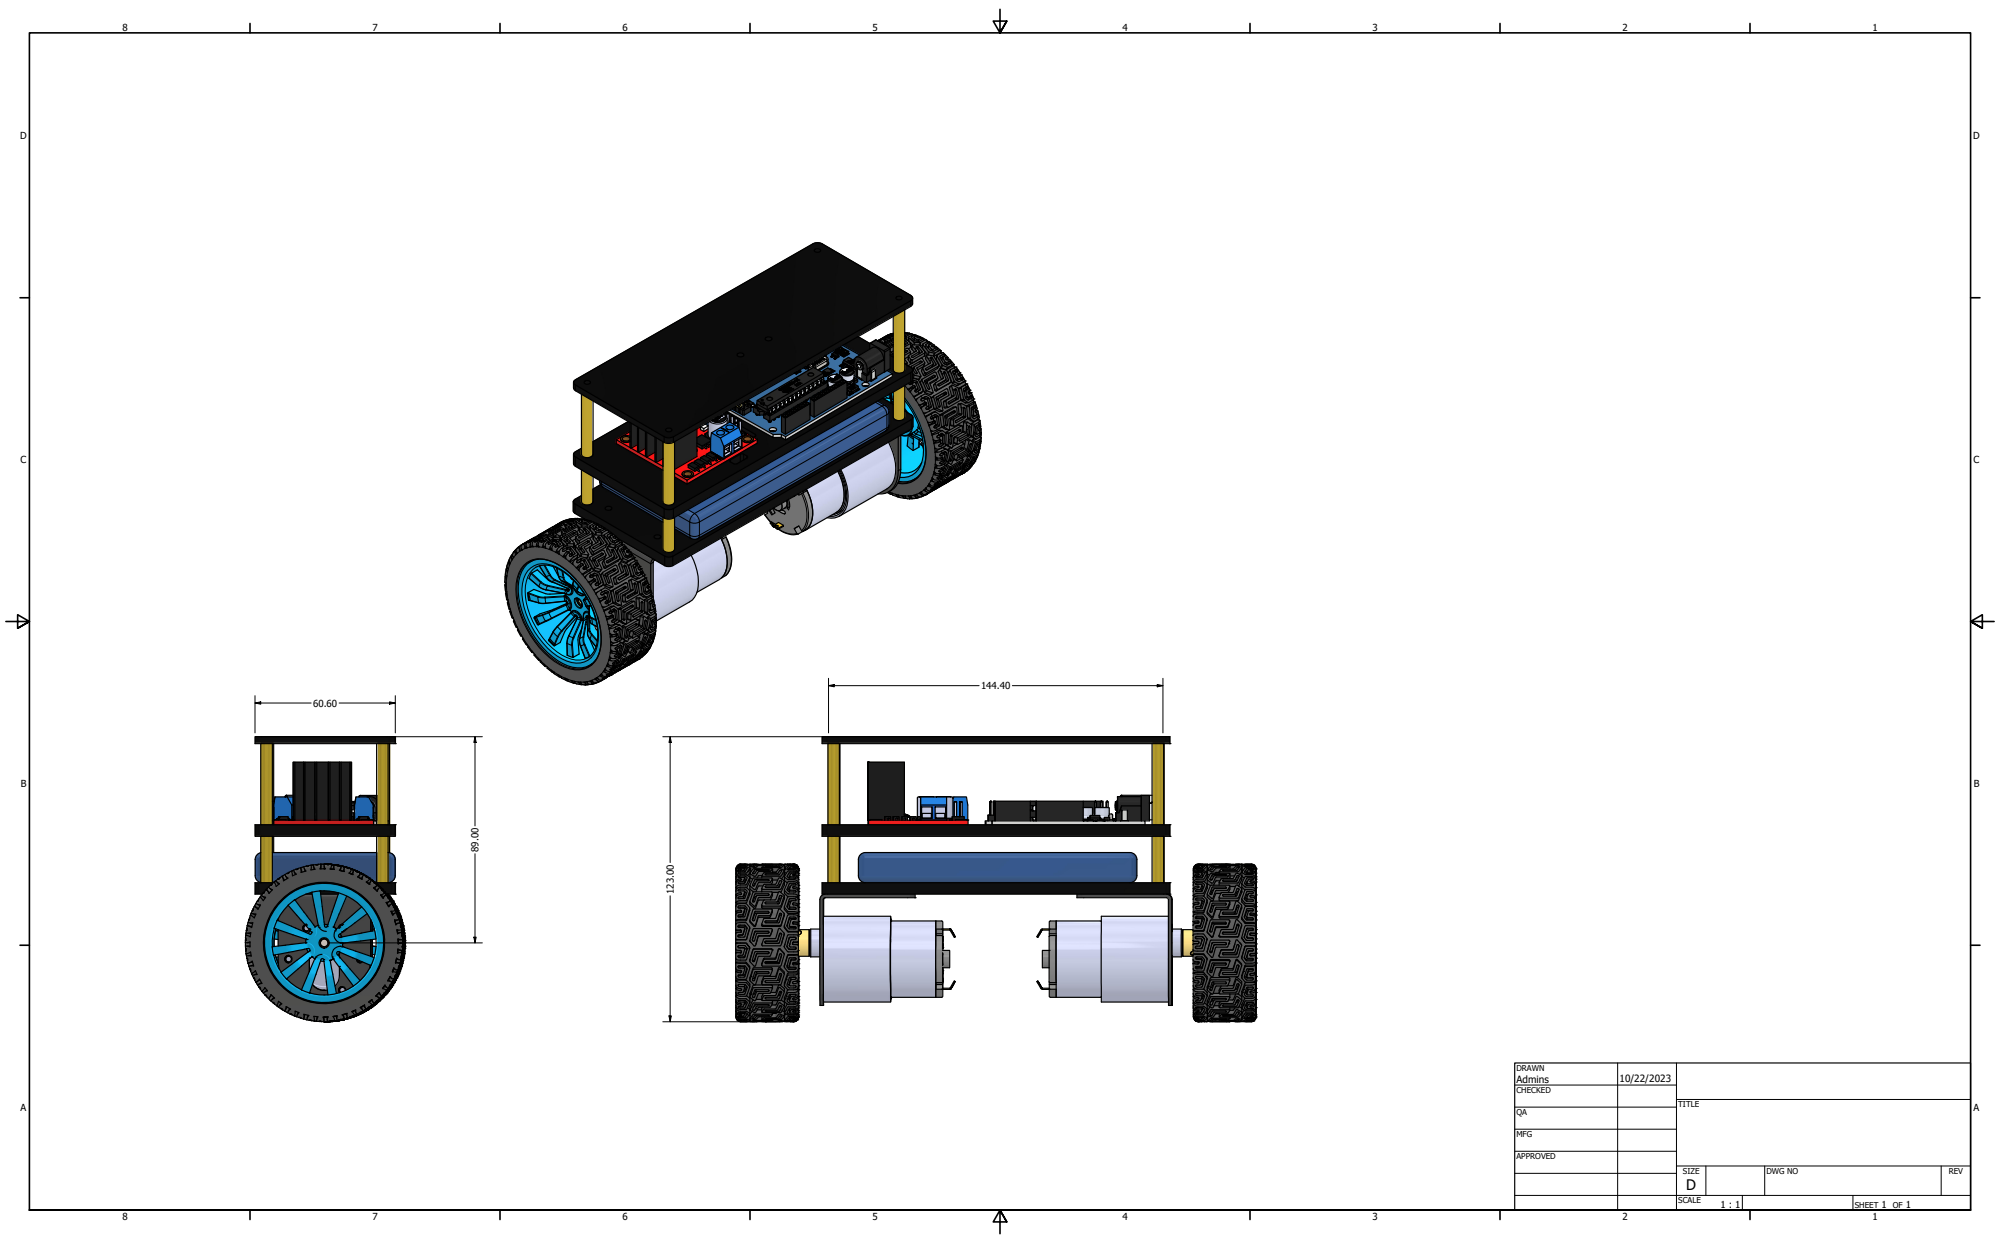
[picture p121: page 1]
SHEET 1 OF 1; DWG NO
